imatlopez/EMG-Decoder/Mechanical/Final Mechanical Drawings and Photos/Physical2.JPG

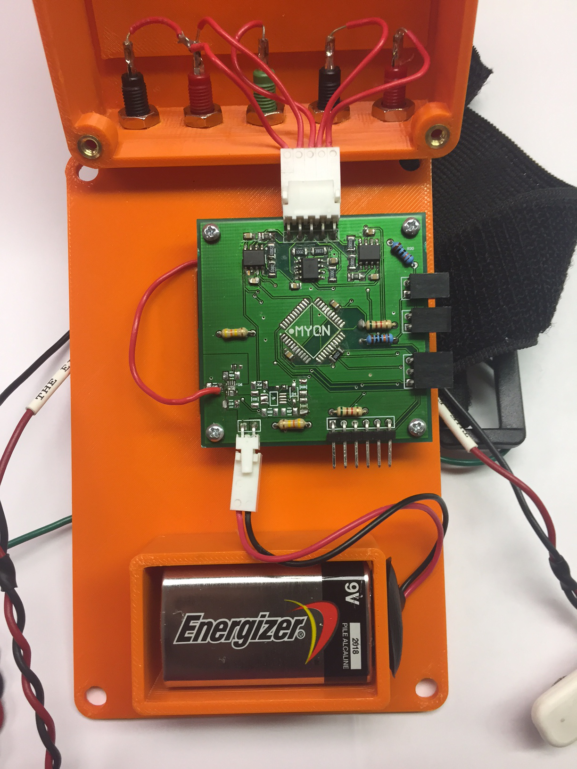
Mechanical/Final Mechanical Drawings and Photos/Physical2.JPG
