imatlopez/EMG-Decoder/Mechanical/Final Mechanical Drawings and Photos/Final Assembly Image.JPG

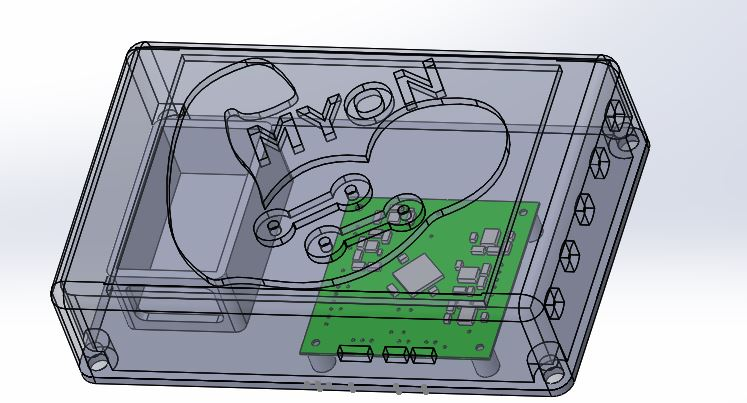
Mechanical/Final Mechanical Drawings and Photos/Final Assembly Image.JPG
