imatlopez/EMG-Decoder/Mechanical/SolidWorks Project/Mechanical Graded Checkpoint.pptx

## Mechanical Graded Checkpoint

## New Bottom Plate Design

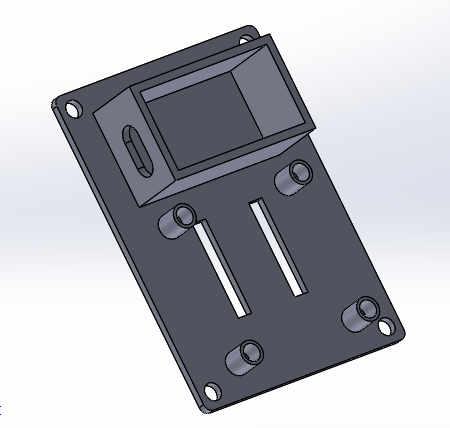
[picture p3: figure]

- 9 V battery holder
- All connections will be made with 6-32 heat inserts (diameter of holes are 0.220 inches and a draft angle of 2 degrees)
- Four elevated spacers 1.74 inches apart from each other.
- Velcro holes in order to attach to arm.

## New Cover Design

- A total of five female 2mm jack pin connectors (ground and leads)
- Two output slots (dimensions aren’t yet set)
- Case with logo on top
- Fillets with a radius of 0.1 inches for sleekness
- 3 by 4 by 1

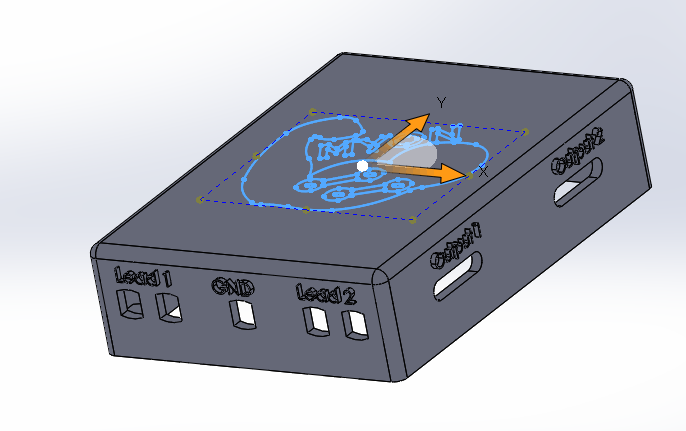
[picture p4: figure]

## Lead Connections

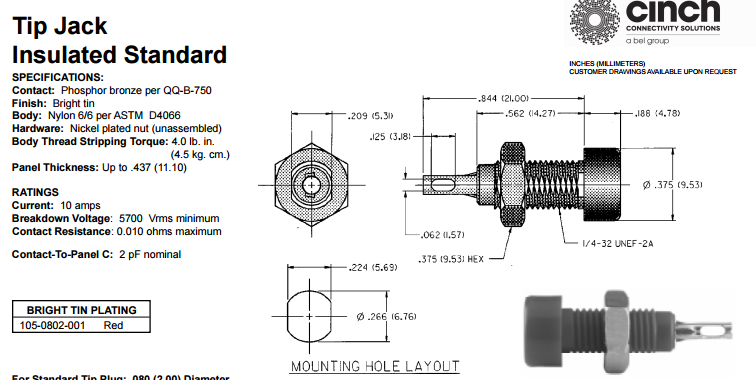
[picture p5: figure]

## Mechanical Drawings

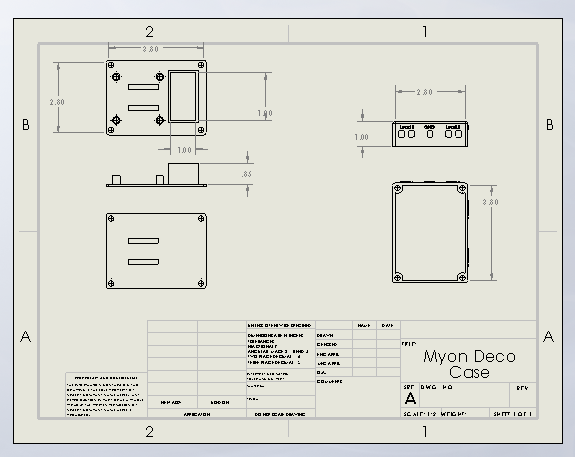
[picture p6: figure]

## Assembly View

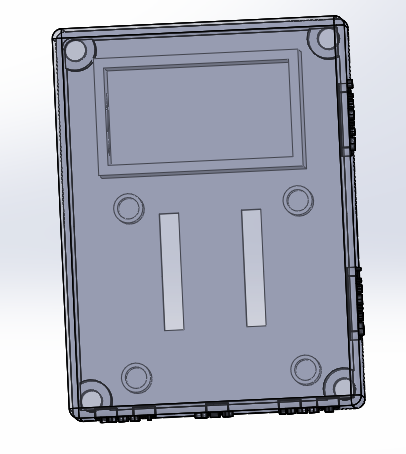
[picture p7: figure]
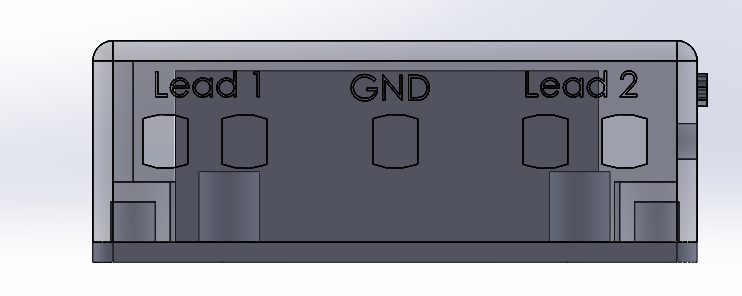
[picture p8: figure]

## Holding the Electrodes

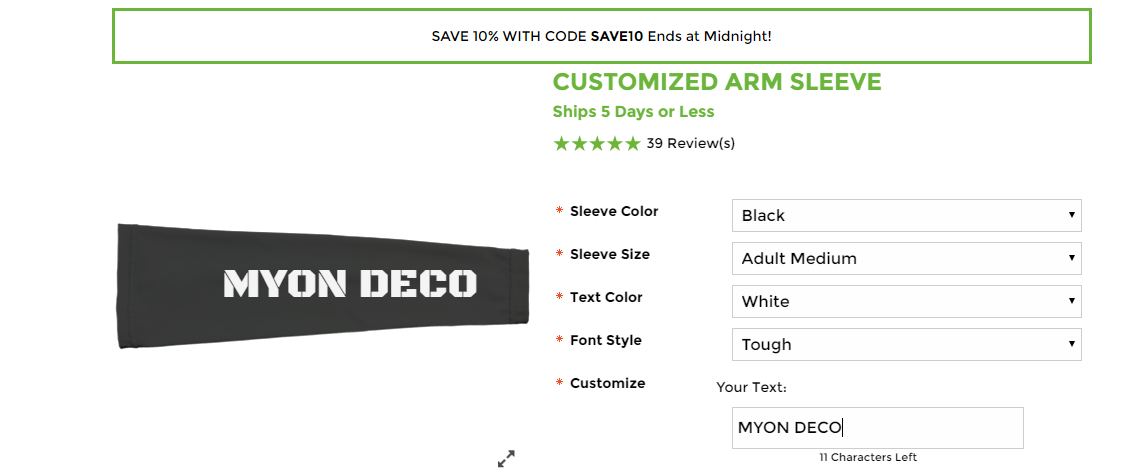
[picture p9: figure]

## Order Form for This Week

## Things still need to be done

- Need to determine output connections
- Test the heat set screws with new case and bottom plate
- Figure out compression sleeve
- Optimize location of input and output ports
