imatlopez/EMG-Decoder/Images/block.pdf

Sallen-Key
Low-Pass
Filter

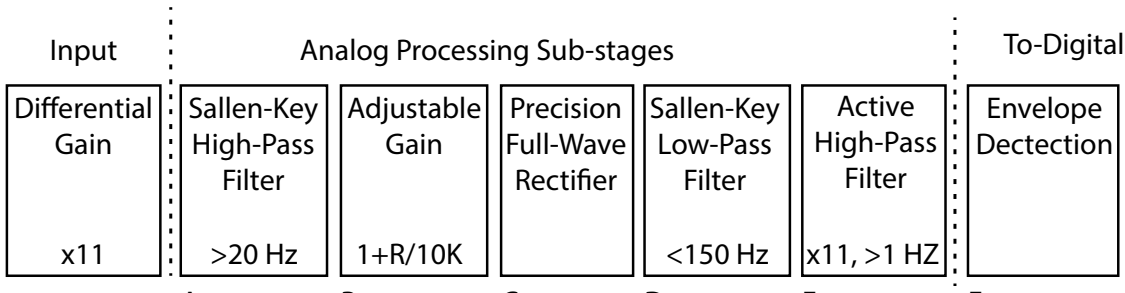
[picture p10: figure]
Dierential Gain; Sallen-Key High-Pass Filter; Adjustable Gain; Precision Full-Wave Rectier; Sallen-Key Low-Pass Filter; Active High-Pass Filter; Envelope Dectection; Input

Analog Processing Sub-stages | To-Digital Processing
x11 | >20 Hz | 1+R/10K | <150 Hz | x11, >1 HZ | x1.51, <5 Hz
A | B | C | D | E | F | G
