imatlopez/EMG-Decoder/Images/logo.pdf

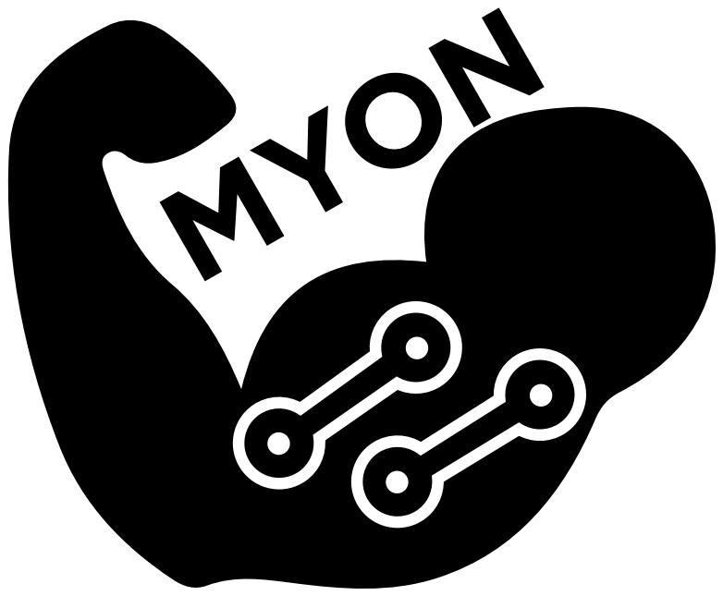
[picture p11: figure]
MYON
