imatlopez/EMG-Decoder/Images/amputee.png

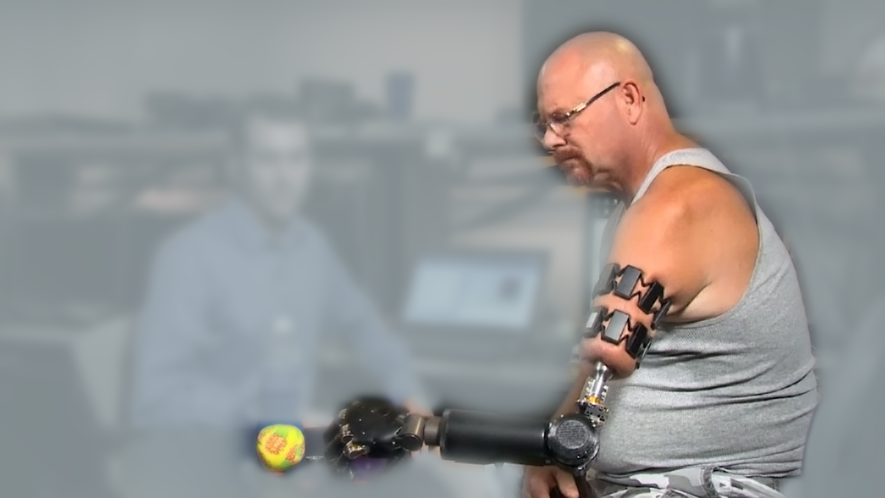
Images/amputee.png
