imatlopez/EMG-Decoder/Images/amputeecoalition.png

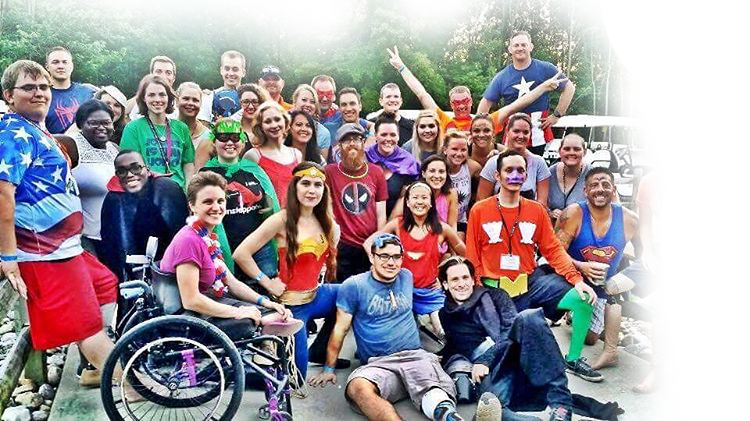
Images/amputeecoalition.png
