imatlopez/EMG-Decoder/Images/armband-proto.png

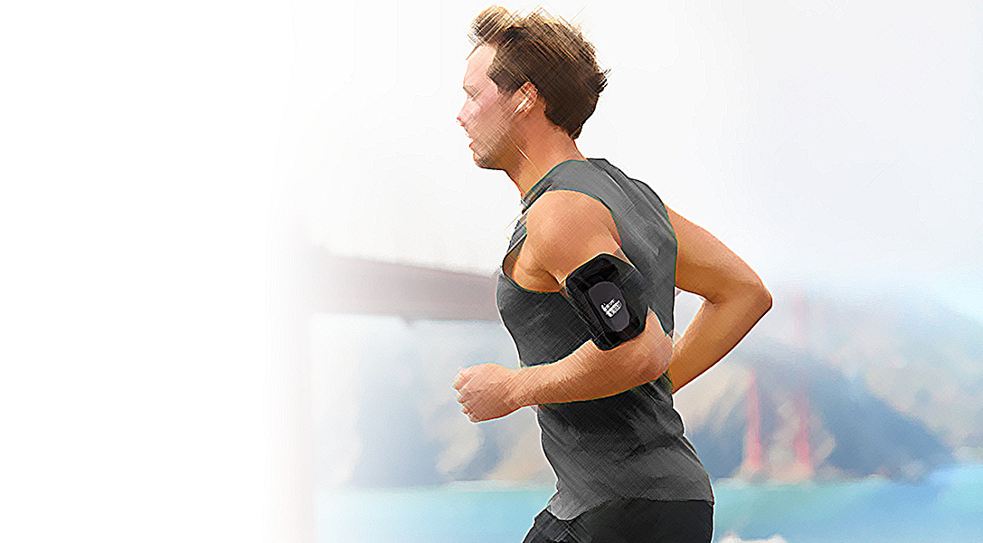
Images/armband-proto.png
