imatlopez/EMG-Decoder/Images/box.png

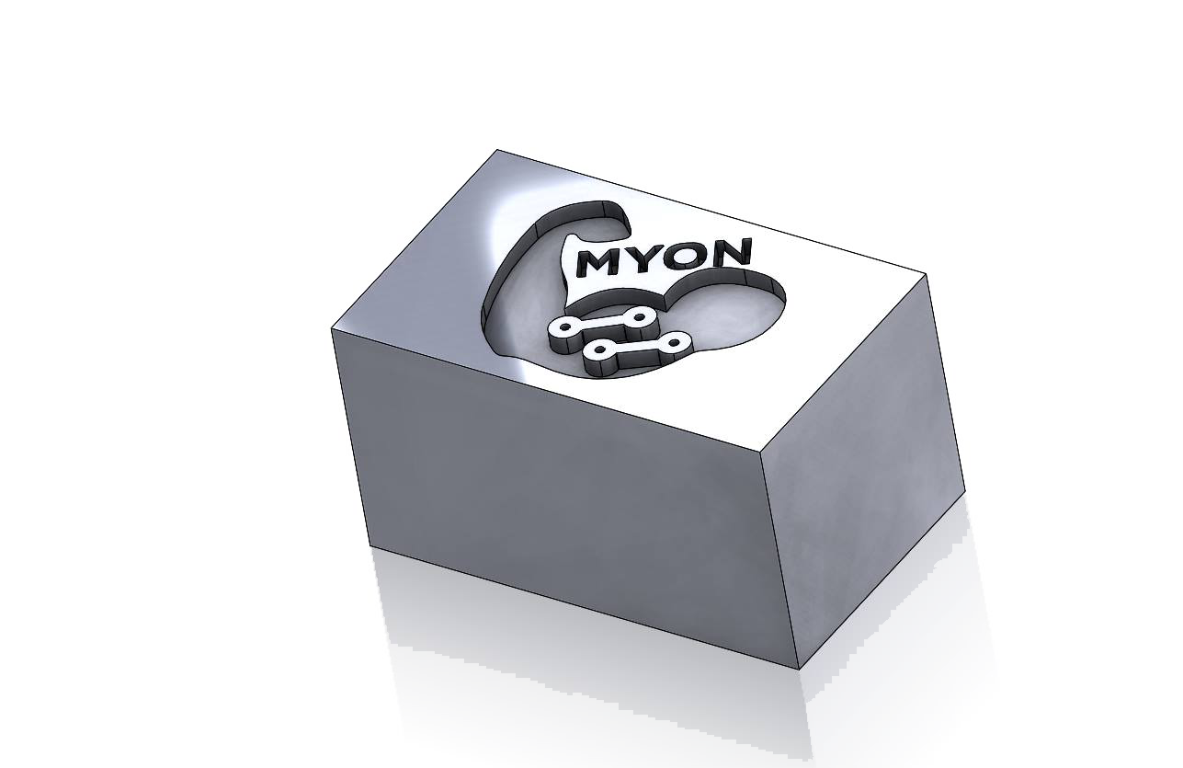
Images/box.png
