imatlopez/EMG-Decoder/Images/drone.png

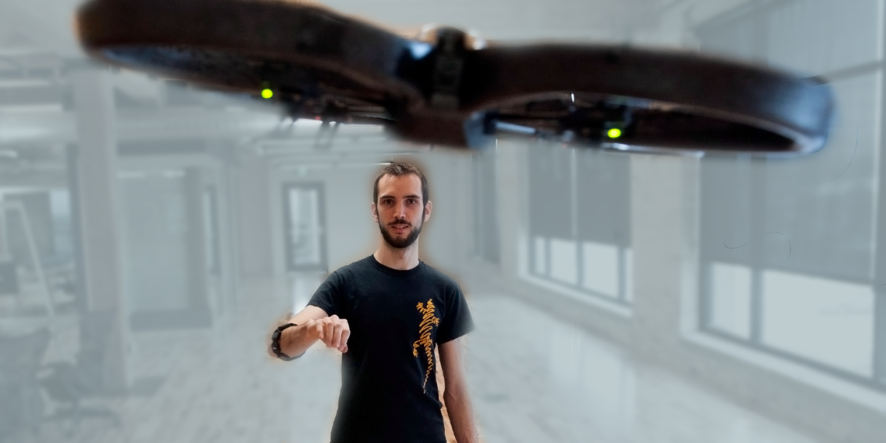
Images/drone.png
