imatlopez/EMG-Decoder/Images/muscle.png

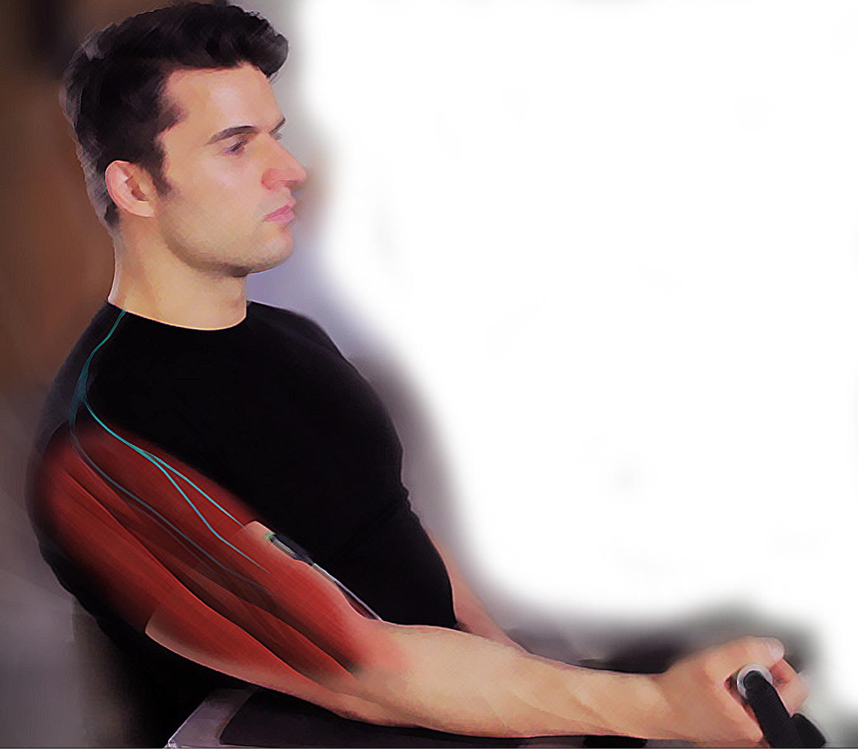
Images/muscle.png
