imatlopez/EMG-Decoder/Images/myovis.png

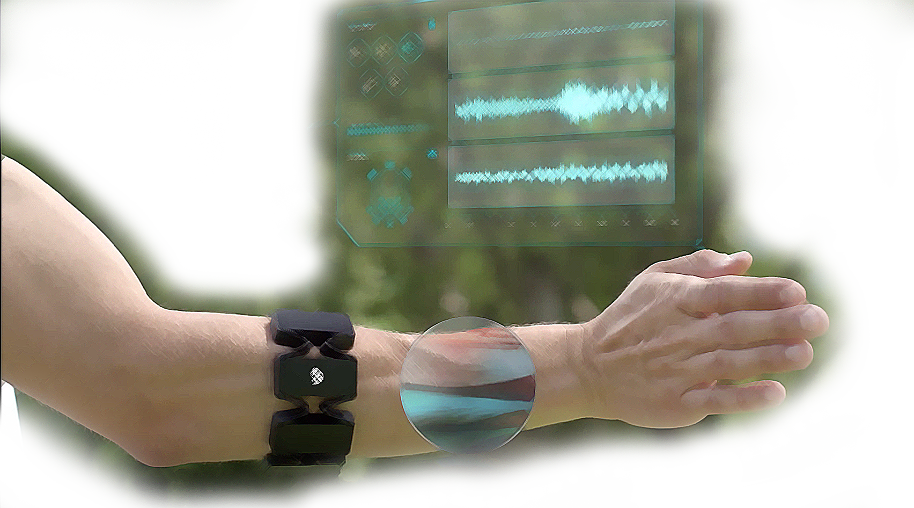
Images/myovis.png
