imatlopez/EMG-Decoder/Images/physther.png

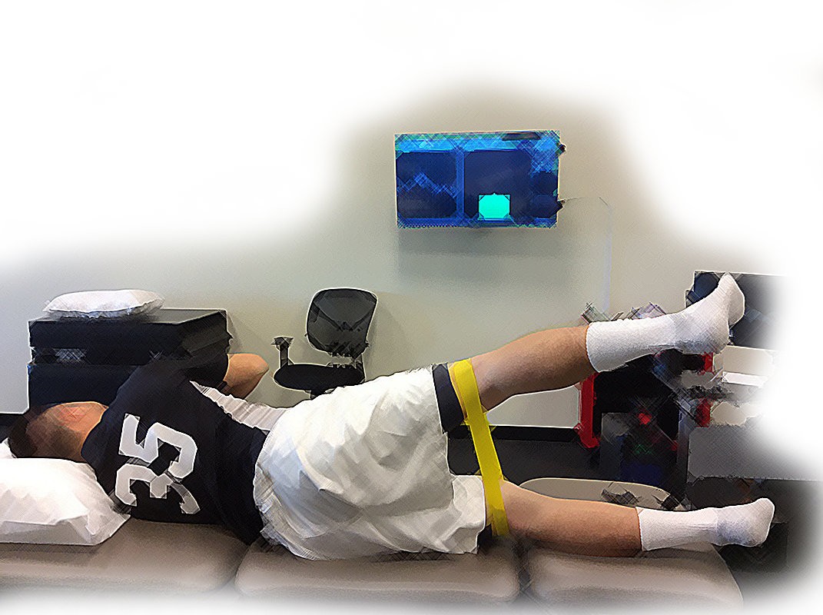
Images/physther.png
