imatlopez/EMG-Decoder/Images/surgery.png

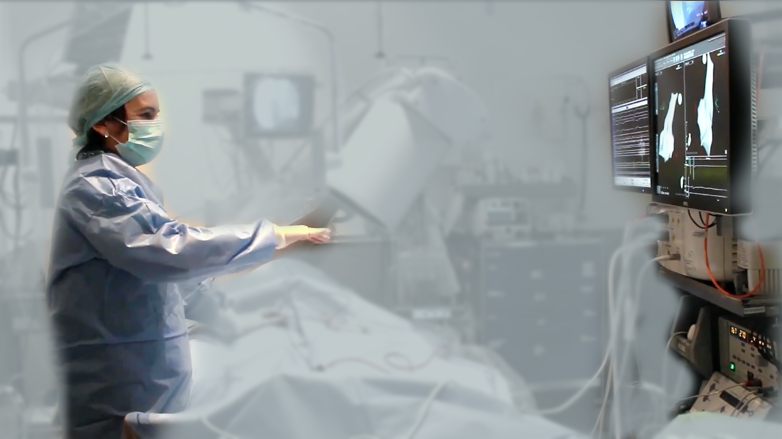
Images/surgery.png
