imatlopez/EMG-Decoder/Mechanical/Final Mechanical Drawings and Photos/FinalBottomplateDrawing.JPG

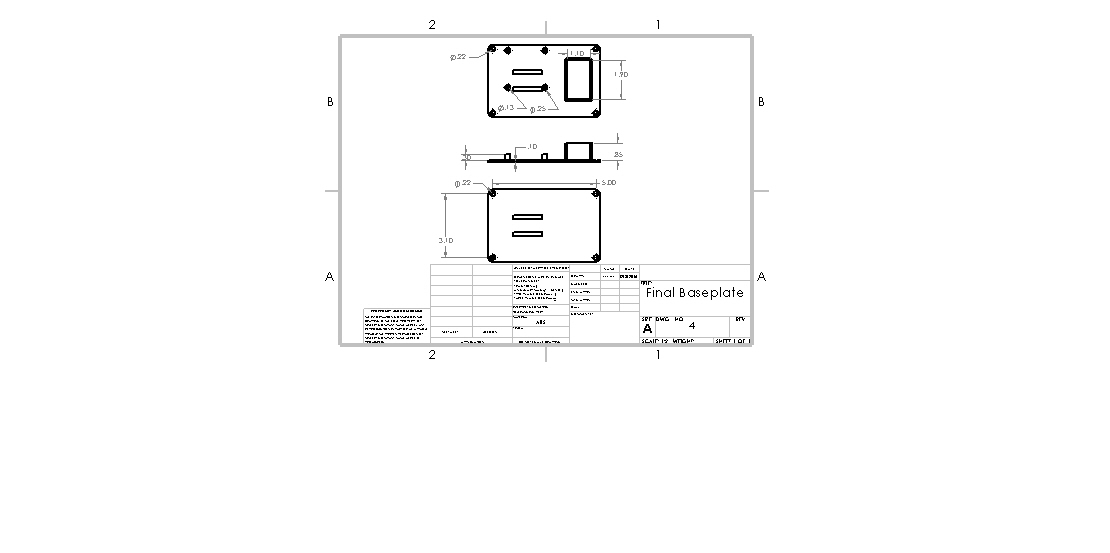
Mechanical/Final Mechanical Drawings and Photos/FinalBottomplateDrawing.JPG
