imatlopez/EMG-Decoder/Mechanical/Final Mechanical Drawings and Photos/FinalCoverDrawing.JPG

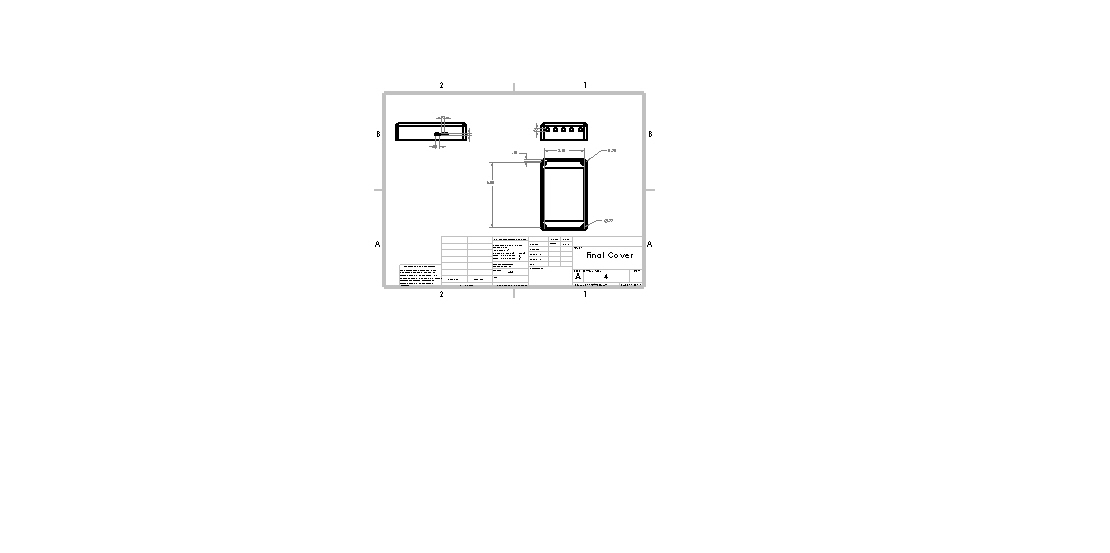
Mechanical/Final Mechanical Drawings and Photos/FinalCoverDrawing.JPG
