imatlopez/EMG-Decoder/Mechanical/Final Mechanical Drawings and Photos/Fullbody.jpg

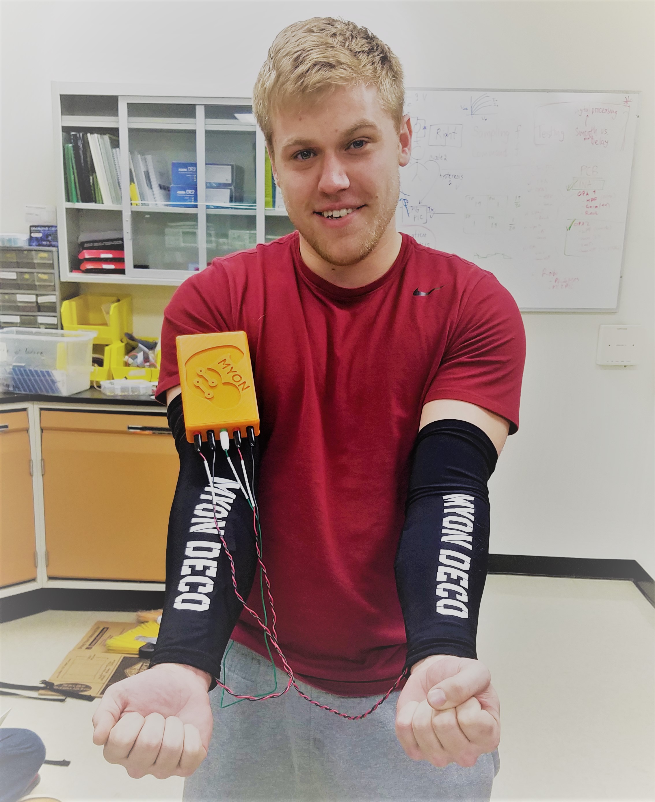
Mechanical/Final Mechanical Drawings and Photos/Fullbody.jpg
