imatlopez/EMG-Decoder/Mechanical/Final Mechanical Drawings and Photos/Physical1.JPG

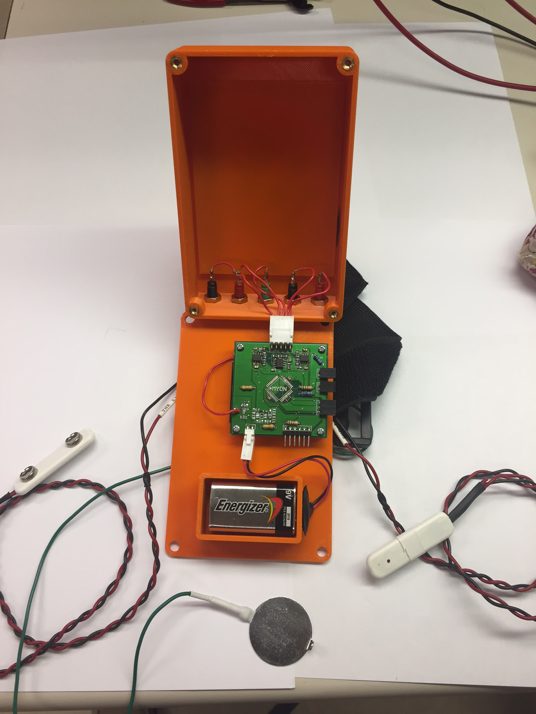
Mechanical/Final Mechanical Drawings and Photos/Physical1.JPG
