imatlopez/EMG-Decoder/Mechanical/Final Mechanical Drawings and Photos/Physical3.JPG

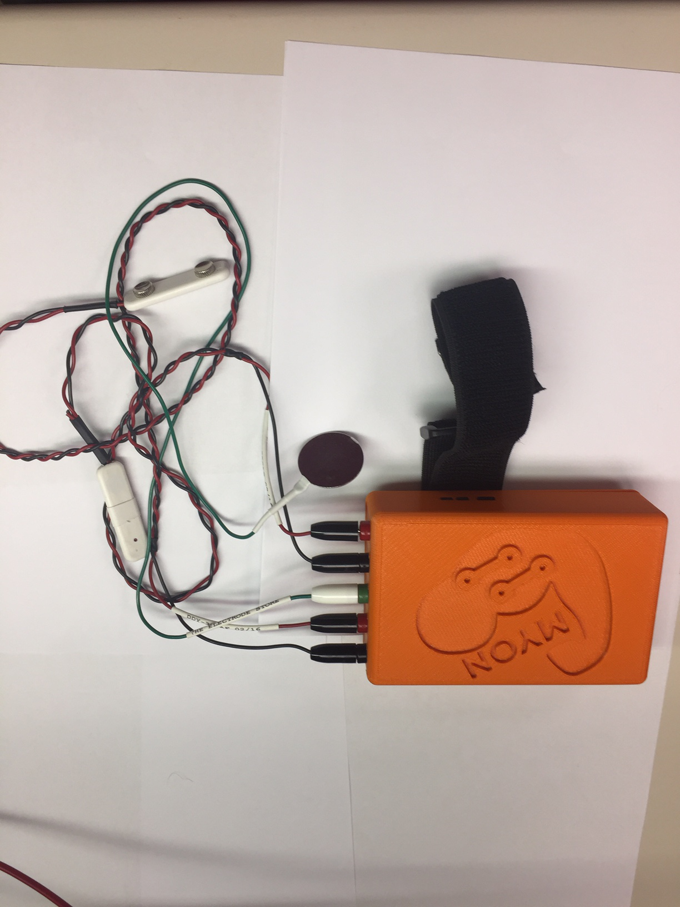
Mechanical/Final Mechanical Drawings and Photos/Physical3.JPG
