imatlopez/EMG-Decoder/Mechanical/Final Mechanical Drawings and Photos/Physical4.JPG

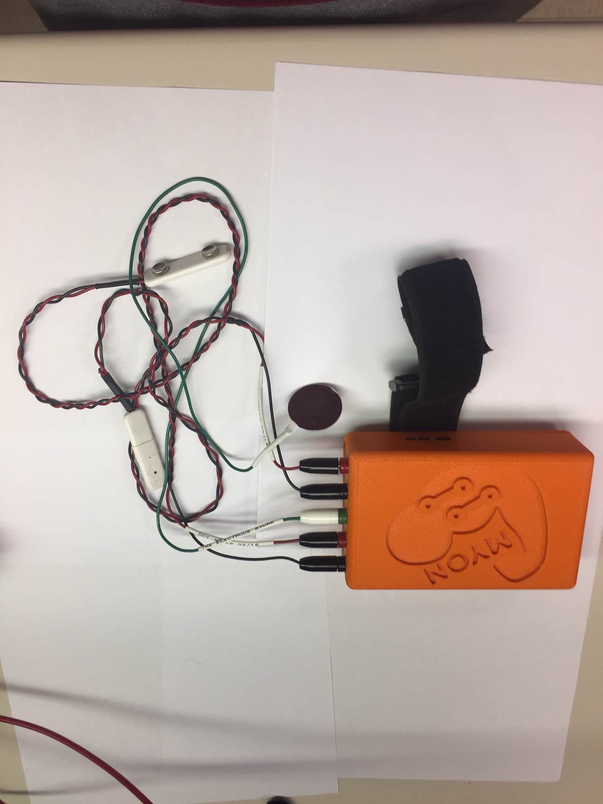
Mechanical/Final Mechanical Drawings and Photos/Physical4.JPG
