imatlopez/EMG-Decoder/Mechanical/SolidWorks Project/Invasive.PNG

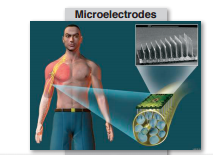
Mechanical/SolidWorks Project/Invasive.PNG
