imatlopez/EMG-Decoder/Software/SpecAutom/Anv1.png

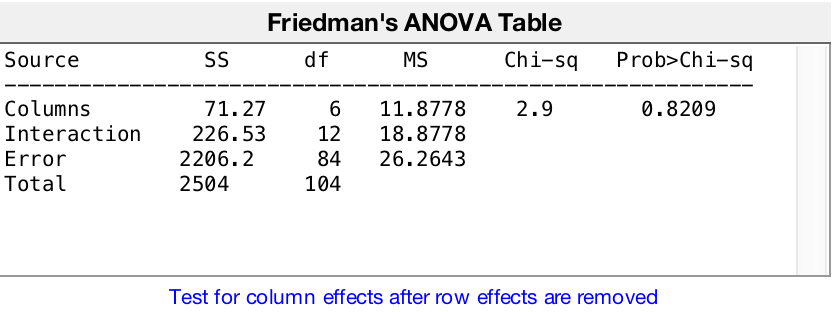
Software/SpecAutom/Anv1.png
