imatlopez/EMG-Decoder/Software/SpecAutom/CmrrAMP.png

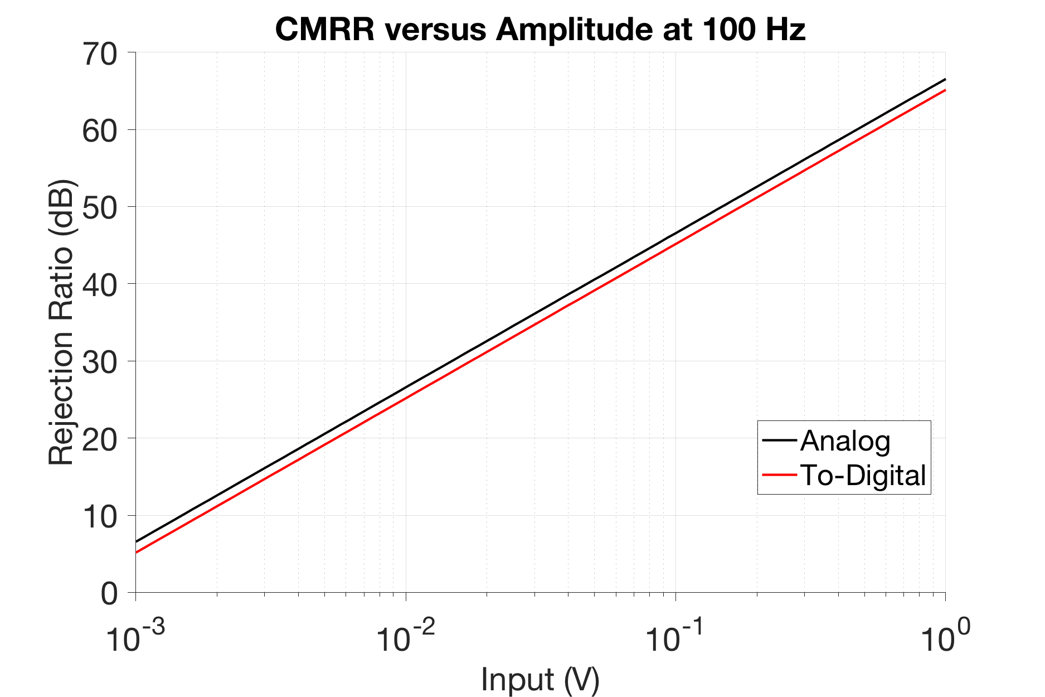
Software/SpecAutom/CmrrAMP.png
