imatlopez/EMG-Decoder/Software/SpecAutom/CmrrFRQ.png

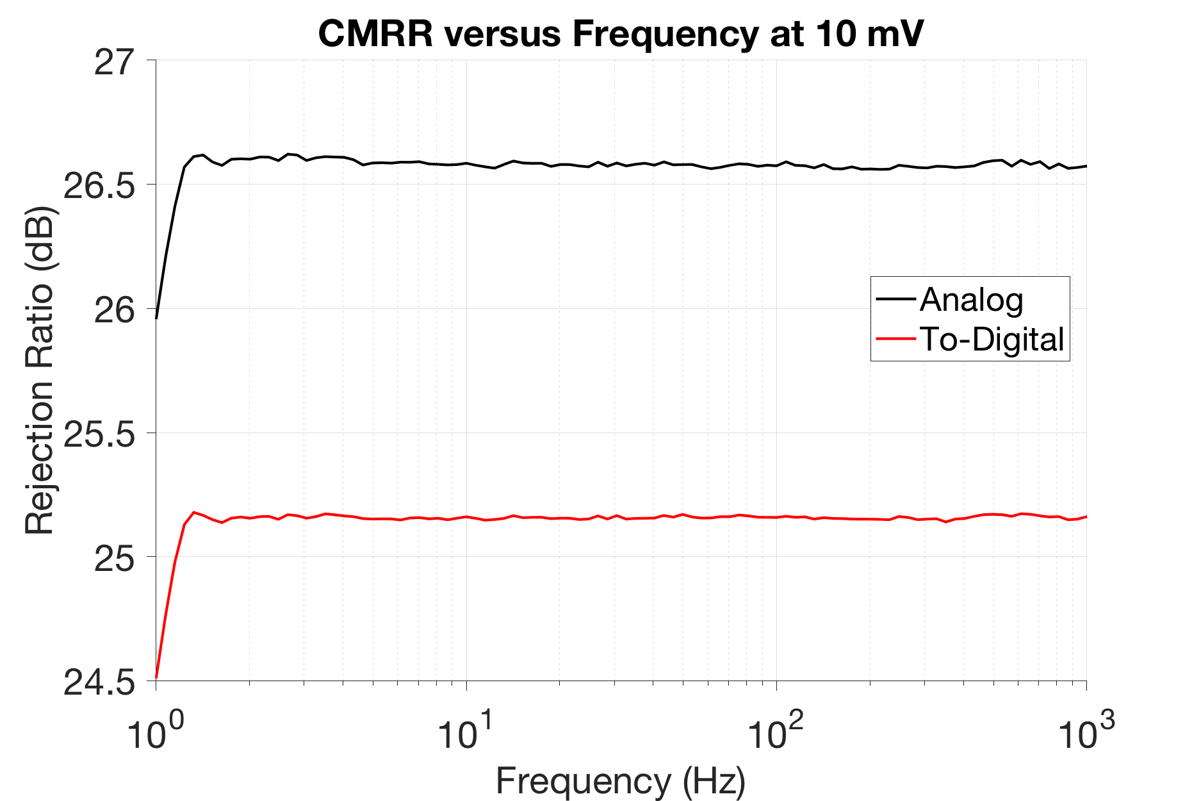
Software/SpecAutom/CmrrFRQ.png
