imatlopez/EMG-Decoder/Software/SpecAutom/FRQResp.png

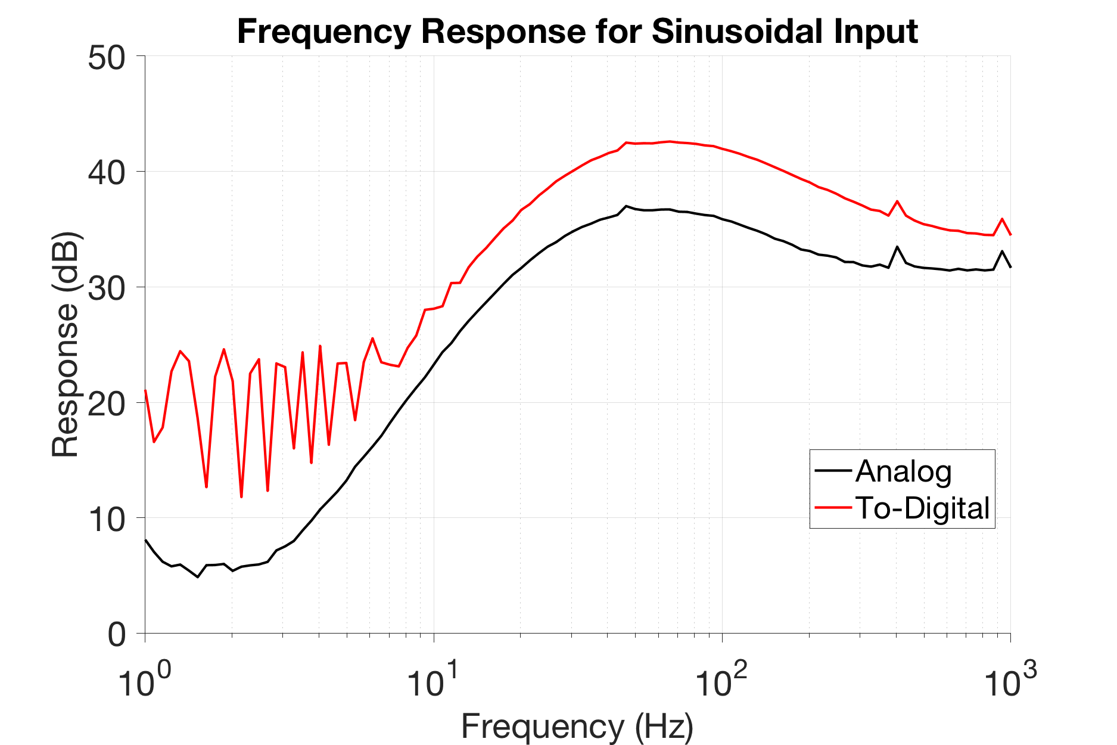
Software/SpecAutom/FRQResp.png
