imatlopez/EMG-Decoder/Software/SpecAutom/Gain.png

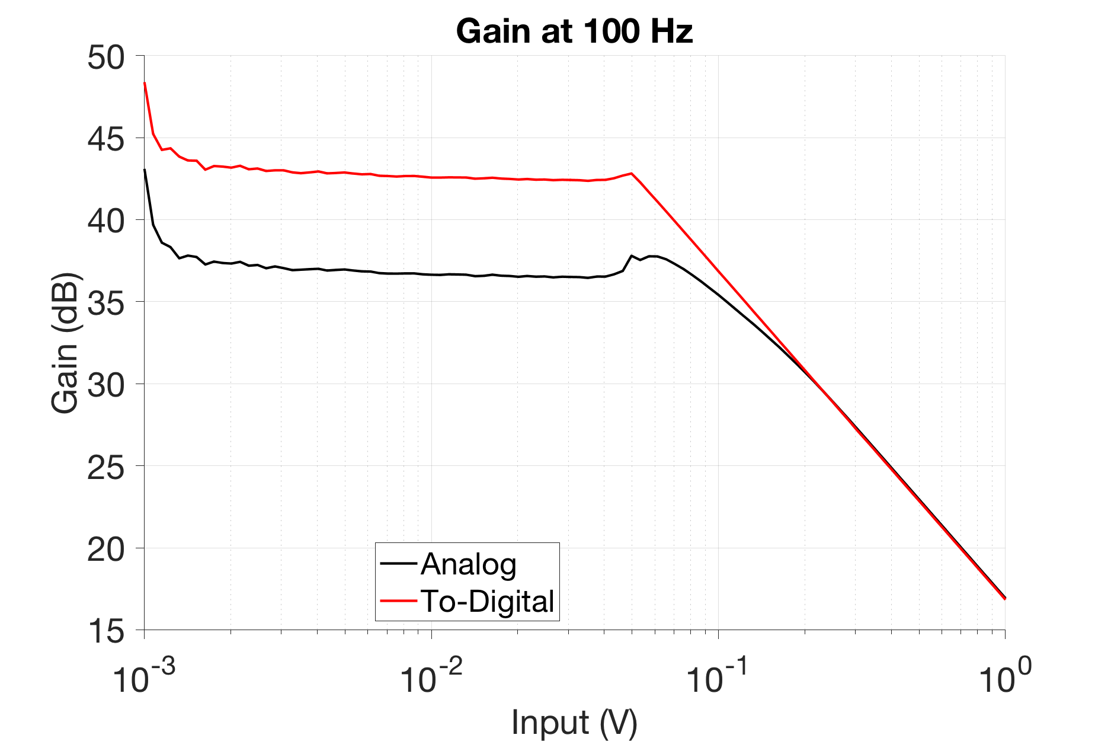
Software/SpecAutom/Gain.png
