imatlopez/EMG-Decoder/Software/SpecAutom/LpecPlot.png

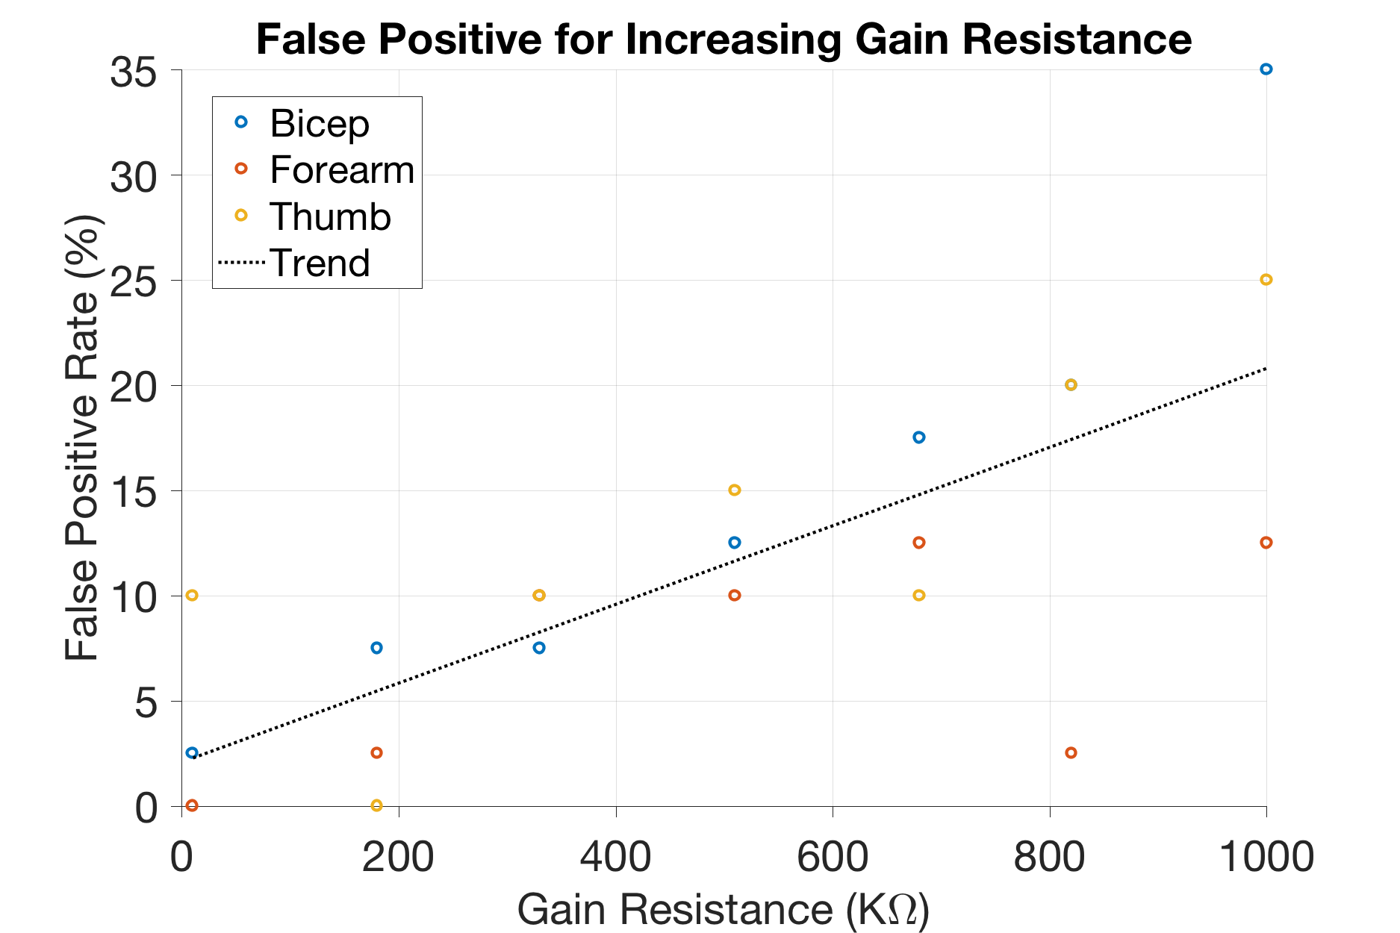
Software/SpecAutom/LpecPlot.png
