imatlopez/EMG-Decoder/Software/SpecAutom/PowerAMP.png

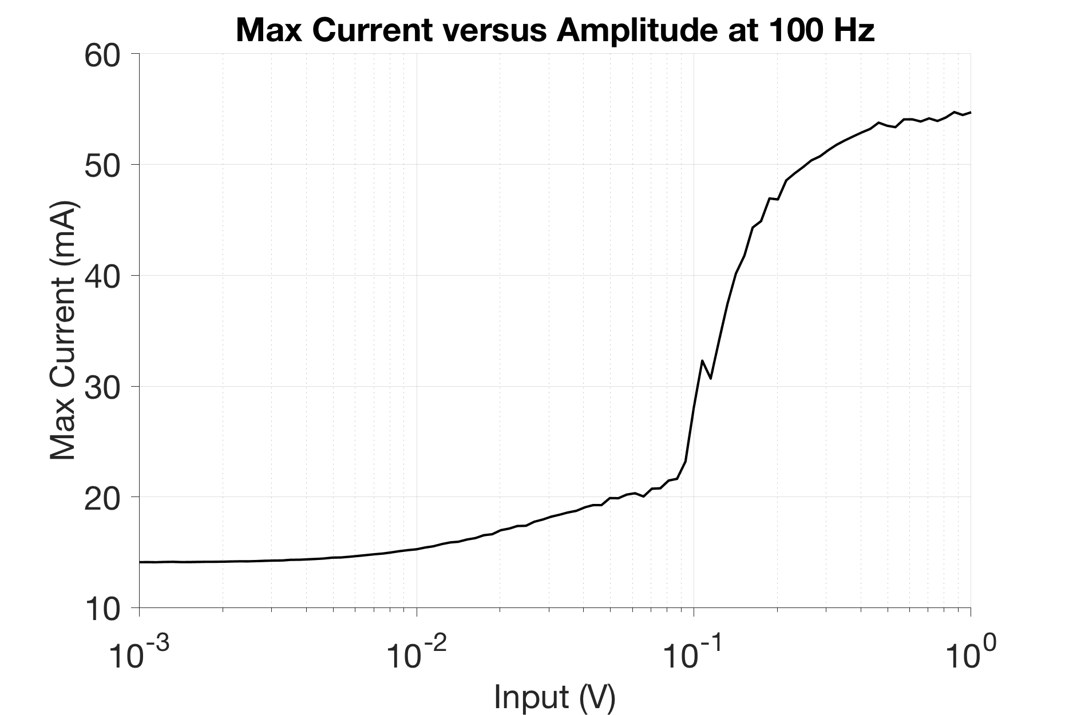
Software/SpecAutom/PowerAMP.png
