imatlopez/EMG-Decoder/Software/SpecAutom/PowerFRQ.png

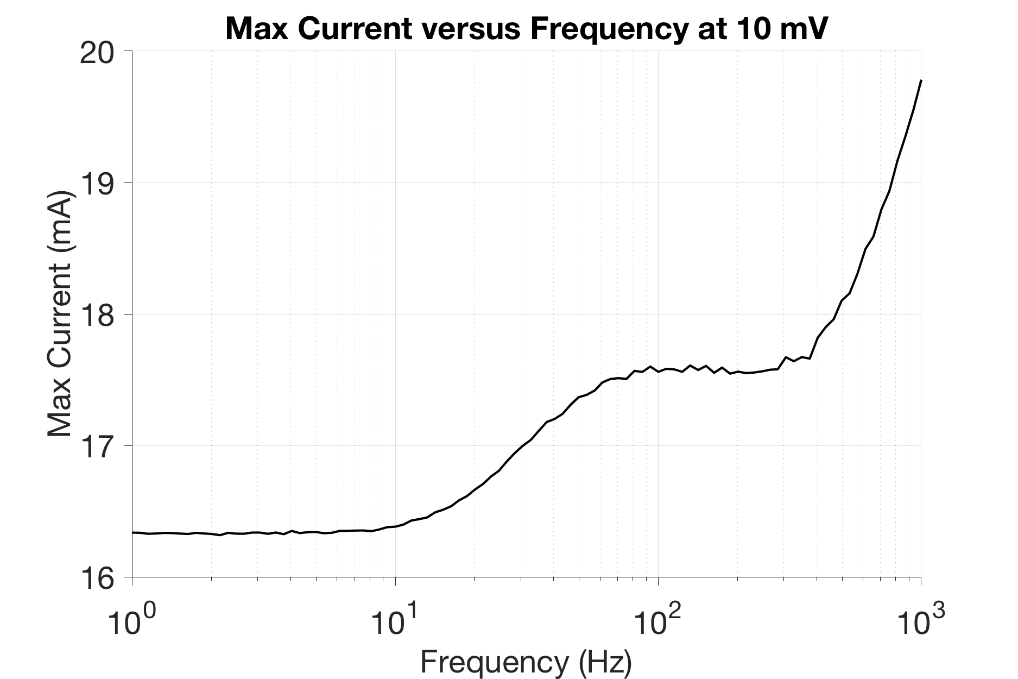
Software/SpecAutom/PowerFRQ.png
