imatlopez/EMG-Decoder/Software/SpecAutom/Proof1.png

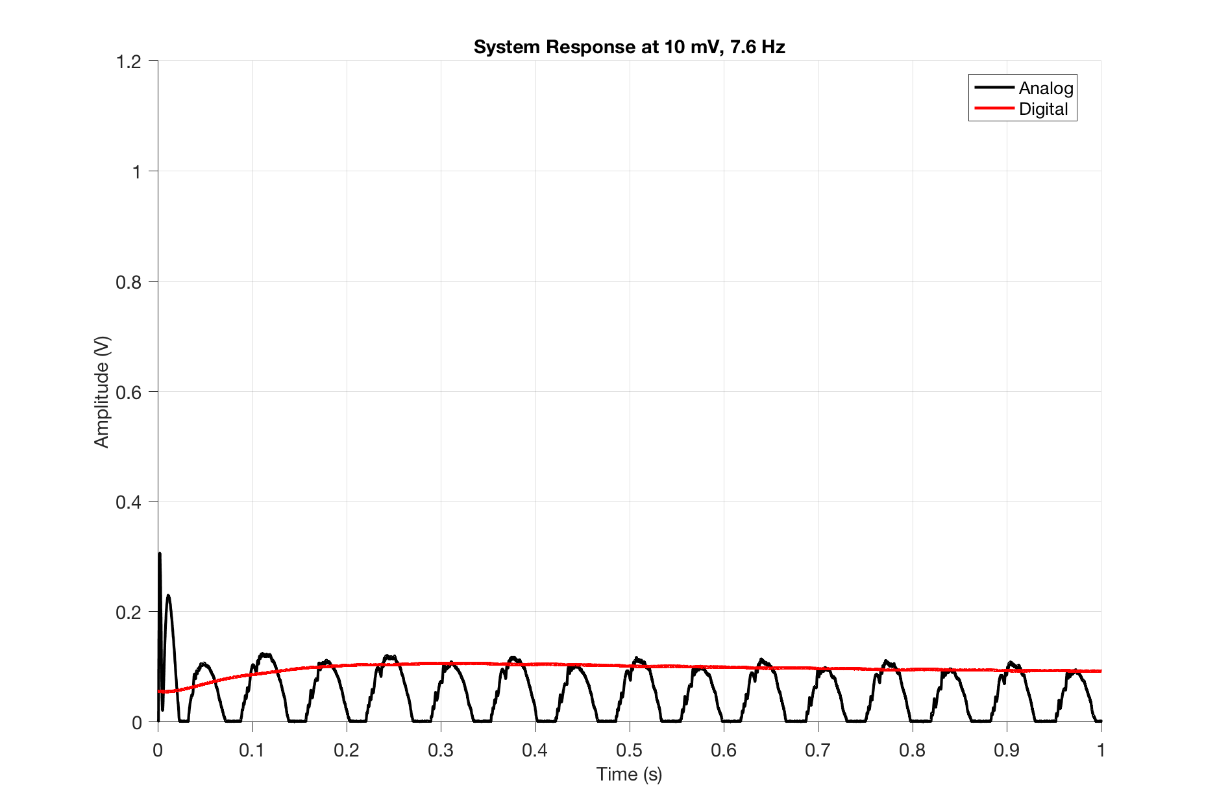
Software/SpecAutom/Proof1.png
