imatlopez/EMG-Decoder/Software/SpecAutom/Proof2.png

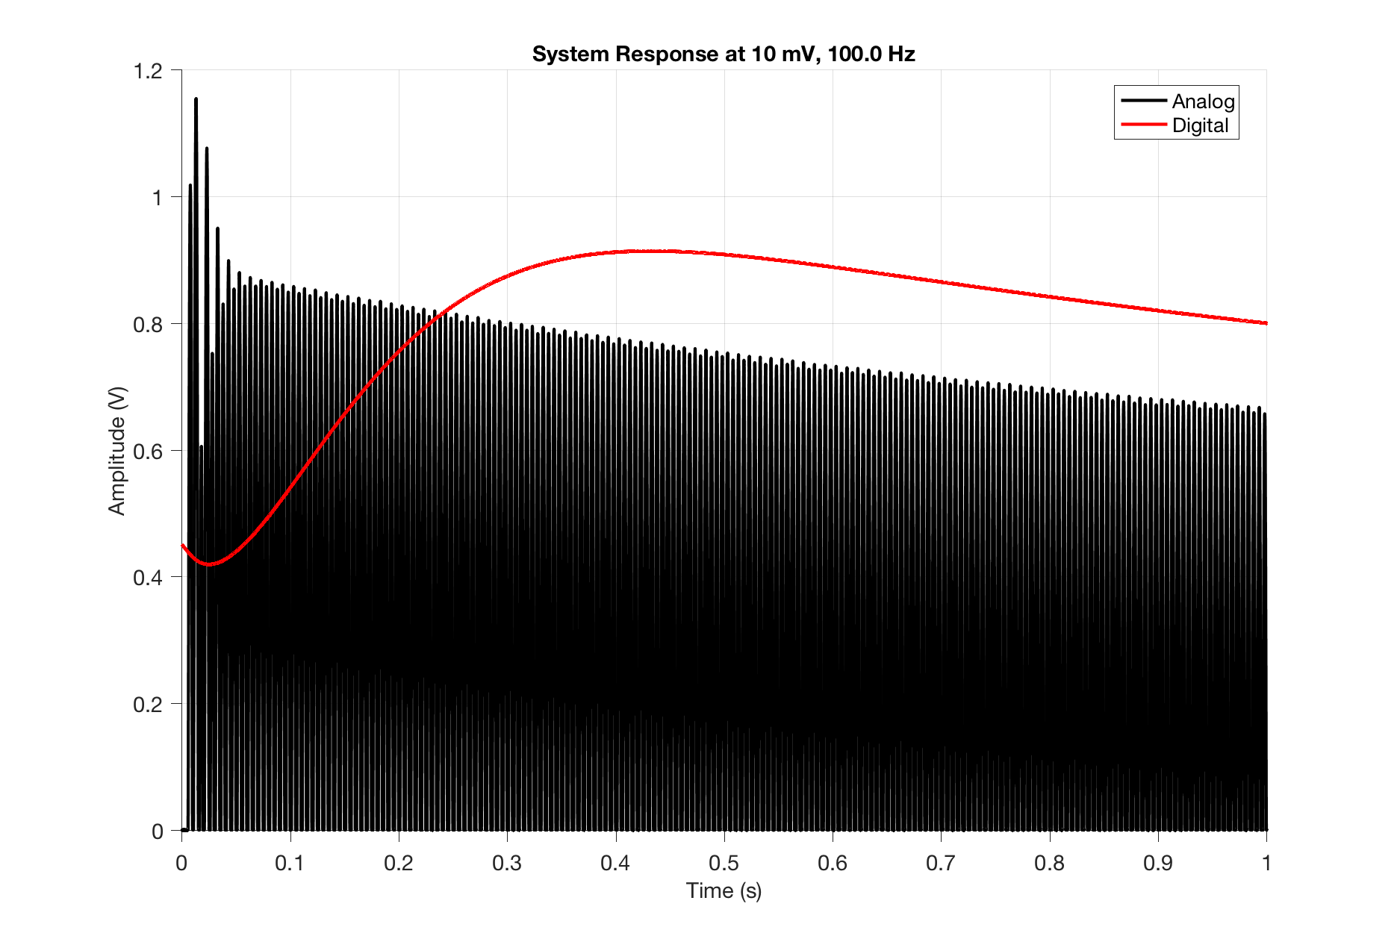
Software/SpecAutom/Proof2.png
