imatlopez/EMG-Decoder/Software/SpecAutom/Proof3.png

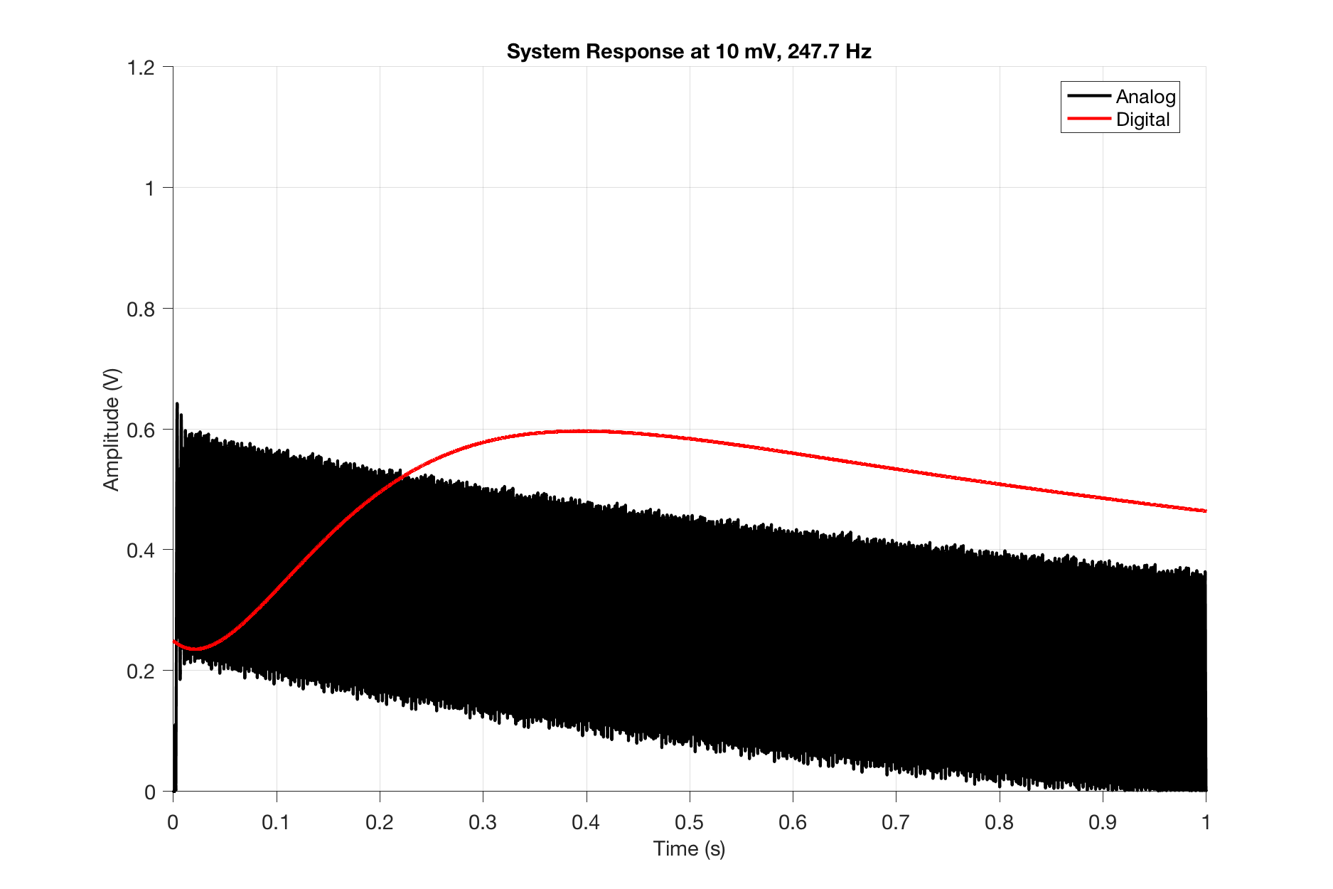
Software/SpecAutom/Proof3.png
