imatlopez/EMG-Decoder/Software/SpecAutom/SnrAMP.png

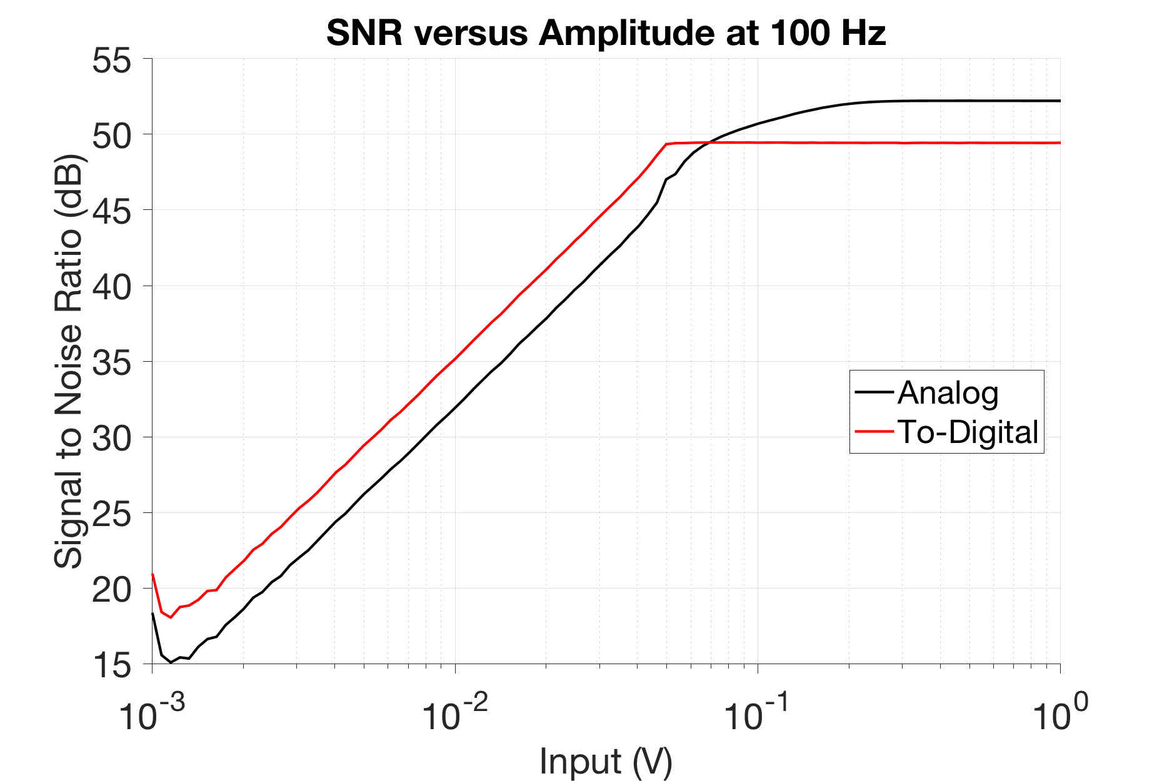
Software/SpecAutom/SnrAMP.png
