imatlopez/EMG-Decoder/Software/SpecAutom/SnrFRQ.png

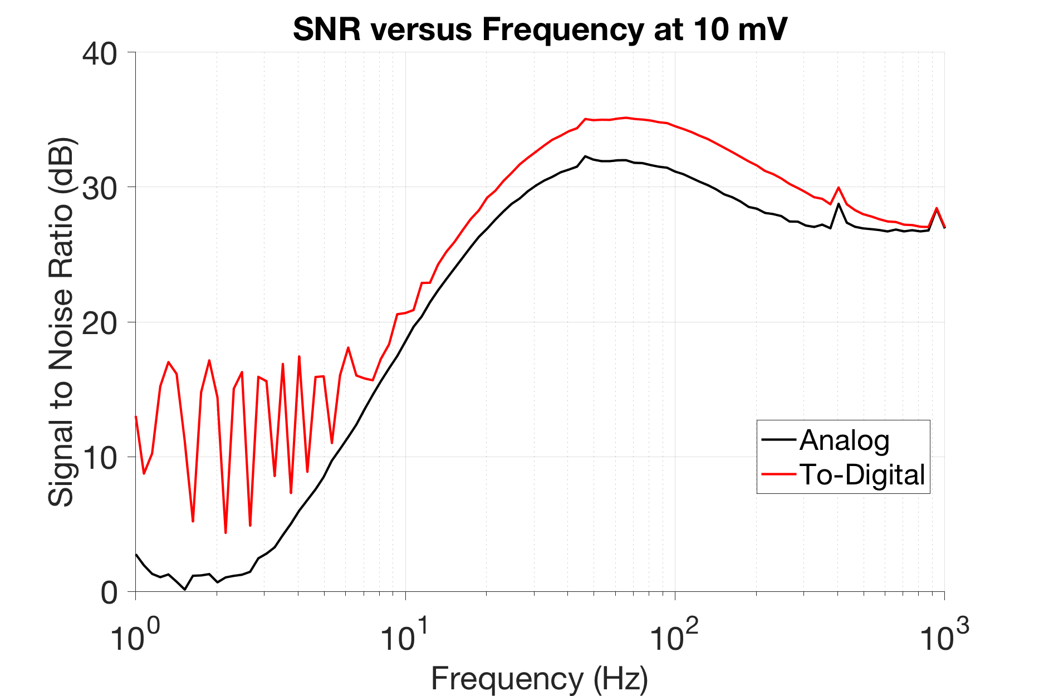
Software/SpecAutom/SnrFRQ.png
