imatlopez/EMG-Decoder/Software/SpecAutom/SpecPlot.png

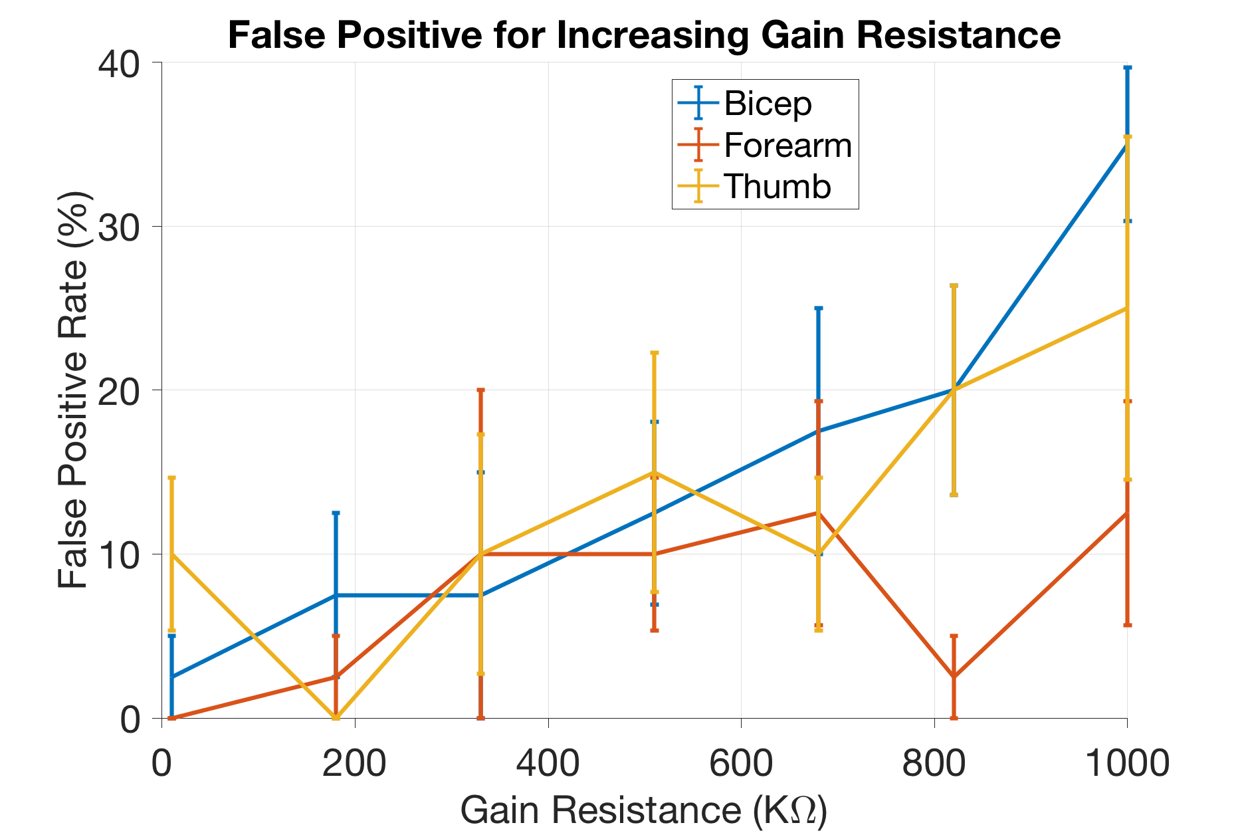
Software/SpecAutom/SpecPlot.png
