imatlopez/EMG-Decoder/Forms/Last_Order.xlsx

Name | C. Zhao | M. Lopez | A. Marellapudi | J. Scott | P. Wiboonsaksakul
Group | EMG Decoder
Date | 2016-11-11 | Orders must be submitted by email by 10 AM on Tuesday to matthewb@duke.edu to be processed on Tuesday
Vendor | Quantity | Part number | Part Description | Package | Price | Extended Price | URL (if not Mouser) | Notes
Preferred vendor is Mouser. Backups are Newark and Digikey. Please check these first for your component - arrangements can be made if your part can only come from another source (e.g. your main sensor) | Include units for quantity where necessary (5 resistors vs 5 packs of 25 resistors) |  |  | When ordering ICs, be particularly careful about package - size of chip and type of pins | Choose the right price for the quantity you are ordering - most companies offer bulk discounts | Extended price is the quantity * price |  | Include any other necessary notes for Matt to process your order
Digikey | 4 | TPS62163DGKR | 5 V Regulator | WSON8 | $2.00 | $8.00 | http://www.digikey.com/product-detail/en/texas-instruments/TPS62163DSGR/296-29898-6-ND/2782666
