imatlopez/EMG-Decoder/Forms/Mech_Order.xlsx

Name | John Scott | Aniruddh Marellapudi | Christine Zhao | Matias Lopez | Pum Wiboonsaksakul
Group | Project Name | Myon Deco
Date | Today's Date | Orders must be submitted by email by 10 AM on Tuesday to matthewb@duke.edu to be processed on Tuesday
 |  | 2016-10-23
Vendor | Quantity | Part number | Part Description | Package | Price | Extended Price | URL (if not Mouser) | Notes
Preferred vendor is Mouser. Backups are Newark and Digikey. Please check these first for your component - arrangements can be made if your part can only come from another source (e.g. your main sensor) | Include units for quantity where necessary (5 resistors vs 5 packs of 25 resistors) |  |  | When ordering ICs, be particularly careful about package - size of chip and type of pins | Choose the right price for the quantity you are ordering - most companies offer bulk discounts | Extended price is the quantity * price |  | Include any other necessary notes for Matt to process your order
Digikey | 2 | J152-ND | 2 mm jack pin connectors (black) |  | $0.65 | $1.30 | http://www.digikey.com/product-detail/en/cinch-connectivity-solutions-johnson/108-0902-001/J151-ND/5929
Digikey | 1 | J153-ND | 2mm jack pin connectors (green) |  | $0.63 | $0.63 | http://www.digikey.com/product-detail/en/cinch-connectivity-solutions-johnson/108-0904-001/J153-ND/5931
Bolt Depot | 4 | 13772 | Metric spacers, Nylon black, 4mm x 5mm (8mm O.D.). Each |  | $0.38 | 6.47 (with shipping) | https://www.boltdepot.com/Product-Details.aspx?product=13772 | 4 mm inside diameter (8 mm OD). Length is 5 mm.
Bolt Depot | 4 | 3830 | Tap stainless steel bolts that have a 5/16" diameter and a length of 1 and a half inches |  | $0.47 | $1.88 | https://www.boltdepot.com/Product-Details.aspx?product=3830 | Length of 1 and a half inches please
Bolt Depot | 4 | 2564 | Hex nuts for 5/16" tap bolt |  | $0.10 | $4.00 | https://www.boltdepot.com/Product-Details.aspx?product=2564
Bolt Depot | 4 | 2948 | Washers for 5/16" tap bolt |  | $0.06 | $0.24 | https://www.boltdepot.com/Product-Details.aspx?product=2948
