imatlopez/EMG-Decoder/Mechanical/PartsOrderForm_BME464L(Oct31).xlsx

Name | John Scott | Aniruddh Marellapudi | Christine Zhao | Matias Lopez | Pum Wiboonsaksakul
Group | Project Name | Myon Deco
Date | Today's Date | Orders must be submitted by email by 10 AM on Tuesday to matthewb@duke.edu to be processed on Tuesday
 |  | 2016-10-31
Vendor | Quantity | Part number | Part Description | Package | Price | Extended Price | URL (if not Mouser) | Notes
Preferred vendor is Mouser. Backups are Newark and Digikey. Please check these first for your component - arrangements can be made if your part can only come from another source (e.g. your main sensor) | Include units for quantity where necessary (5 resistors vs 5 packs of 25 resistors) |  |  | When ordering ICs, be particularly careful about package - size of chip and type of pins | Choose the right price for the quantity you are ordering - most companies offer bulk discounts | Extended price is the quantity * price |  | Include any other necessary notes for Matt to process your order
Digikey | 2 | PPTC031LGBN-RC | 3 position receptacle |  | $0.65 | $1.30 | http://www.digikey.com/product-search/en?keywords=PPTC031LGBN-RC
Digikey | 4 | PPTC021LGBN-RC | 2 position receptacle |  | $0.57 | $2.28 | http://www.digikey.com/product-search/en?keywords=PPTC021LGBN-RC
Custom Sports Sleeves | 1 |  | Compression Sleeve for holding EMG electrodes |  | $18.99 | $18.99 | http://www.customsportssleeves.com/customized-arm-sleeve | Would like text added to this. Font is to be "Tough". The text should read "MYON DECO". The color to be black, and the font color is white. The sleeve should be a size Medium for smaller arms
Digikey | 2 | 235 | 9V snap battery connector |  | $0.65 | $1.30 | http://www.digikey.com/product-detail/en/keystone-electronics/235/36-235-ND/303806
