imatlopez/EMG-Decoder/Forms/Power-Test_Order.xlsx

Name | C. Zhao | M. Lopez | A. Marellapudi | J. Scott | P. Wiboonsaksakul
Group | EMG Decoder
Date | 2016-11-03 | Orders must be submitted by email by 10 AM on Tuesday to matthewb@duke.edu to be processed on Tuesday
Vendor | Quantity | Part number | Part Description | Package | Price | Extended Price | URL (if not Mouser) | Notes
Preferred vendor is Mouser. Backups are Newark and Digikey. Please check these first for your component - arrangements can be made if your part can only come from another source (e.g. your main sensor) | Include units for quantity where necessary (5 resistors vs 5 packs of 25 resistors) |  |  | When ordering ICs, be particularly careful about package - size of chip and type of pins | Choose the right price for the quantity you are ordering - most companies offer bulk discounts | Extended price is the quantity * price |  | Include any other necessary notes for Matt to process your order
Mouser | 2 | TPS62160DGKR | 5 V Regulator | VSSOP8 | $1.93 | $3.86 | http://www.mouser.com/ProductDetail/Texas-Instruments/TPS62160DGKR
Mouser | 2 | C0603X104K5RACTU | 0.1 µF NP Capacitor | C1608 | $0.15 | $0.30 | http://www.mouser.com/ProductDetail/Kemet/C0603X104K5RACTU
Mouser | 3 | C3216X7R1C106M160AE | 10 µF NP Capacitor | C1206 | $0.56 | $1.68 | http://www.mouser.com/ProductDetail/TDK/C3216X7R1C106M160AE
Mouser | 2 | CGA5L1X7R0J226M160AE | 22 µF NP Capacitor | C1206 | $1.11 | $2.22 | http://www.mouser.com/ProductDetail/TDK/CGA5L1X7R0J226M160AE
Mouser | 1 | BAT46W-E3-08 | Schottsky Diode | SOD123 | $0.39 | $0.39 | http://www.mouser.com/ProductDetail/Vishay-Semiconductors/BAT46W-E3-08
Mouser | 8 | CRCW120610K0FKEA | 10 kΩ Resistor | R1206 | $0.10 | $0.80 | http://www.mouser.com/ProductDetail/Vishay-Dale/CRCW120610K0FKEA
Mouser | 2 | CRCW1206100KFKEA | 100 kΩ Resistor | R1206 | $0.10 | $0.20 | http://www.mouser.com/ProductDetail/Vishay-Dale/CRCW1206100KFKEA
Mouser | 1 | CRCW1206130KFKEA | 130 kΩ Resistor | R1206 | $0.10 | $0.10 | http://www.mouser.com/ProductDetail/Vishay-Dale/CRCW1206130KFKEA
Mouser | 1 | CRCW1206680KFKEA | 680 kΩ Resistor | R1206 | $0.10 | $0.10 | http://www.mouser.com/ProductDetail/Vishay-Dale/CRCW1206680KFKEA
Mouser | 2 | MLF1608A2R2J | 2.2 µH Inductor | L1608 | $0.24 | $0.48 | http://www.mouser.com/ProductDetail/TDK/MLF1608A2R2J
Mouser | 1 | PIC18F46K22-I/PT | Microcontroller | TQFP44 | $3.59 | $3.59 | http://www.mouser.com/ProductDetail/Microchip/PIC18F46K22-I-PT
 |  |  |  |  |  | $13.72
