imatlopez/EMG-Decoder/Forms/Transducer-Test_Order.xlsx

Name | C. Zhao | M. Lopez | A. Marellapudi | J. Scott | P. Wiboonsaksakul
Group | EMG Decoder
Date | 2016-09-18 | Orders must be submitted by email by 10 AM on Tuesday to matthewb@duke.edu to be processed on Tuesday
Vendor | Quantity | Part number | Part Description | Package | Price | Extended Price | URL (if not Mouser) | Notes
Preferred vendor is Mouser. Backups are Newark and Digikey. Please check these first for your component - arrangements can be made if your part can only come from another source (e.g. your main sensor) | Include units for quantity where necessary (5 resistors vs 5 packs of 25 resistors) |  |  | When ordering ICs, be particularly careful about package - size of chip and type of pins | Choose the right price for the quantity you are ordering - most companies offer bulk discounts | Extended price is the quantity * price |  | Include any other necessary notes for Matt to process your order
Mouser | 1 | ICL7660SIPAZ | Voltage Pump | DIP8 | $1.73 | $1.73 | http://www.mouser.com/ProductDetail/Intersil/ICL7660SIPAZ
Mouser | 1 | L7805CV | 5V Regulator | TO222 | $0.43 | $0.43 | http://www.mouser.com/ProductDetail/STMicroelectronics/L7805CV
Mouser | 1 | INA128PA | Instrumentation Amp | DIP8 | $7.92 | $7.92 | http://www.mouser.com/ProductDetail/Texas-Instruments/INA128PA
Mouser | 4 | OPA2228 | Operational Amp | DIP8 | $9.72 | $38.88 | http://www.mouser.com/ProductDetail/Texas-Instruments/OPA2228P
Mouser | 1 | ISO124P | Isolation Amplifier | DIP8 | $18.94 | $18.94 | http://www.mouser.com/ProductDetail/Texas-Instruments/ISO124P
Electrode Store | 2 | DDY-30SAF | Reusable Bar Electrode | N/A | $25.00 | $50.00 | http://electrodestore.com/collections/emg-surface-electrodes/products/ddy-30saf-reusable-bar-electrode
Electrode Store | 1 | EVR-541(24)S | Grounding Electrode | N/A | $15.50 | $15.50 | http://electrodestore.com/collections/emg-surface-electrodes/products/evr-541-24-s-reusable-ground-electrodes
Mouser | 1 | FG18X7R1H334KRT06 | 0.33 µF NP Capacitor | N/A | $0.38 | $0.38 | http://www.mouser.com/ProductDetail/TDK/FG18X7R1H334KRT06
Mouser | 12 | FG18X7R1H104KNT06 | 0.1 µF NP Capacitor | N/A | $0.25 | $3.00 | http://www.mouser.com/ProductDetail/TDK/FG18X7R1H104KNT06
Mouser | 2 | B43851A4106M | 10 µF P Capacitor | N/A | $0.96 | $1.92 | http://www.mouser.com/ProductDetail/Intersil/B43851A4106M
 |  |  |  |  |  | $361.30
