imatlopez/EMG-Decoder/Forms/Build_Order.xlsx

Name | C. Zhao | M. Lopez | A. Marellapudi | J. Scott | P. Wiboonsaksakul
Group | EMG Decoder
Date | 2016-11-16 | Orders must be submitted by email by 10 AM on Tuesday to matthewb@duke.edu to be processed on Tuesday
Vendor | Quantity | Part number | Part Description | Package | Price | Extended Price | URL (if not Mouser) | Notes
Preferred vendor is Mouser. Backups are Newark and Digikey. Please check these first for your component - arrangements can be made if your part can only come from another source (e.g. your main sensor) | Include units for quantity where necessary (5 resistors vs 5 packs of 25 resistors) |  |  | When ordering ICs, be particularly careful about package - size of chip and type of pins | Choose the right price for the quantity you are ordering - most companies offer bulk discounts | Extended price is the quantity * price |  | Include any other necessary notes for Matt to process your order
Mouser | 4 | TPS62160DGKR | 5 V Regulator | VSSOP8 | $1.93 | $7.72 | http://www.mouser.com/ProductDetail/Texas-Instruments/TPS62160DGKR
Mouser | 4 | INA128UA | Instrumentation Amp | SOIC8 | $8.37 | $33.48 | http://www.mouser.com/ProductDetail/Texas-Instruments/INA128UA
Mouser | 4 | OPA2188AIDR | Operational Amp | SOIC8 | $3.33 | $13.32 | http://www.mouser.com/ProductDetail/Texas-Instruments/OPA2188AIDR
Mouser | 8 | OPA4188AIDR | Operational Amp | SOIC14 | $5.00 | $40.00 | http://www.mouser.com/ProductDetail/Texas-Instruments/OPA4188AIDR
Mouser | 4 | 08051A470JAT2A | 47 pF NP Capacitor | C0805 | $0.10 | $0.40 | http://www.mouser.com/ProductDetail/AVX/08051A470JAT2A
Mouser | 48 | 08055C104JAT2A | 0.1 µF NP Capacitor | C0805 | $0.10 | $4.80 | http://www.mouser.com/ProductDetail/AVX/08055C104JAT2A
Mouser | 4 | VJ0805Y105JXQTW1BC | 1 µF NP Capacitor | C0805 | $0.10 | $0.40 | http://www.mouser.com/ProductDetail/Vishay-Vitramon/VJ0805Y105JXQTW1BC/
Mouser | 6 | 12063D106KAT2A | 10 µF NP Capacitor | C1206 | $0.13 | $0.78 | http://www.mouser.com/ProductDetail/AVX/12063D106KAT2A
Mouser | 4 | GRM31CR61A226KE19L | 22 µF NP Capacitor | C1206 | $0.32 | $1.28 | http://www.mouser.com/ProductDetail/Murata-Electronics/GRM31CR61A226KE19L
Mouser | 2 | BAT46W-E3-08 | Schottsky Diode | SOD123 | $0.39 | $0.78 | http://www.mouser.com/ProductDetail/Vishay-Semiconductors/BAT46W-E3-08
Mouser | 12 | 1N4148W-E3-08 | 1N4148 Diode | SOD123 | $0.23 | $2.76 | http://www.mouser.com/ProductDetail/Vishay-Semiconductors/1N4148W-E3-08
Mouser | 8 | CRCW120651R0FKEA | 51 Ω Resistor | R1206 | $0.10 | $0.80 | http://www.mouser.com/ProductDetail/Vishay-Dale/CRCW120651R0FKEA
Mouser | 12 | CRCW12061K00FKEA | 1 kΩ Resistor | R1206 | $0.10 | $1.20 | http://www.mouser.com/ProductDetail/Vishay-Dale/CRCW12061K00FKEA
Mouser | 8 | CRCW12062K80FKEA | 2.8 kΩ Resistor | R1206 | $0.10 | $0.80 | http://www.mouser.com/ProductDetail/Vishay-Dale/CRCW12062K80FKEA
Mouser | 8 | CRCW12067K50FKEA | 7.5 kΩ Resistor | R1206 | $0.10 | $0.80 | http://www.mouser.com/ProductDetail/Vishay-Dale/CRCW12067K50FKEA
Mouser | 18 | CRCW120610K0FKEA | 10 kΩ Resistor | R1206 | $0.10 | $1.80 | http://www.mouser.com/ProductDetail/Vishay-Dale/CRCW120610K0FKEA
Mouser | 8 | CRCW120675K0FKEA | 75 kΩ Resistor | R1206 | $0.10 | $0.80 | http://www.mouser.com/ProductDetail/Vishay-Dale/CRCW120675K0FKEA
Mouser | 4 | CRCW1206100KFKEA | 100 kΩ Resistor | R1206 | $0.10 | $0.40 | http://www.mouser.com/ProductDetail/Vishay-Dale/CRCW1206100KFKEA
Mouser | 2 | CRCW1206130KFKEA | 130 kΩ Resistor | R1206 | $0.10 | $0.20 | http://www.mouser.com/ProductDetail/Vishay-Dale/CRCW1206130KFKEA
Mouser | 8 | CRCW1206390KFKEA | 390 kΩ Resistor | R1206 | $0.11 | $0.88 | http://www.mouser.com/ProductDetail/Vishay-Dale/CRCW1206390KFKEA
Mouser | 6 | CRCW1206680KFKEA | 680 kΩ Resistor | R1206 | $0.10 | $0.60 | http://www.mouser.com/ProductDetail/Vishay-Dale/CRCW1206680KFKEA
Mouser | 16 | CRCW12061M00FKEA | 1 MΩ Resistor | R1206 | $0.10 | $1.60 | http://www.mouser.com/ProductDetail/Vishay-Dale/CRCW12061M00FKEA
Mouser | 4 | MLF1608A2R2J | 2.2 µH Inductor | L0603 | $0.24 | $0.96 | http://www.mouser.com/ProductDetail/TDK/MLF1608A2R2J
Mouser | 2 | PIC18F46K22-I/PT | Microcontroller | TQFP44 | $3.59 | $7.18 | http://www.mouser.com/ProductDetail/Microchip/PIC18F46K22-I-PT
Mouser | 2 | 22-05-3021 | 2pos WTB | Header | $0.30 | $0.60 | http://www.mouser.com/ProductDetail/Molex/22-05-3021
Mouser | 2 | 22-05-3051 | 5pos WTB | Header | $0.54 | $1.08 | http://www.mouser.com/ProductDetail/Molex/22-05-3051
Mouser | 2 | 22-01-2025 | 2pos WTB | Connector | $0.25 | $0.50 | http://www.mouser.com/ProductDetail/Molex/22-01-2025
Mouser | 2 | 22-01-2055 | 5pos WTB | Connector | $0.39 | $0.78 | http://www.mouser.com/ProductDetail/Molex/22-01-2055
Mouser | 14 | 50212-8100 | Wire Crimp | N/A | $0.25 | $3.50 | http://www.mouser.com/ProductDetail/Molex/50212-8100
Mouser | 2 | 22-28-8060 | 6pos Breakaway | Header | $0.46 | $0.92 | http://www.mouser.com/ProductDetail/Molex/22-28-8060
Digikey | 2 | PPTC031LGBN-RC | 3 position receptacle |  | $0.65 | $1.30 | http://www.digikey.com/product-search/en?keywords=PPTC031LGBN-RC
Digikey | 4 | PPTC021LGBN-RC | 2 position receptacle |  | $0.57 | $2.28 | http://www.digikey.com/product-search/en?keywords=PPTC021LGBN-RC
Custom Sports Sleeves | 1 |  | Compression Sleeve for holding EMG electrodes |  | $18.99 | $18.99 | http://www.customsportssleeves.com/customized-arm-sleeve | Would like text added to this. Font is to be "Tough". The text should read "MYON DECO". The color to be black, and the font color is white. The sleeve should be a size Medium for smaller arms
Digikey | 2 | 235 | 9V snap battery connector |  | $0.65 | $1.30 | http://www.digikey.com/product-detail/en/keystone-electronics/235/36-235-ND/303806
Digikey | 2 | J152-ND | 2 mm jack pin connectors (black) |  | $0.65 | $1.30 | http://www.digikey.com/product-detail/en/cinch-connectivity-solutions-johnson/108-0902-001/J151-ND/5929
Digikey | 1 | J153-ND | 2mm jack pin connectors (green) |  | $0.63 | $0.63 | http://www.digikey.com/product-detail/en/cinch-connectivity-solutions-johnson/108-0904-001/J153-ND/5931
 |  |  |  |  |  | $131.12
