imatlopez/EMG-Decoder/Forms/Final_List.xlsx

Name | C. Zhao | M. Lopez | A. Marellapudi | J. Scott | P. Wiboonsaksakul
Group | EMG Decoder
Date | 2016-12-08 | Orders must be submitted by email by 10 AM on Tuesday to matthewb@duke.edu to be processed on Tuesday
Vendor | Quantity | Part number | Part Description | Package | Price | Extended Price | URL (if not Mouser) | Notes
Preferred vendor is Mouser. Backups are Newark and Digikey. Please check these first for your component - arrangements can be made if your part can only come from another source (e.g. your main sensor) | Include units for quantity where necessary (5 resistors vs 5 packs of 25 resistors) |  |  | When ordering ICs, be particularly careful about package - size of chip and type of pins | Choose the right price for the quantity you are ordering - most companies offer bulk discounts | Extended price is the quantity * price |  | Include any other necessary notes for Matt to process your order
Electrode Store | 2 | DDY-30SAF | Reusable Bar Electrode | N/A | $25.00 | $50.00 | http://electrodestore.com/collections/emg-surface-electrodes/products/ddy-30saf-reusable-bar-electrode
Electrode Store | 1 | EVR-541(24)S | Grounding Electrode | N/A | $15.50 | $15.50 | http://electrodestore.com/collections/emg-surface-electrodes/products/evr-541-24-s-reusable-ground-electrodes
Mouser | 1 | TPS62160DGKR | 5V Regulator | WSON8 | $1.93 | $1.93 | http://www.mouser.com/ProductDetail/Texas-Instruments/TPS62163DGKR
Mouser | 1 | TPS62160DGKR | 5 V Regulator | VSSOP8 | $1.93 | $1.93 | http://www.mouser.com/ProductDetail/Texas-Instruments/TPS62160DGKR
Mouser | 2 | INA128UA | Instrumentation Amp | SOIC8 | $8.37 | $16.74 | http://www.mouser.com/ProductDetail/Texas-Instruments/INA128UA
Mouser | 2 | OPA2188AIDR | Operational Amp | SOIC8 | $3.33 | $6.66 | http://www.mouser.com/ProductDetail/Texas-Instruments/OPA2188AIDR
Mouser | 4 | OPA4188AIDR | Operational Amp | SOIC14 | $5.00 | $20.00 | http://www.mouser.com/ProductDetail/Texas-Instruments/OPA4188AIDR
Mouser | 2 | 08051A470JAT2A | 47 pF NP Capacitor | C0805 | $0.10 | $0.20 | http://www.mouser.com/ProductDetail/AVX/08051A470JAT2A
Mouser | 24 | 08055C104JAT2A | 0.1 µF NP Capacitor | C0805 | $0.10 | $2.40 | http://www.mouser.com/ProductDetail/AVX/08055C104JAT2A
Mouser | 2 | VJ0805Y105JXQTW1BC | 1 µF NP Capacitor | C0805 | $0.10 | $0.20 | http://www.mouser.com/ProductDetail/Vishay-Vitramon/VJ0805Y105JXQTW1BC/
Mouser | 3 | 12063D106KAT2A | 10 µF NP Capacitor | C1206 | $0.13 | $0.39 | http://www.mouser.com/ProductDetail/AVX/12063D106KAT2A
Mouser | 2 | GRM31CR61A226KE19L | 22 µF NP Capacitor | C1206 | $0.32 | $0.64 | http://www.mouser.com/ProductDetail/Murata-Electronics/GRM31CR61A226KE19L
Mouser | 1 | BAT46W-E3-08 | Schottsky Diode | SOD123 | $0.39 | $0.39 | http://www.mouser.com/ProductDetail/Vishay-Semiconductors/BAT46W-E3-08
Mouser | 6 | 1N4148W-E3-08 | 1N4148 Diode | SOD123 | $0.23 | $1.38 | http://www.mouser.com/ProductDetail/Vishay-Semiconductors/1N4148W-E3-08
Mouser | 4 | CRCW120651R0FKEA | 51 Ω Resistor | R1206 | $0.10 | $0.40 | http://www.mouser.com/ProductDetail/Vishay-Dale/CRCW120651R0FKEA
Mouser | 6 | CRCW12061K00FKEA | 1 kΩ Resistor | R1206 | $0.10 | $0.60 | http://www.mouser.com/ProductDetail/Vishay-Dale/CRCW12061K00FKEA
Mouser | 4 | CRCW12062K80FKEA | 2.8 kΩ Resistor | R1206 | $0.10 | $0.40 | http://www.mouser.com/ProductDetail/Vishay-Dale/CRCW12062K80FKEA
Mouser | 4 | CRCW12067K50FKEA | 7.5 kΩ Resistor | R1206 | $0.10 | $0.40 | http://www.mouser.com/ProductDetail/Vishay-Dale/CRCW12067K50FKEA
Mouser | 9 | CRCW120610K0FKEA | 10 kΩ Resistor | R1206 | $0.10 | $0.90 | http://www.mouser.com/ProductDetail/Vishay-Dale/CRCW120610K0FKEA
Mouser | 4 | CRCW120675K0FKEA | 75 kΩ Resistor | R1206 | $0.10 | $0.40 | http://www.mouser.com/ProductDetail/Vishay-Dale/CRCW120675K0FKEA
Mouser | 2 | CRCW1206100KFKEA | 100 kΩ Resistor | R1206 | $0.10 | $0.20 | http://www.mouser.com/ProductDetail/Vishay-Dale/CRCW1206100KFKEA
Mouser | 1 | CRCW1206130KFKEA | 130 kΩ Resistor | R1206 | $0.10 | $0.10 | http://www.mouser.com/ProductDetail/Vishay-Dale/CRCW1206130KFKEA
Mouser | 4 | CRCW1206390KFKEA | 390 kΩ Resistor | R1206 | $0.11 | $0.44 | http://www.mouser.com/ProductDetail/Vishay-Dale/CRCW1206390KFKEA
Mouser | 3 | CRCW1206680KFKEA | 680 kΩ Resistor | R1206 | $0.10 | $0.30 | http://www.mouser.com/ProductDetail/Vishay-Dale/CRCW1206680KFKEA
Mouser | 8 | CRCW12061M00FKEA | 1 MΩ Resistor | R1206 | $0.10 | $0.80 | http://www.mouser.com/ProductDetail/Vishay-Dale/CRCW12061M00FKEA
Mouser | 2 | MLF1608A2R2J | 2.2 µH Inductor | L0603 | $0.24 | $0.48 | http://www.mouser.com/ProductDetail/TDK/MLF1608A2R2J
Mouser | 1 | PIC18F46K22-I/PT | Microcontroller | TQFP44 | $3.59 | $3.59 | http://www.mouser.com/ProductDetail/Microchip/PIC18F46K22-I-PT
Mouser | 1 | 22-05-3021 | 2pos WTB | Header | $0.30 | $0.30 | http://www.mouser.com/ProductDetail/Molex/22-05-3021
Mouser | 1 | 22-05-3051 | 5pos WTB | Header | $0.54 | $0.54 | http://www.mouser.com/ProductDetail/Molex/22-05-3051
Mouser | 1 | 22-01-2025 | 2pos WTB | Connector | $0.25 | $0.25 | http://www.mouser.com/ProductDetail/Molex/22-01-2025
Mouser | 1 | 22-01-2055 | 5pos WTB | Connector | $0.39 | $0.39 | http://www.mouser.com/ProductDetail/Molex/22-01-2055
Mouser | 7 | 50212-8100 | Wire Crimp | N/A | $0.25 | $1.75 | http://www.mouser.com/ProductDetail/Molex/50212-8100
Mouser | 1 | 22-28-8060 | 6pos Breakaway | Header | $0.46 | $0.46 | http://www.mouser.com/ProductDetail/Molex/22-28-8060
Digikey | 1 | PPTC031LGBN-RC | 3 position receptacle |  | $0.65 | $0.65 | http://www.digikey.com/product-search/en?keywords=PPTC031LGBN-RC
Digikey | 2 | PPTC021LGBN-RC | 2 position receptacle |  | $0.57 | $1.14 | http://www.digikey.com/product-search/en?keywords=PPTC021LGBN-RC
Digikey | 1 | 235 | 9V snap battery connector |  | $0.65 | $0.65 | http://www.digikey.com/product-detail/en/keystone-electronics/235/36-235-ND/303806
Digikey | 2 | J152-ND | 2mm jack pin connectors (Bl) |  | $0.65 | $1.30 | http://www.digikey.com/product-detail/en/cinch-connectivity-solutions-johnson/108-0903-001/J152-ND/5930
Digikey | 2 | J151-ND | 2mm jack pin connectors ( R) |  | $0.65 | $1.30 | http://www.digikey.com/product-detail/en/cinch-connectivity-solutions-johnson/108-0902-001/J151-ND/5929
Digikey | 1 | J153-ND | 2mm jack pin connectors (G) |  | $0.63 | $0.63 | http://www.digikey.com/product-detail/en/cinch-connectivity-solutions-johnson/108-0904-001/J153-ND/5931
 |  |  |  |  |  | $136.73
