imatlopez/EMG-Decoder/Electronics/Project Outputs for Electronics/ExportSTEP/Main.step

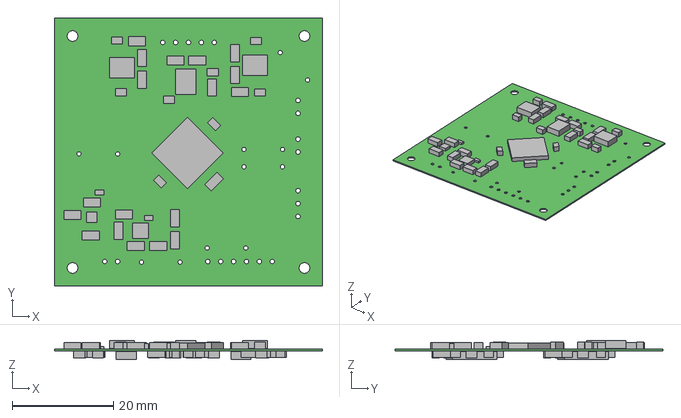
[picture p42: CAD file, 2016-11-14]
Electronics/Project Outputs for Electronics/ExportSTEP/Main.step
52.8 x 52.8 x 3.84 mm
Board
Extruded x 95
