imatlopez/EMG-Decoder/Mechanical/Solidworks Practice/Centrifuge Parts/Assem1.SLDASM

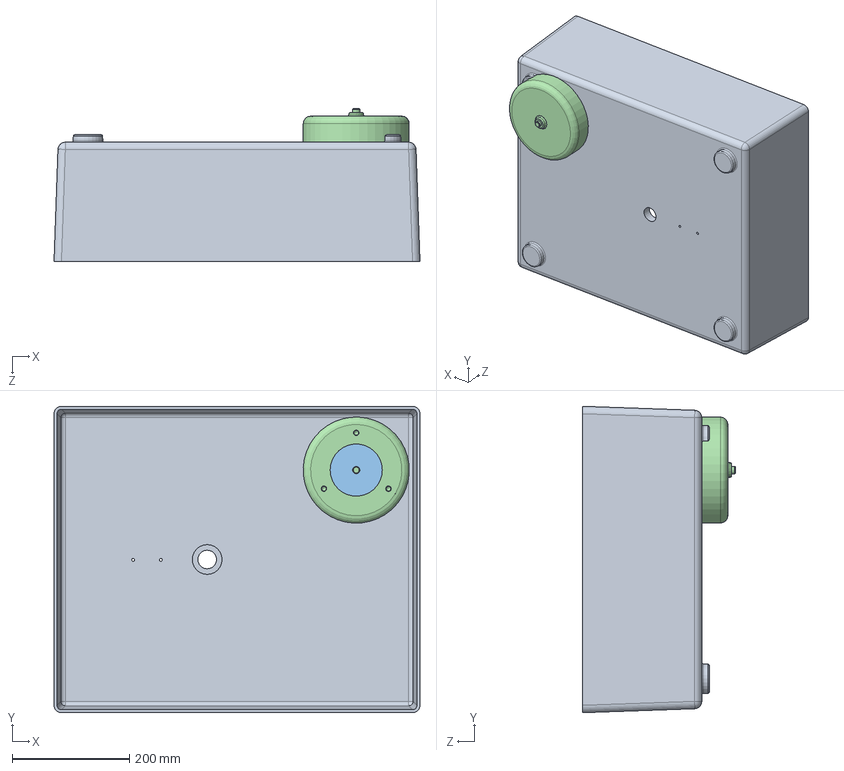
[picture p43: CAD file, 2016-11-07]
Mechanical/Solidworks Practice/Centrifuge Parts/Assem1.SLDASM
623.8 x 522.2 x 260.4 mm
Housing
StandOff x 3
Pulley
Motor
