imatlopez/EMG-Decoder/Mechanical/SolidWorks Project/PCB/Main.step

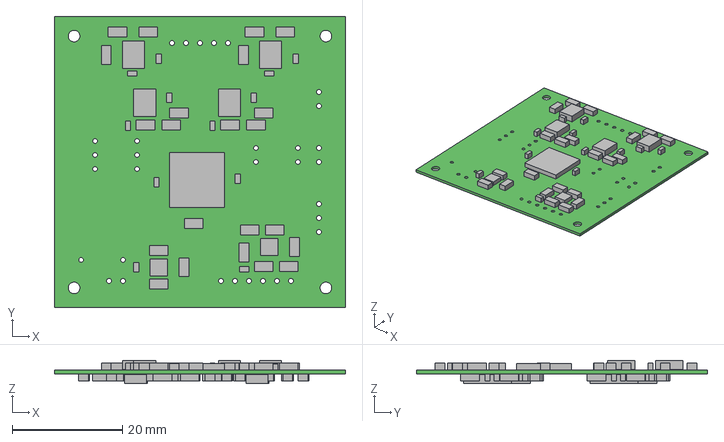
[picture p44: CAD file, 2016-11-09]
Mechanical/SolidWorks Project/PCB/Main.step
52.8 x 52.8 x 4.18 mm
Board
Extruded x 101
