imatlopez/EMG-Decoder/Mechanical/SolidWorks Project/NOV28ASSEM.SLDASM

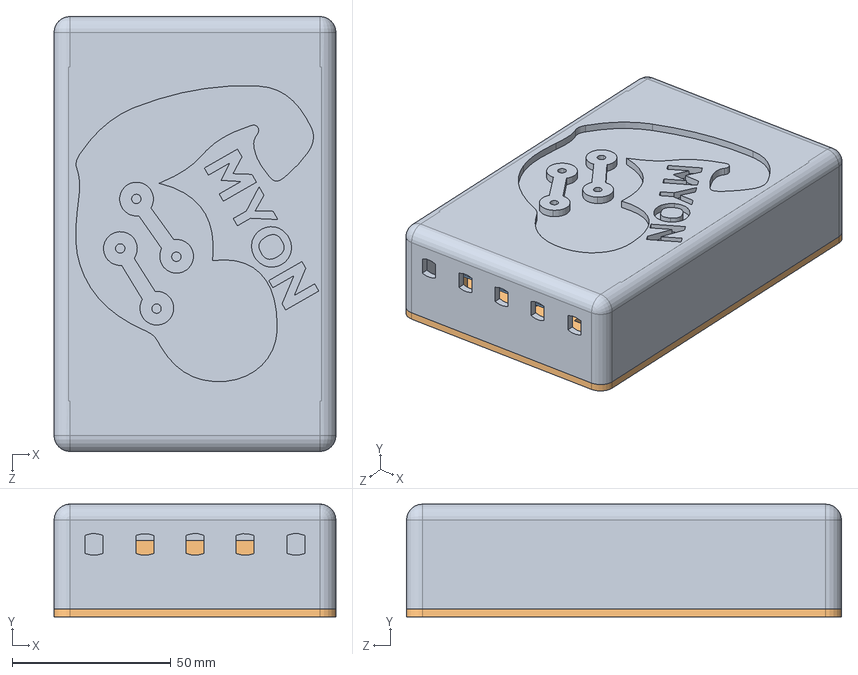
[picture p45: CAD file, 2016-12-09]
Mechanical/SolidWorks Project/NOV28ASSEM.SLDASM
88.9 x 35.6 x 137.2 mm
Draft5Cover
Draft5BottomPlate
PCB2
