imatlopez/EMG-Decoder/Mechanical/SolidWorks Project/NOV7ASSEMB.SLDASM

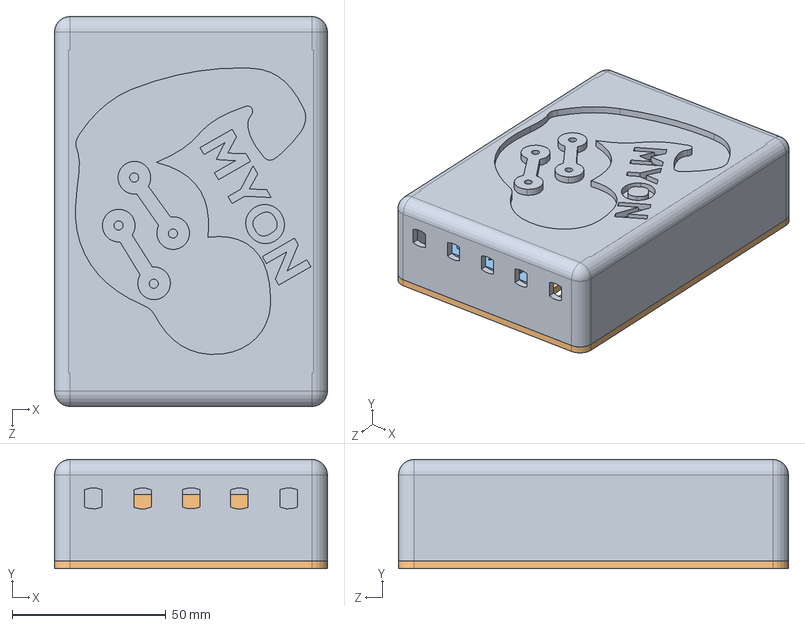
[picture p46: CAD file, 2016-12-09]
Mechanical/SolidWorks Project/NOV7ASSEMB.SLDASM
88.9 x 35.6 x 127.0 mm
Draft5Cover
Draft5BottomPlate
PCB2
