imatlopez/EMG-Decoder/Mechanical/SolidWorks Project/OCT31ASSEMB.SLDASM

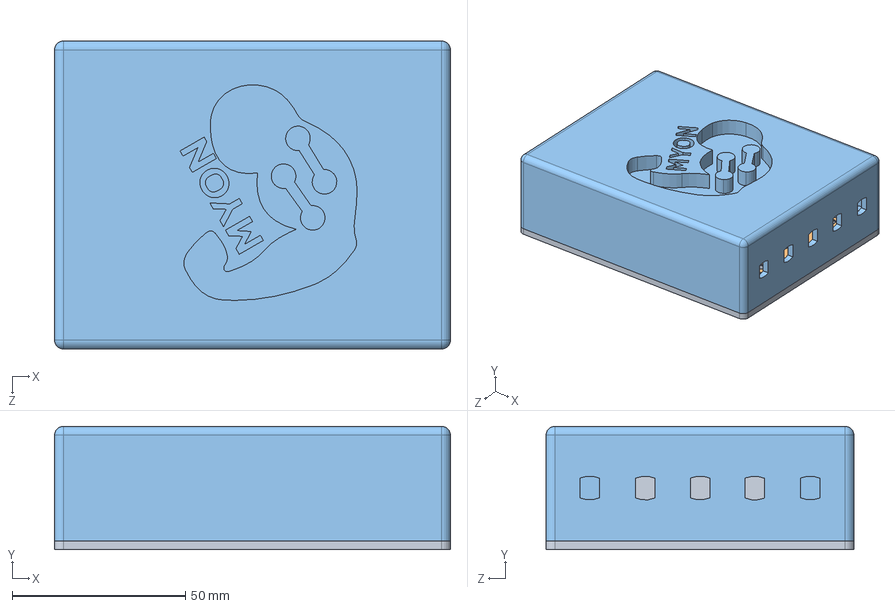
[picture p47: CAD file, 2016-11-07]
Mechanical/SolidWorks Project/OCT31ASSEMB.SLDASM
114.3 x 35.6 x 88.9 mm
Draft4bottomplate
PCB
Draft5Cover
