imatlopez/EMG-Decoder/Mechanical/SolidWorks Project/Main.step

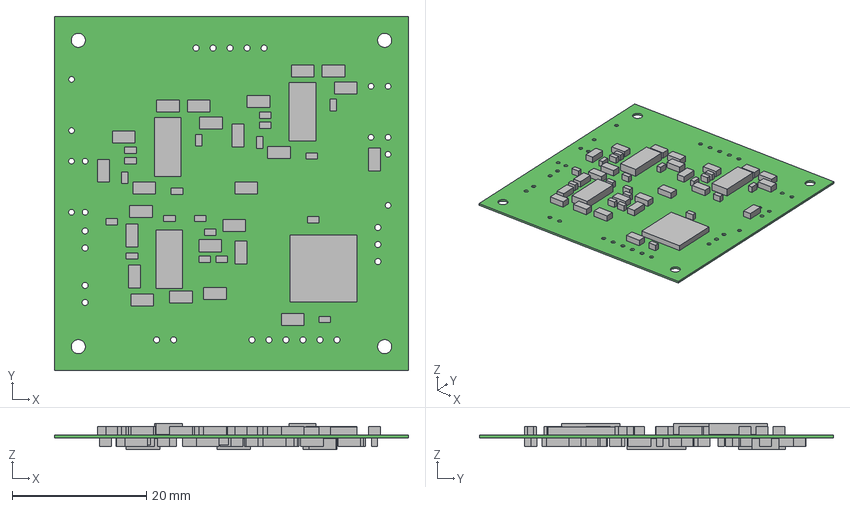
[picture p48: CAD file, 2016-11-07]
Mechanical/SolidWorks Project/Main.step
52.8 x 52.8 x 3.90 mm
Board
Extruded x 96
