imatlopez/EMG-Decoder/Mechanical/SolidWorks Project/Myon Box.SLDASM

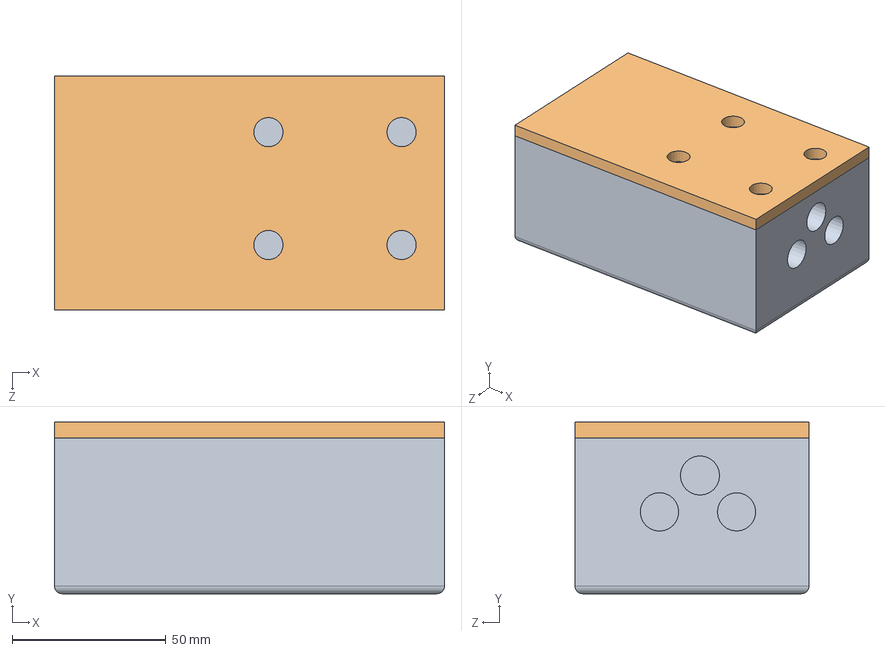
[picture p49: CAD file, 2016-11-07]
Mechanical/SolidWorks Project/Myon Box.SLDASM
127.0 x 55.9 x 76.2 mm
RoughtDraftMyonBox
Cover for Myonbox
