imatlopez/EMG-Decoder/Mechanical/SolidWorks Project/Oct26Assemb.SLDASM

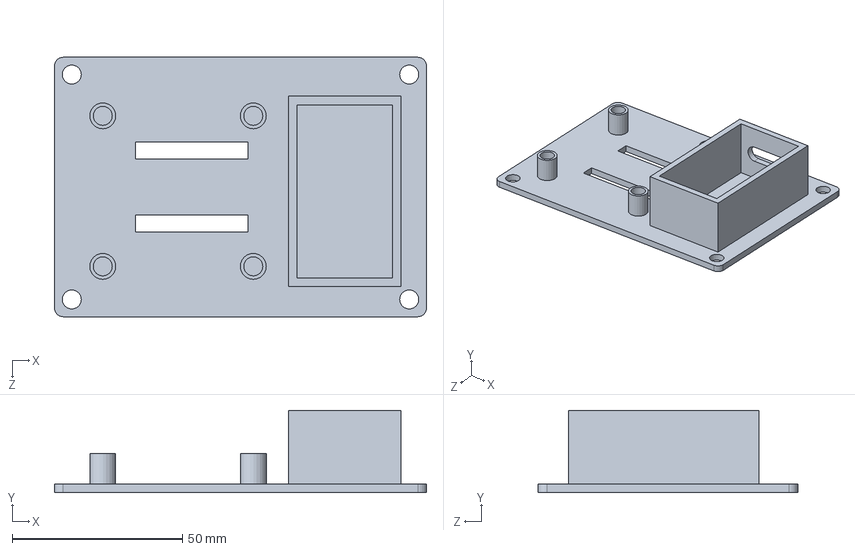
[picture p50: CAD file, 2016-11-07]
Mechanical/SolidWorks Project/Oct26Assemb.SLDASM
109.2 x 24.1 x 76.2 mm
