imatlopez/EMG-Decoder/Mechanical/SolidWorks Project/Oct24Assemb.SLDASM

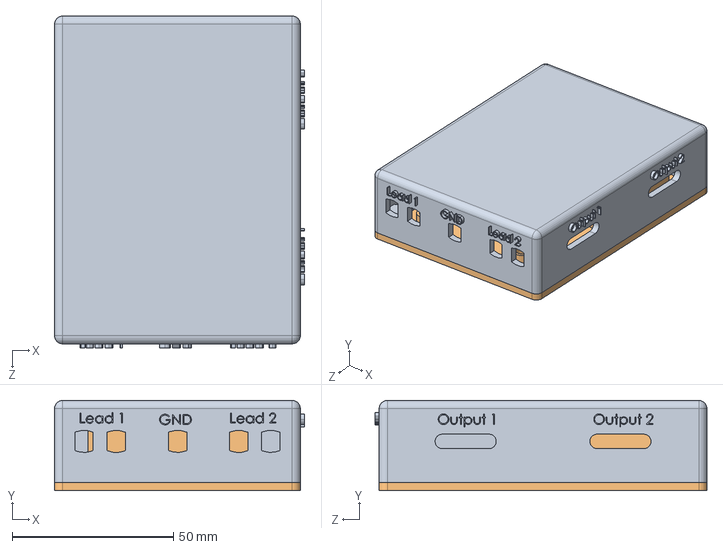
[picture p51: CAD file, 2016-11-07]
Mechanical/SolidWorks Project/Oct24Assemb.SLDASM
77.5 x 27.9 x 102.9 mm
Draft3Cover
Draft4bottomplate
