imatlopez/EMG-Decoder/Mechanical/Solidworks Practice/PracticeStandOff.SLDPRT

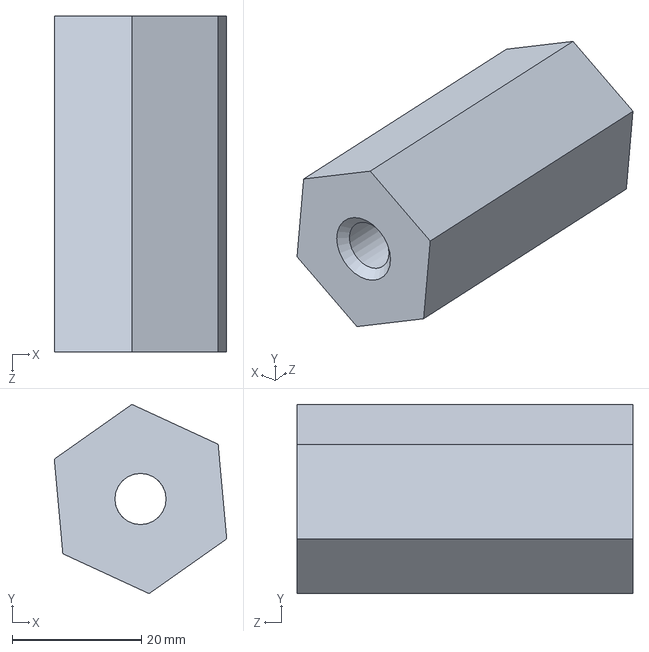
[picture p52: CAD file, 2016-11-07]
Mechanical/Solidworks Practice/PracticeStandOff.SLDPRT
26.7 x 29.3 x 52.1 mm
