imatlopez/EMG-Decoder/Mechanical/SolidWorks Project/Draft6BottomPlate.SLDPRT

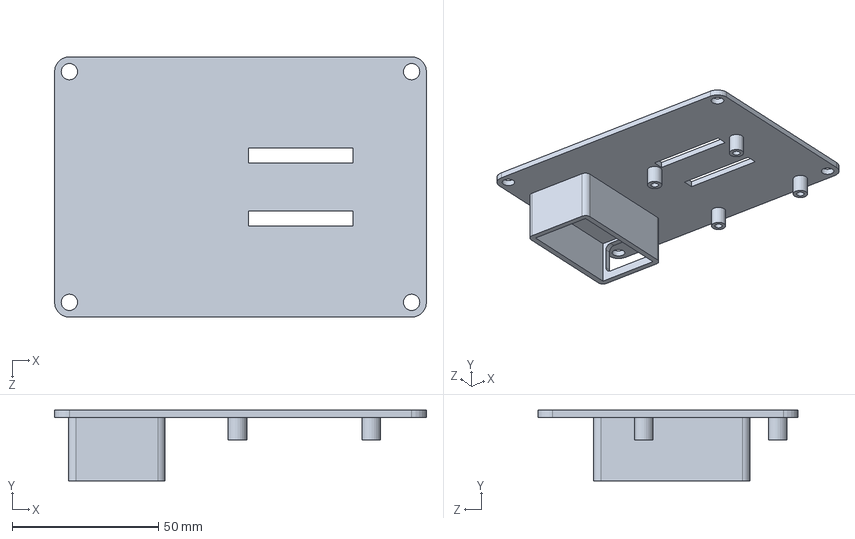
[picture p53: CAD file, 2016-12-09]
Mechanical/SolidWorks Project/Draft6BottomPlate.SLDPRT
127.0 x 24.1 x 88.9 mm
