imatlopez/EMG-Decoder/3D/SolidWorks/Myon Deco.SLDPRT

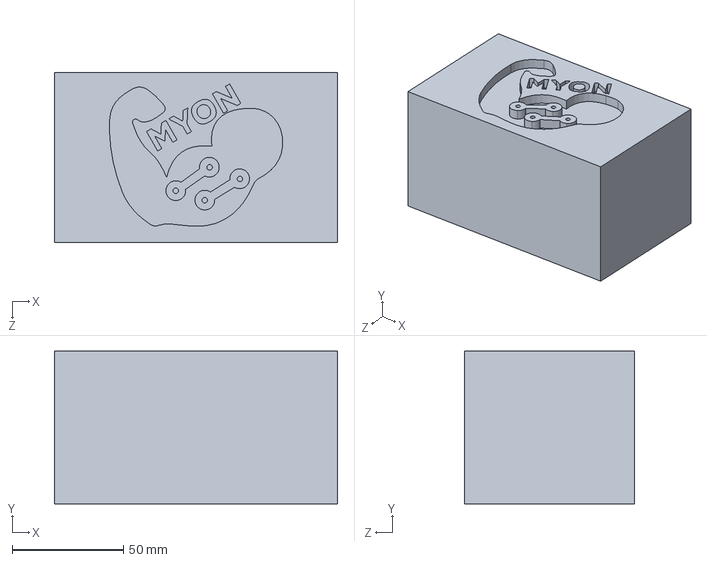
[picture p54: CAD file, 2016-09-20]
3D/SolidWorks/Myon Deco.SLDPRT
127.0 x 68.6 x 76.2 mm
