imatlopez/EMG-Decoder/Electronics/Project Outputs for Electronics/ExportSTEP/PCB2.SLDPRT

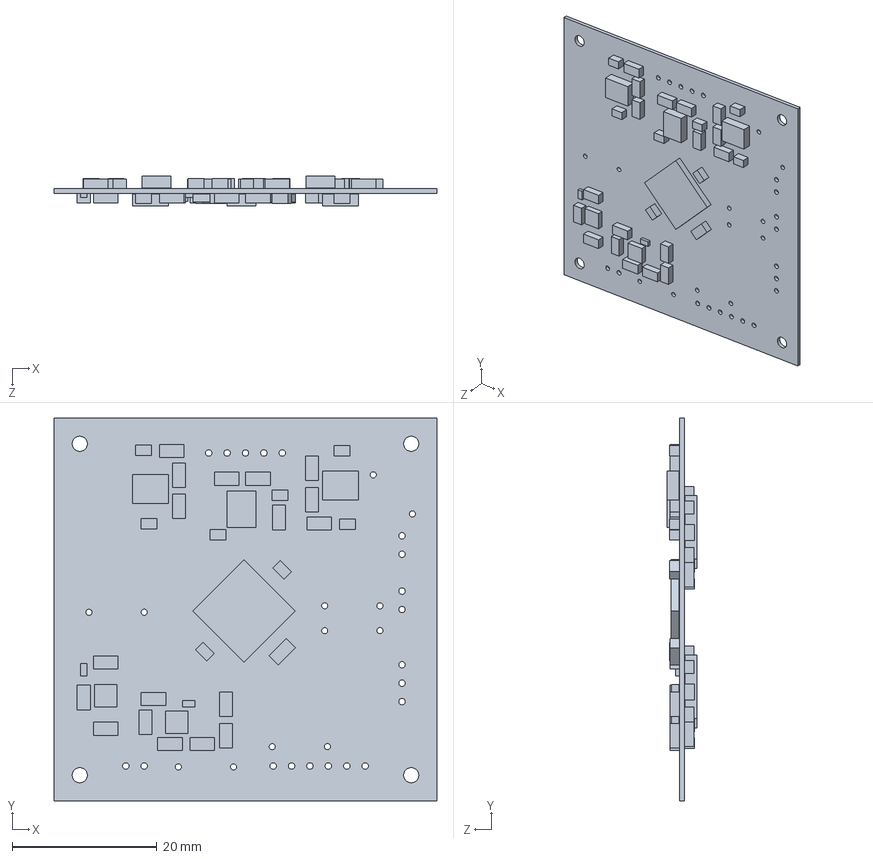
[picture p55: CAD file, 2016-11-09]
Electronics/Project Outputs for Electronics/ExportSTEP/PCB2.SLDPRT
52.8 x 52.8 x 4.18 mm
