imatlopez/EMG-Decoder/Mechanical/Solidworks Practice/Centrifuge Parts/Sensor.SLDPRT

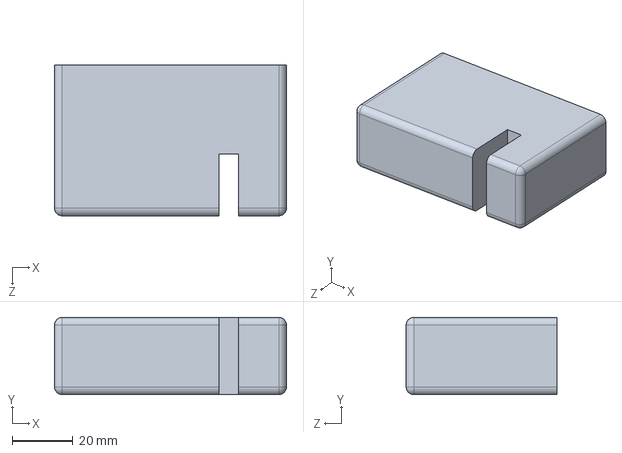
[picture p56: CAD file, 2016-11-07]
Mechanical/Solidworks Practice/Centrifuge Parts/Sensor.SLDPRT
76.2 x 25.4 x 49.5 mm
