imatlopez/EMG-Decoder/Mechanical/Solidworks Practice/PracticeShaft.SLDPRT

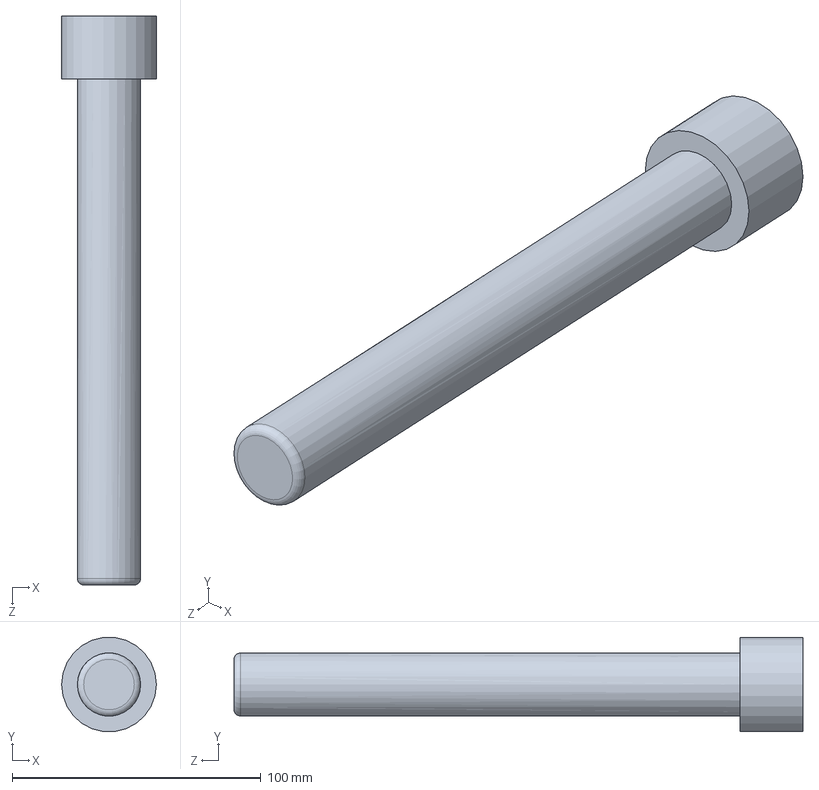
[picture p57: CAD file, 2016-11-07]
Mechanical/Solidworks Practice/PracticeShaft.SLDPRT
38.1 x 37.8 x 228.6 mm
