imatlopez/EMG-Decoder/Mechanical/SolidWorks Project/Draft5Cover.SLDPRT

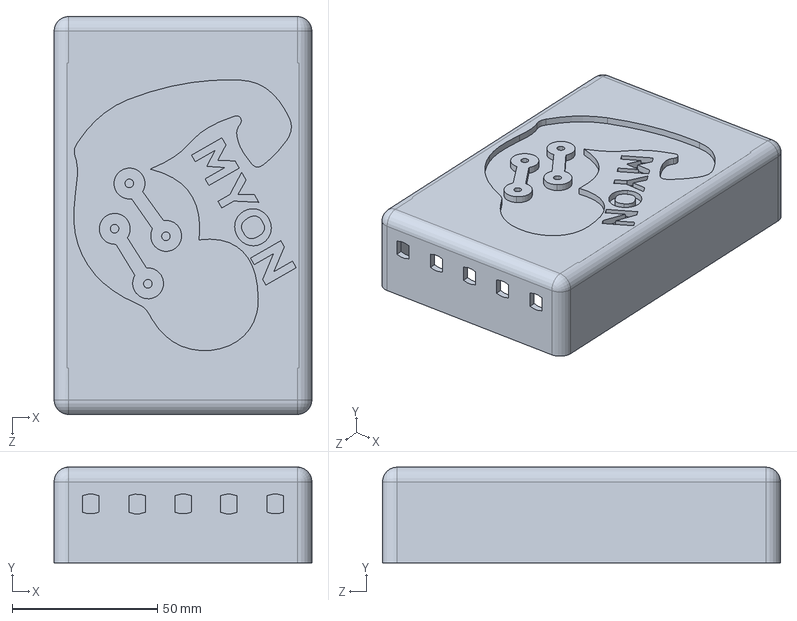
[picture p58: CAD file, 2016-12-09]
Mechanical/SolidWorks Project/Draft5Cover.SLDPRT
88.9 x 33.0 x 137.2 mm
