imatlopez/EMG-Decoder/Mechanical/SolidWorks Project/PCB/PCB.SLDPRT

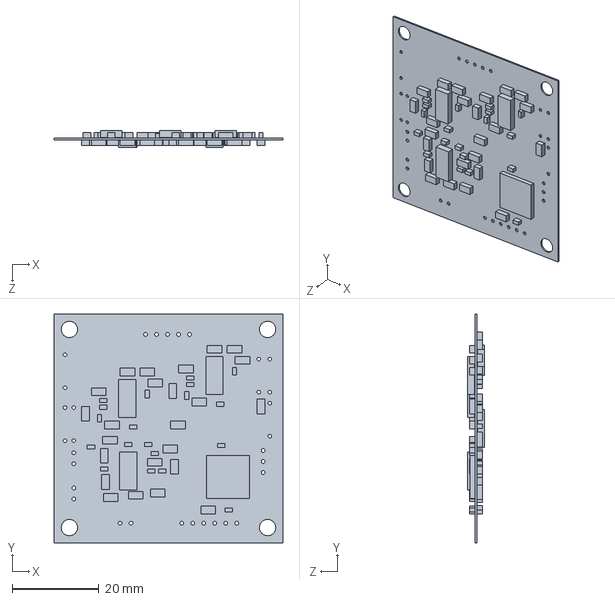
[picture p59: CAD file, 2016-11-07]
Mechanical/SolidWorks Project/PCB/PCB.SLDPRT
52.8 x 52.8 x 3.90 mm
