imatlopez/EMG-Decoder/Mechanical/Solidworks Practice/Centrifuge Parts/StandOff.SLDPRT

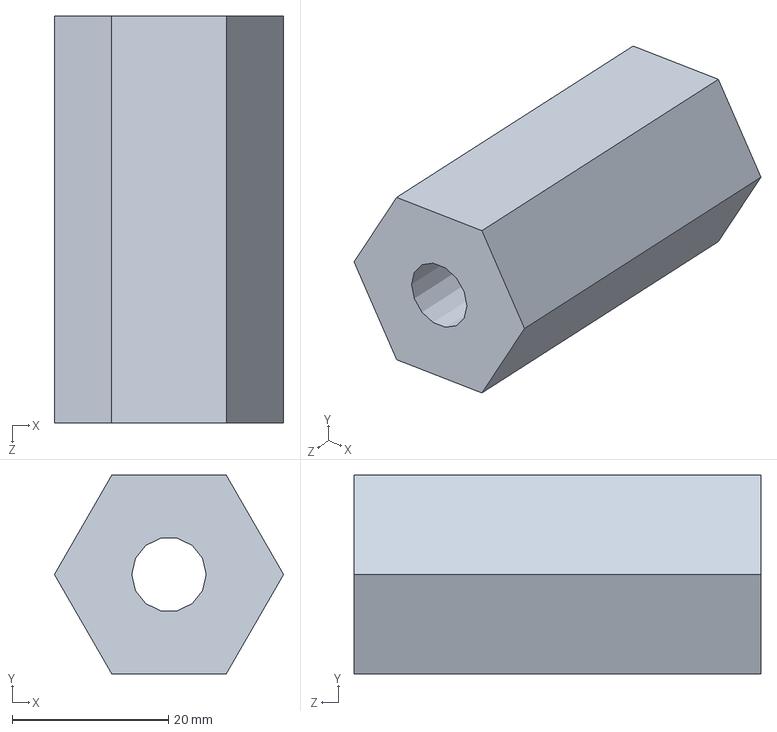
[picture p60: CAD file, 2016-11-07]
Mechanical/Solidworks Practice/Centrifuge Parts/StandOff.SLDPRT
29.3 x 25.4 x 52.1 mm
