imatlopez/EMG-Decoder/Mechanical/Solidworks Practice/PracticePully.SLDPRT

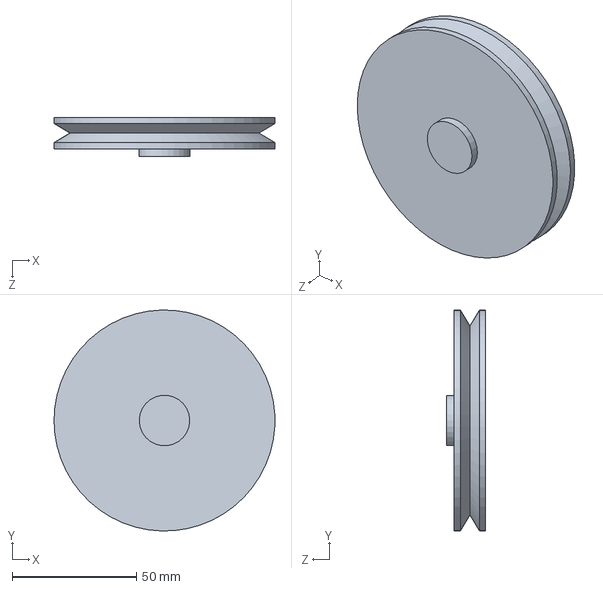
[picture p61: CAD file, 2016-11-07]
Mechanical/Solidworks Practice/PracticePully.SLDPRT
88.9 x 88.9 x 15.9 mm
