imatlopez/EMG-Decoder/Mechanical/Solidworks Practice/Centrifuge Parts/Rotor.SLDPRT

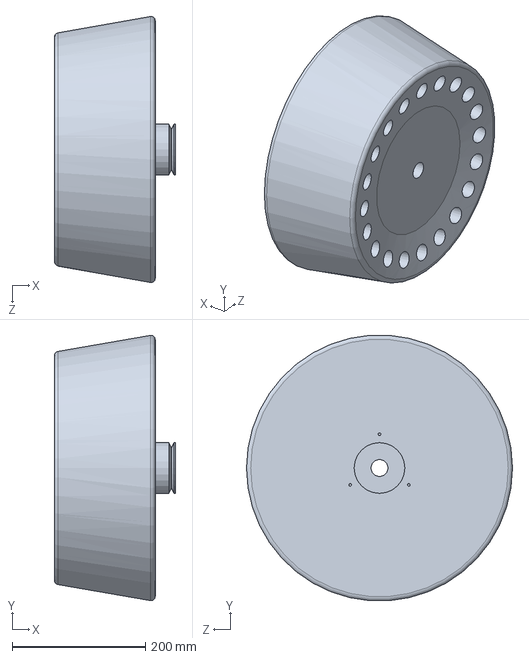
[picture p62: CAD file, 2016-11-07]
Mechanical/Solidworks Practice/Centrifuge Parts/Rotor.SLDPRT
181.9 x 398.3 x 399.5 mm
