imatlopez/EMG-Decoder/Mechanical/SolidWorks Project/Draft5BottomPlate.SLDPRT

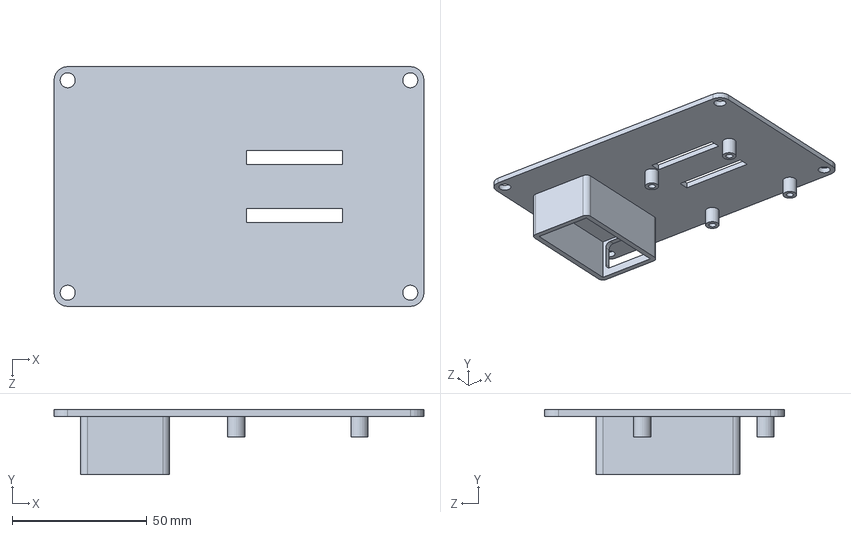
[picture p63: CAD file, 2016-12-09]
Mechanical/SolidWorks Project/Draft5BottomPlate.SLDPRT
137.2 x 24.1 x 88.9 mm
