imatlopez/EMG-Decoder/Mechanical/Solidworks Practice/Centrifuge Parts/Motor.sldprt

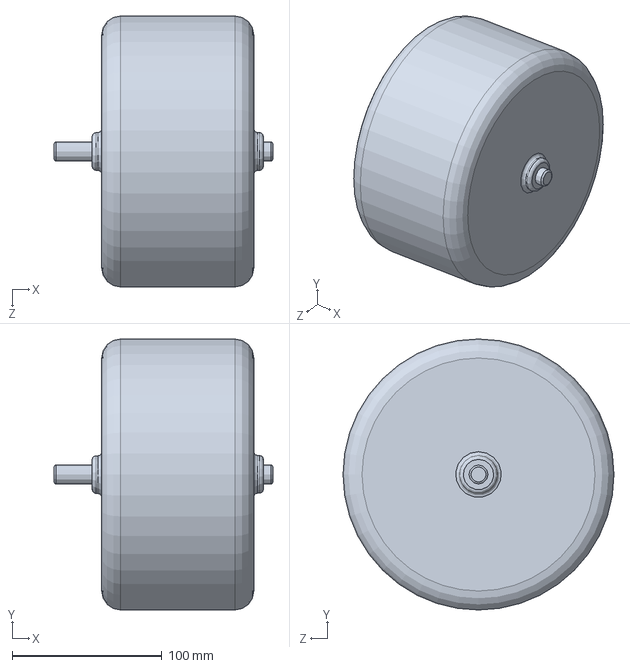
[picture p64: CAD file, 2016-11-07]
Mechanical/Solidworks Practice/Centrifuge Parts/Motor.sldprt
146.1 x 180.9 x 180.9 mm
