imatlopez/EMG-Decoder/Mechanical/Solidworks Practice/Centrifuge Parts/Tonewheel.SLDPRT

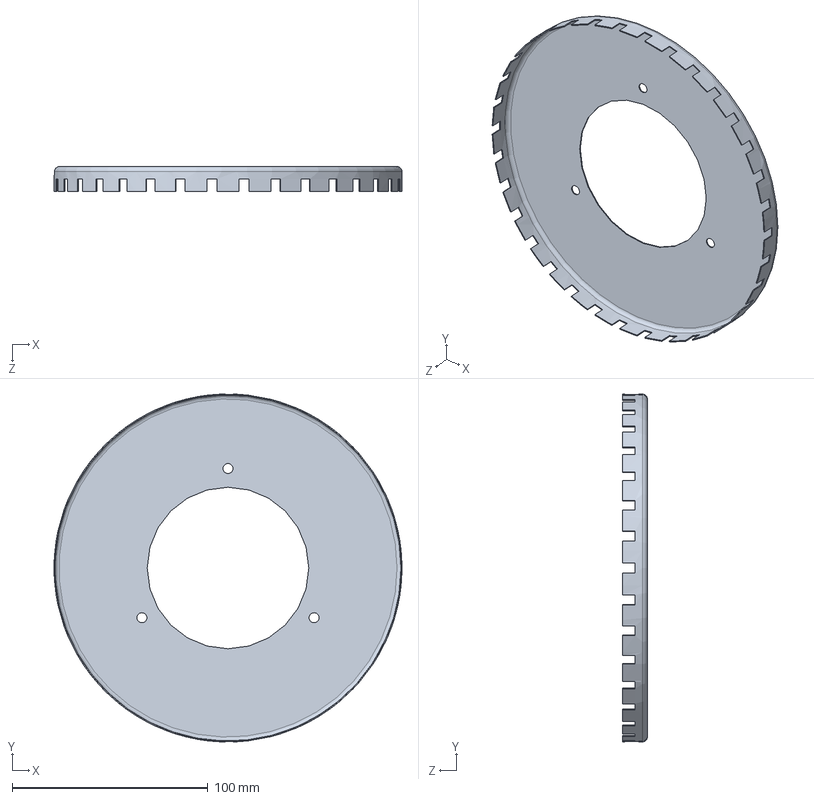
[picture p65: CAD file, 2016-11-07]
Mechanical/Solidworks Practice/Centrifuge Parts/Tonewheel.SLDPRT
177.8 x 177.7 x 12.7 mm
