imatlopez/EMG-Decoder/Mechanical/SolidWorks Project/Draft6Cover.SLDPRT

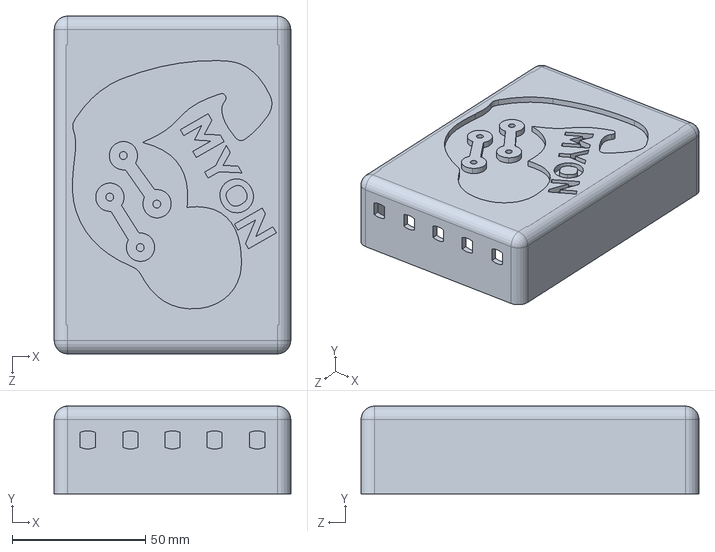
[picture p66: CAD file, 2016-12-09]
Mechanical/SolidWorks Project/Draft6Cover.SLDPRT
88.9 x 33.0 x 127.0 mm
