imatlopez/EMG-Decoder/Mechanical/Solidworks Practice/Centrifuge Parts/Pulley.sldprt

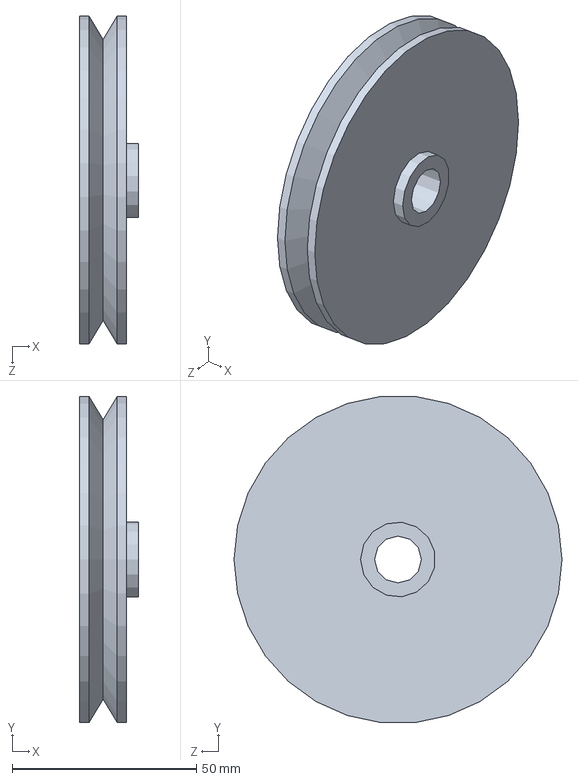
[picture p67: CAD file, 2016-11-07]
Mechanical/Solidworks Practice/Centrifuge Parts/Pulley.sldprt
15.9 x 88.4 x 88.9 mm
