imatlopez/EMG-Decoder/Mechanical/Solidworks Practice/Centrifuge Parts/Housing.SLDPRT

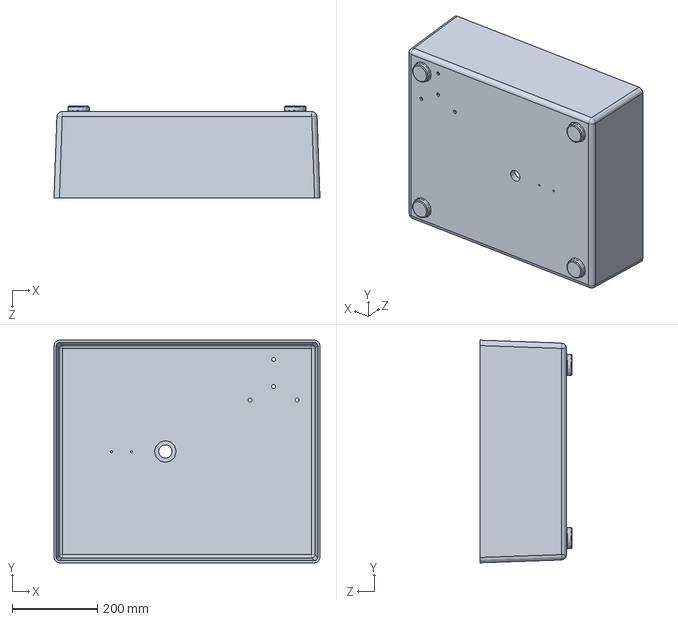
[picture p68: CAD file, 2016-11-07]
Mechanical/Solidworks Practice/Centrifuge Parts/Housing.SLDPRT
623.8 x 522.2 x 215.9 mm
