imatlopez/EMG-Decoder/Mechanical/SolidWorks Project/drat4cover.SLDPRT

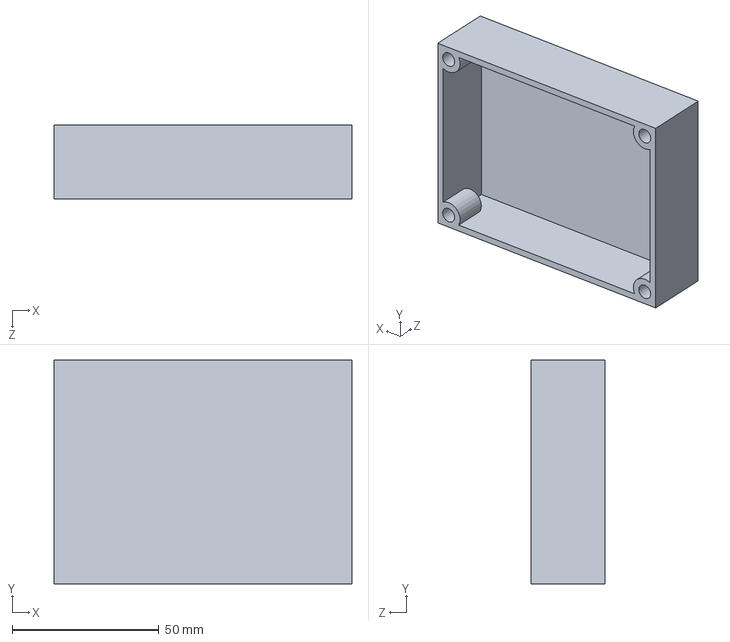
[picture p69: CAD file, 2016-11-07]
Mechanical/SolidWorks Project/drat4cover.SLDPRT
101.6 x 76.2 x 25.4 mm
