imatlopez/EMG-Decoder/Mechanical/Solidworks Practice/Centrifuge Parts/Shaft.SLDPRT

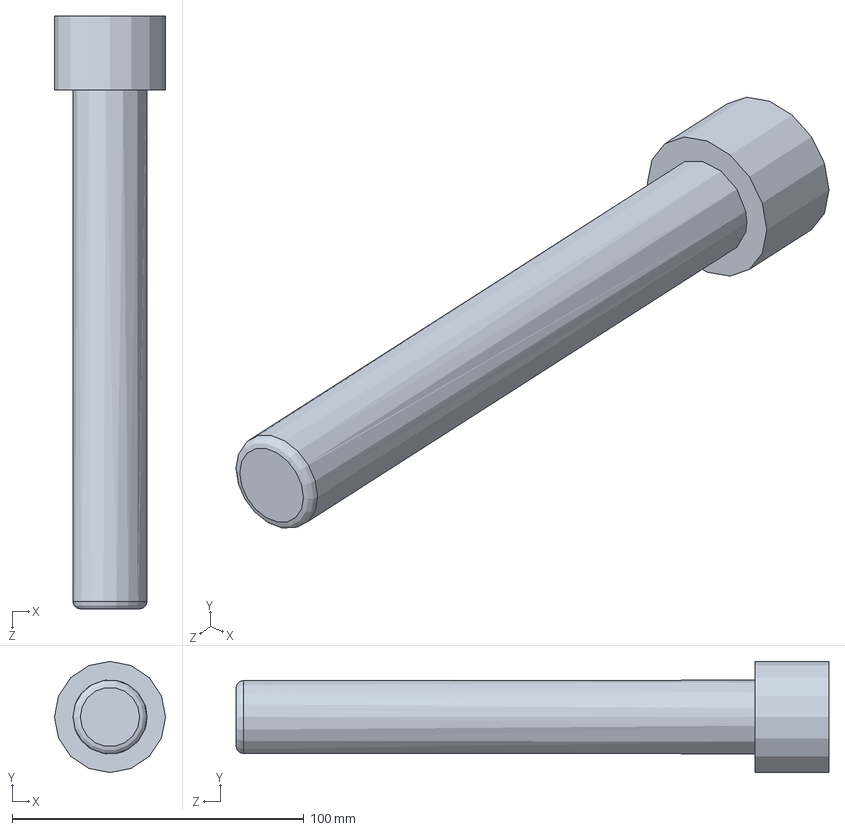
[picture p70: CAD file, 2016-11-07]
Mechanical/Solidworks Practice/Centrifuge Parts/Shaft.SLDPRT
38.1 x 38.1 x 203.2 mm
