imatlopez/EMG-Decoder/Mechanical/SolidWorks Project/New bottomplate.SLDPRT

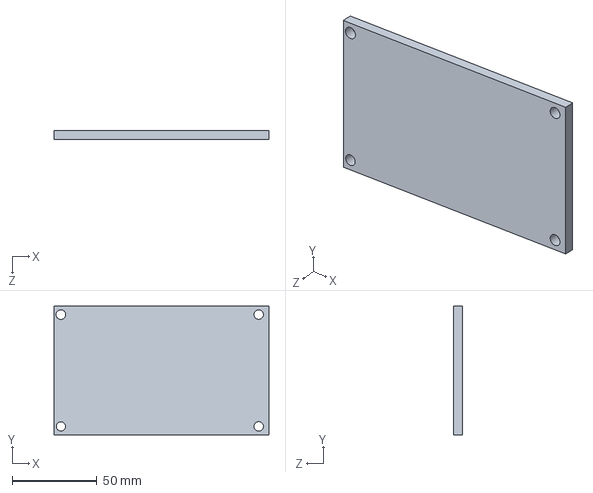
[picture p71: CAD file, 2016-11-07]
Mechanical/SolidWorks Project/New bottomplate.SLDPRT
127.0 x 76.2 x 5.08 mm
