imatlopez/EMG-Decoder/Mechanical/SolidWorks Project/PCB.SLDPRT

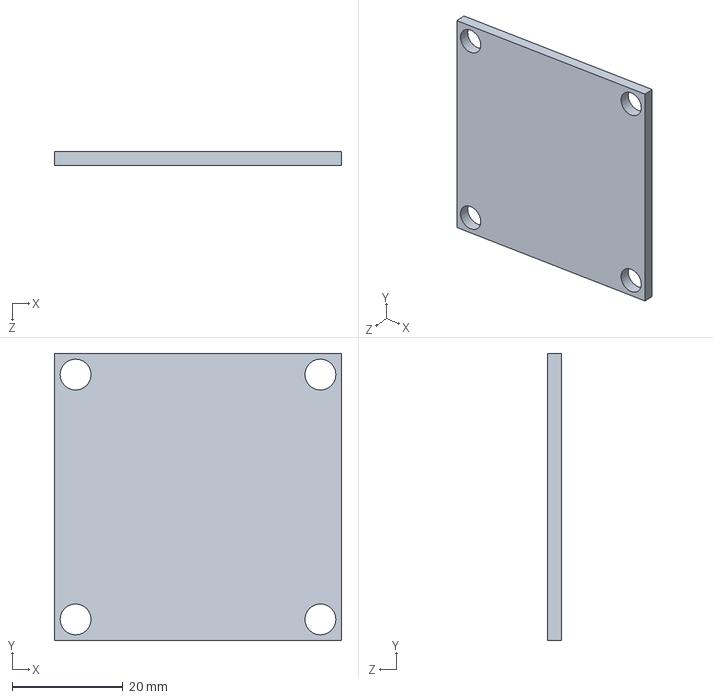
[picture p72: CAD file, 2016-11-07]
Mechanical/SolidWorks Project/PCB.SLDPRT
51.8 x 51.8 x 2.54 mm
