imatlopez/EMG-Decoder/Mechanical/SolidWorks Project/RoughtDraftMyonBox.SLDPRT

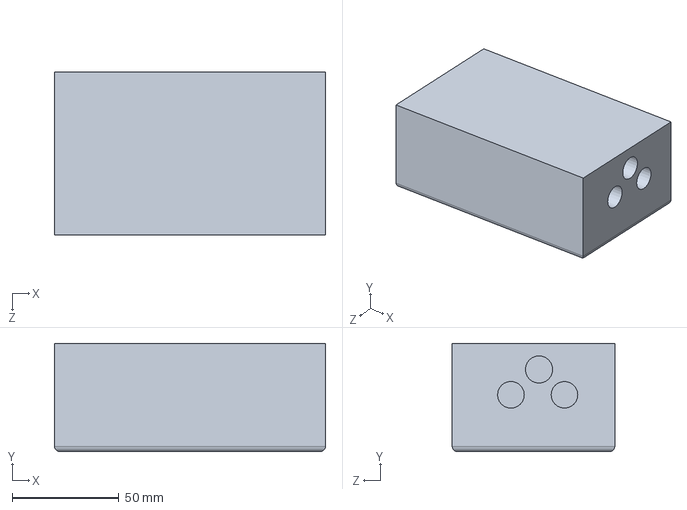
[picture p73: CAD file, 2016-11-07]
Mechanical/SolidWorks Project/RoughtDraftMyonBox.SLDPRT
127.0 x 50.8 x 76.2 mm
