imatlopez/EMG-Decoder/Mechanical/SolidWorks Project/Draft3Cover.SLDPRT

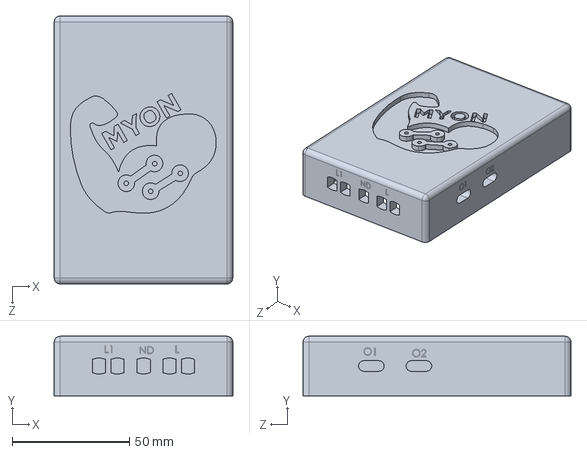
[picture p74: CAD file, 2016-11-07]
Mechanical/SolidWorks Project/Draft3Cover.SLDPRT
76.2 x 25.4 x 114.3 mm
