imatlopez/EMG-Decoder/Mechanical/SolidWorks Project/Draft2Bottomplate.SLDPRT

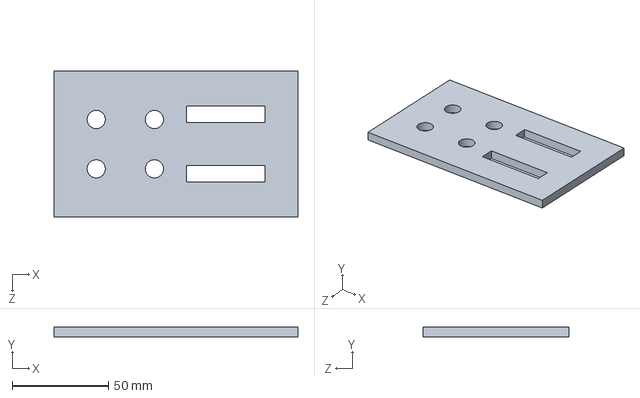
[picture p75: CAD file, 2016-11-07]
Mechanical/SolidWorks Project/Draft2Bottomplate.SLDPRT
127.0 x 5.08 x 76.2 mm
