imatlopez/EMG-Decoder/Mechanical/SolidWorks Project/Draft4bottomplate.SLDPRT

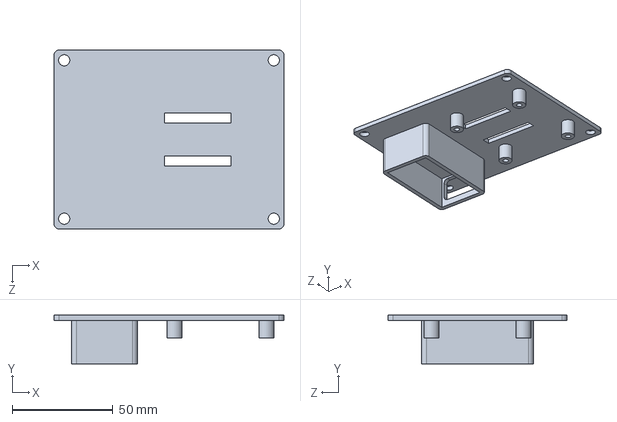
[picture p76: CAD file, 2016-11-07]
Mechanical/SolidWorks Project/Draft4bottomplate.SLDPRT
114.3 x 24.1 x 88.9 mm
