imatlopez/EMG-Decoder/Mechanical/SolidWorks Project/Draft2Cover.SLDPRT

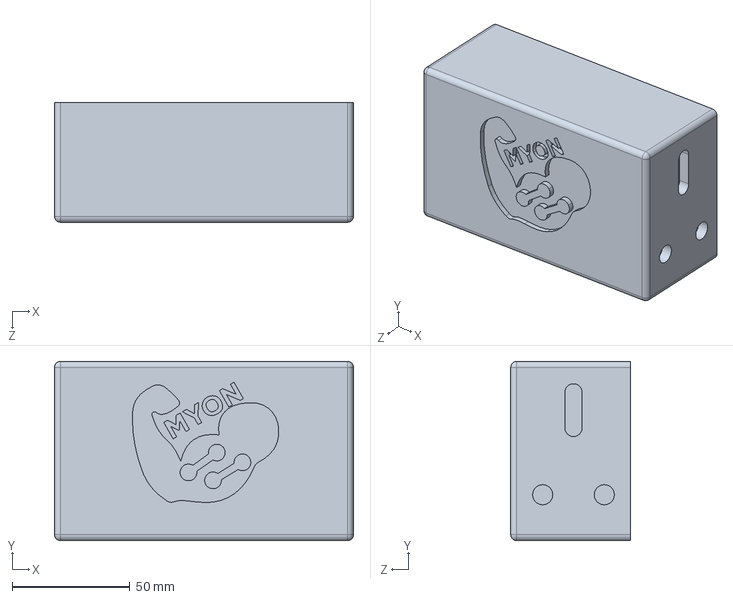
[picture p77: CAD file, 2016-11-07]
Mechanical/SolidWorks Project/Draft2Cover.SLDPRT
127.0 x 76.2 x 50.8 mm
