imatlopez/EMG-Decoder/Mechanical/SolidWorks Project/Draft3bottomplate.SLDPRT

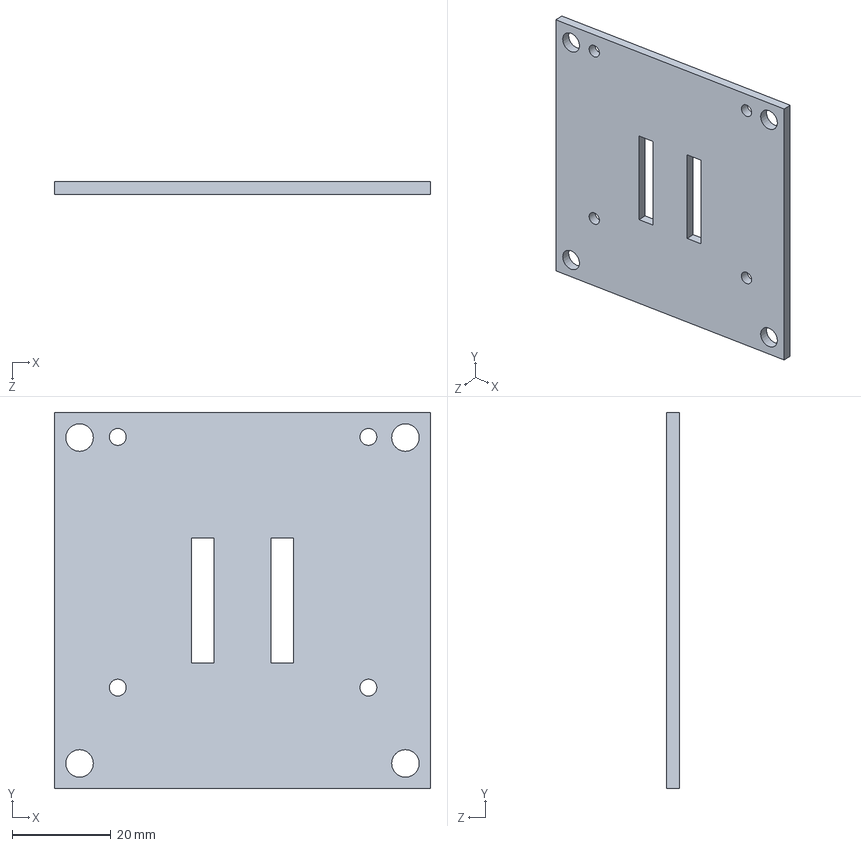
[picture p78: CAD file, 2016-11-07]
Mechanical/SolidWorks Project/Draft3bottomplate.SLDPRT
76.2 x 76.2 x 2.54 mm
