imatlopez/EMG-Decoder/(list of files, cad)

Other CAD files:
Electronics/Project Outputs for Electronics/AutoCAD PCB/Main.sldasm
3D/SolidWorks/Logo.dwg
Electronics/Project Outputs for Electronics/AutoCAD PCB/AXIAL_0_3_6.sldprt
Electronics/Project Outputs for Electronics/AutoCAD PCB/1608_0603__13.sldprt
Electronics/Project Outputs for Electronics/AutoCAD PCB/AXIAL_0_3_4.sldprt
Electronics/Project Outputs for Electronics/AutoCAD PCB/1608_0603__8.sldprt
Electronics/Project Outputs for Electronics/AutoCAD PCB/1608_0603__11.sldprt
Electronics/Project Outputs for Electronics/AutoCAD PCB/AXIAL_0_3_5.sldprt
Electronics/Project Outputs for Electronics/AutoCAD PCB/AXIAL_0_3_3.sldprt
Electronics/Project Outputs for Electronics/AutoCAD PCB/1608_0603__10.sldprt
Electronics/Project Outputs for Electronics/AutoCAD PCB/1608_0603__12.sldprt
Electronics/Project Outputs for Electronics/AutoCAD PCB/AXIAL_0_3_2.sldprt
Electronics/Project Outputs for Electronics/AutoCAD PCB/AXIAL_0_3_1.sldprt
Mechanical/SolidWorks Project/Part1.sldprt
Electronics/Project Outputs for Electronics/AutoCAD PCB/1608_0603__7.sldprt
Electronics/Project Outputs for Electronics/AutoCAD PCB/1608_0603__9.sldprt
Mechanical/SolidWorks Project/Cover for Myonbox.SLDPRT
3D/Cap18.ipt
3D/DIP8.ipt
Electronics/Project Outputs for Electronics/AutoCAD PCB/Main.DWG
Electronics/Project Outputs for Electronics/AutoCAD PCB/Main.sldprt
Mechanical/Final Mechanical Drawings and Photos/FinalBottomplateDrawing.SLDDRW
Mechanical/Final Mechanical Drawings and Photos/FinalCoverDrawing.SLDDRW
Mechanical/SolidWorks Project/Draft2Bottomplate.STL
Mechanical/SolidWorks Project/Draft2Cover.STL
Mechanical/SolidWorks Project/Draft3Cover.STL
Mechanical/SolidWorks Project/Draft3bottomplate.STL
Mechanical/SolidWorks Project/Draft4bottomplate.STL
Mechanical/SolidWorks Project/Draft5BottomPlate.SLDDRW
Mechanical/SolidWorks Project/Draft5BottomPlate.STL
Mechanical/SolidWorks Project/Draft5Cover.SLDDRW
Mechanical/SolidWorks Project/Draft5Cover.STL
Mechanical/SolidWorks Project/Draft6BottomPlate.STL
Mechanical/SolidWorks Project/MechanicalDrawOct24.SLDDRW
Mechanical/SolidWorks Project/Myon Box.SLDDRW
