imatlopez/EMG-Decoder/Forms/Testing.xlsx

Sheet: Reliability
 |  | Bicep |  |  |  |  |  |  |  | Forearm |  |  |  |  |  |  |  | Thumb
 |  | 10 | 180 | 330 | 510 | 680 | 820 | 1000 |  | 10 | 180 | 330 | 510 | 680 | 820 | 1000 |  | 10 | 180 | 330 | 510 | 680 | 820 | 1000
Matias | C | 1 | 1 | 1 | 1 | 1 | 1 | 1 | C | 1 | 1 | 1 | 1 | 1 | 1 | 1 | C | 1 | 1 | 1 | 1 | 1 | 1 | 1
 | W | 0 | 0 | 0 | 0 | 0 | 0 | 1 | W | 0 | 1 | 0 | 0 | 0 | 0 | 0 | W | 0 | 0 | 0 | 0 | 0 | 0 | 1
 | 0 | 0 | 0 | 0 | 0 | 0 | 0 | 0 | 0 | 0 | 0 | 0 | 0 | 0 | 0 | 0 | 0 | 0 | 0 | 0 | 0 | 0 | 0 | 0
 | C | 1 | 1 | 1 | 1 | 1 | 1 | 1 | C | 1 | 1 | 1 | 1 | 1 | 1 | 1 | C | 1 | 1 | 1 | 1 | 1 | 1 | 1
 | W | 0 | 0 | 0 | 0 | 0 | 1 | 0 | W | 0 | 0 | 0 | 0 | 0 | 0 | 0 | W | 0 | 0 | 1 | 0 | 0 | 1 | 1
 | 0 | 0 | 0 | 0 | 0 | 0 | 0 | 0 | 0 | 0 | 0 | 0 | 0 | 0 | 0 | 0 | 0 | 0 | 0 | 0 | 0 | 0 | 0 | 0
 | C | 1 | 1 | 1 | 1 | 1 | 1 | 1 | C | 1 | 1 | 0 | 1 | 1 | 1 | 1 | C | 1 | 1 | 1 | 1 | 1 | 0 | 1
 | W | 0 | 0 | 0 | 0 | 0 | 0 | 0 | W | 0 | 0 | 0 | 1 | 0 | 0 | 0 | W | 0 | 0 | 0 | 0 | 0 | 1 | 0
 | 0 | 0 | 0 | 0 | 0 | 0 | 0 | 0 | 0 | 0 | 0 | 0 | 0 | 0 | 0 | 0 | 0 | 0 | 0 | 0 | 0 | 0 | 0 | 0
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
