imatlopez/EMG-Decoder/Electronics/Project Outputs for Electronics/Electronics.PDF

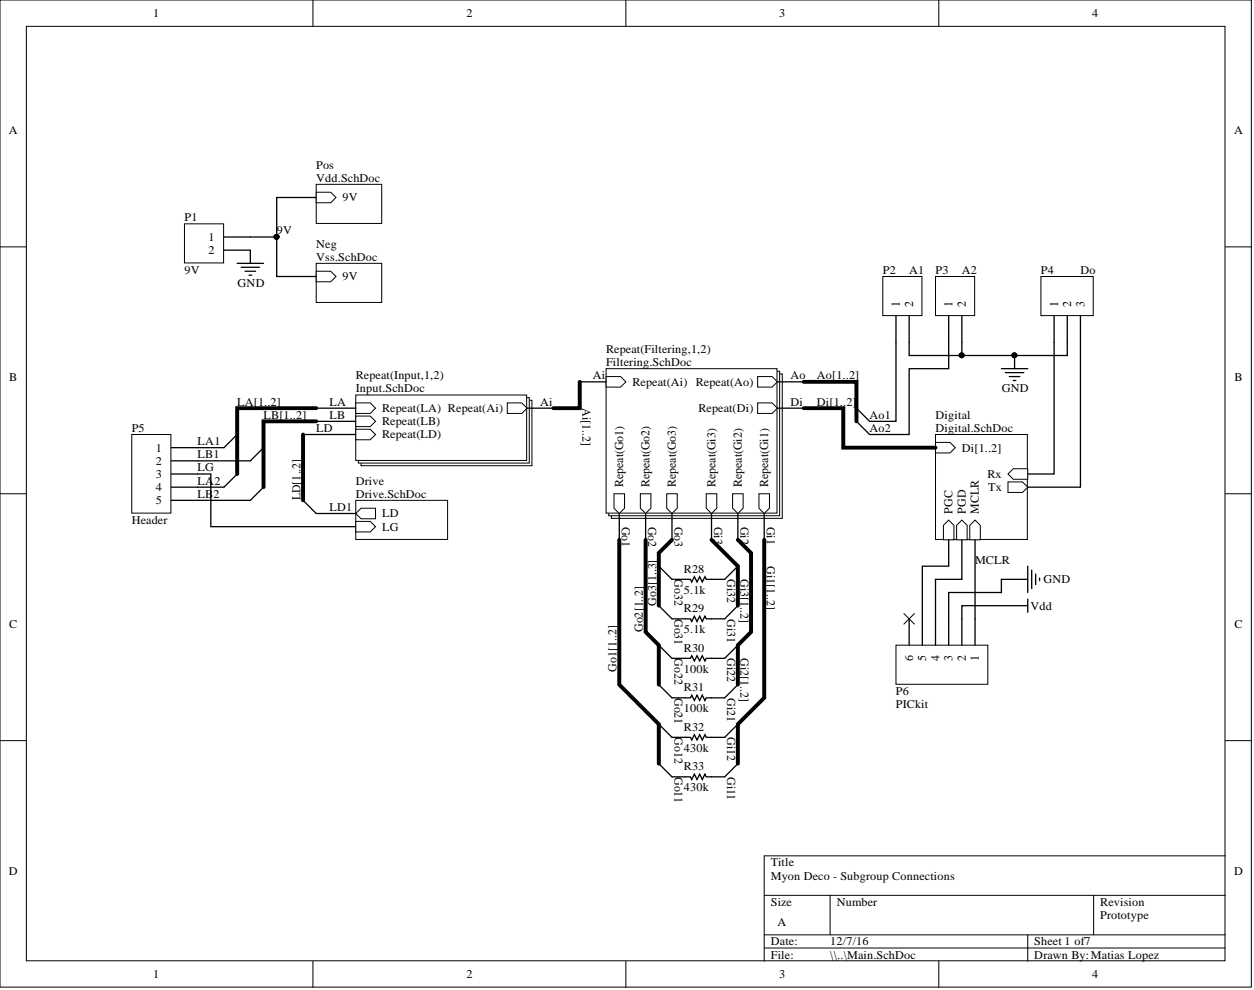
[picture p79: page 1]

Repeat(In
i Repeat(LA) Repeat(Ai)

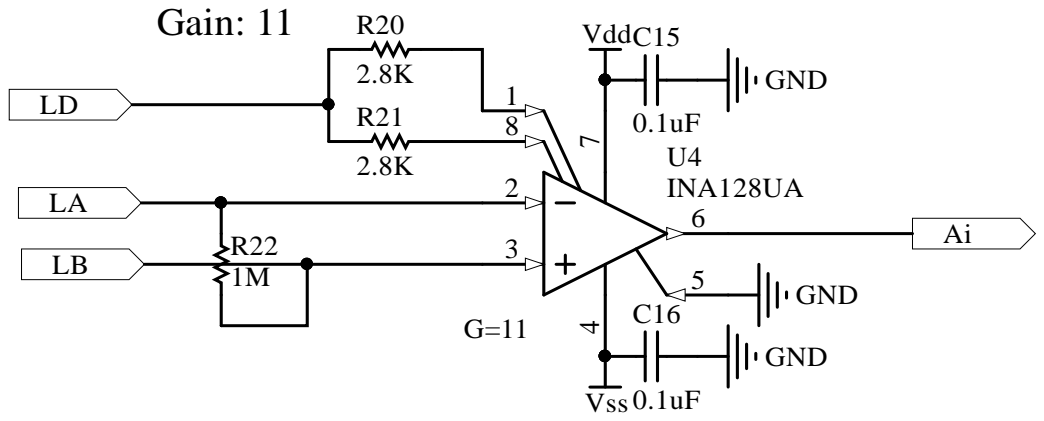
[picture p80: page 2]

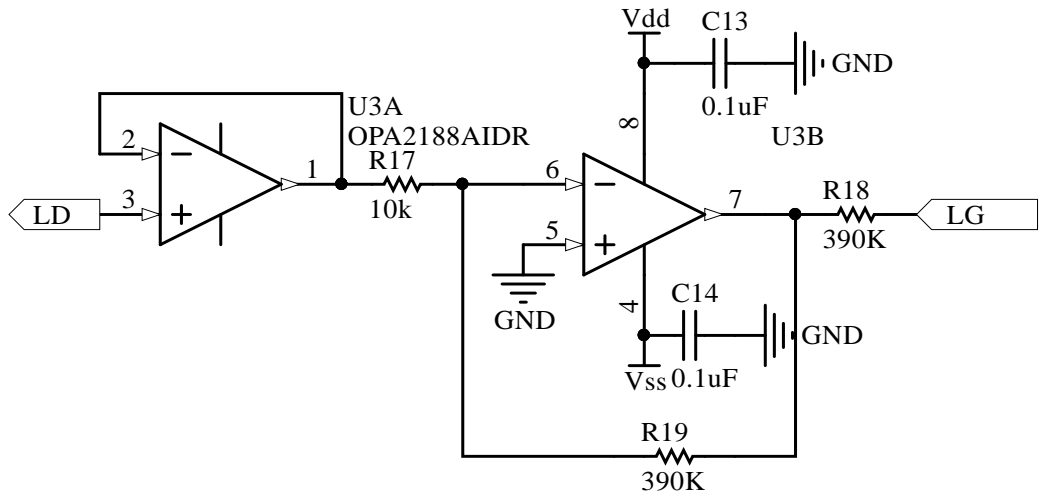
[picture p81: page 3]

Title
Myon Deco - Leg Drive

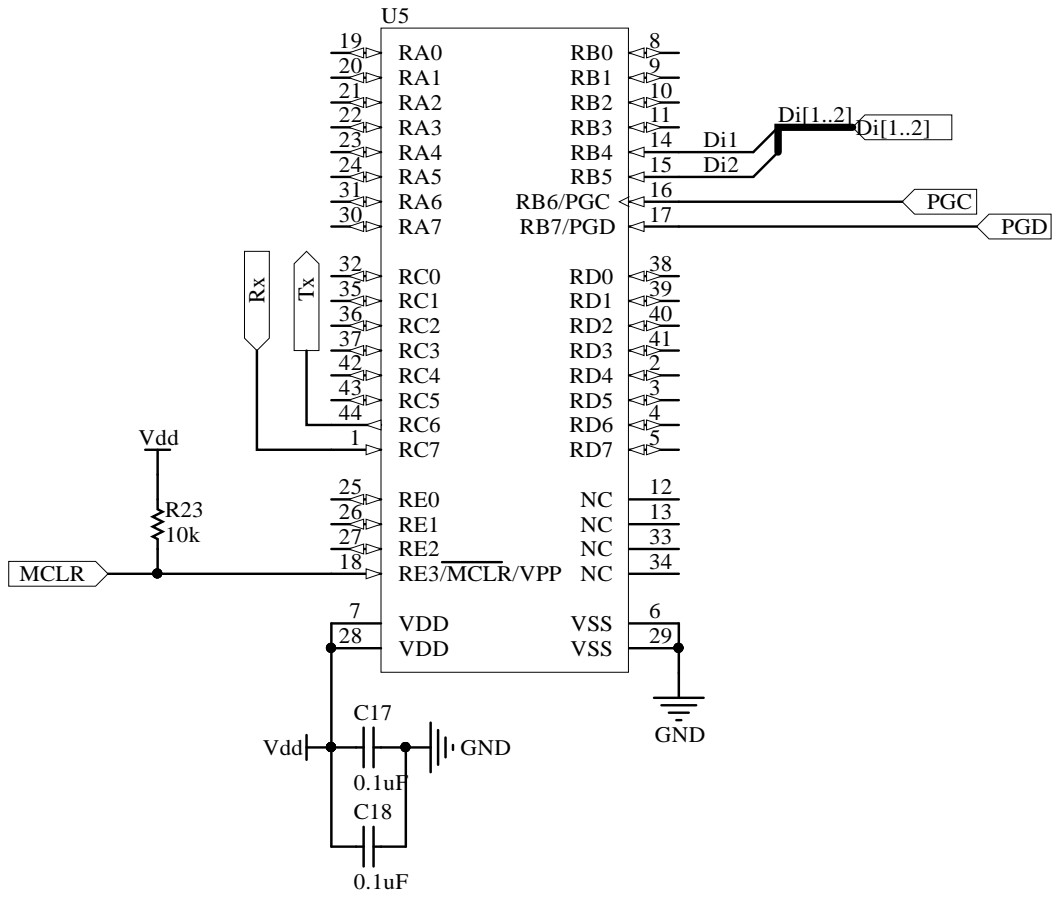
[picture p82: page 4]

Title
Myon Deco - Digital Stage

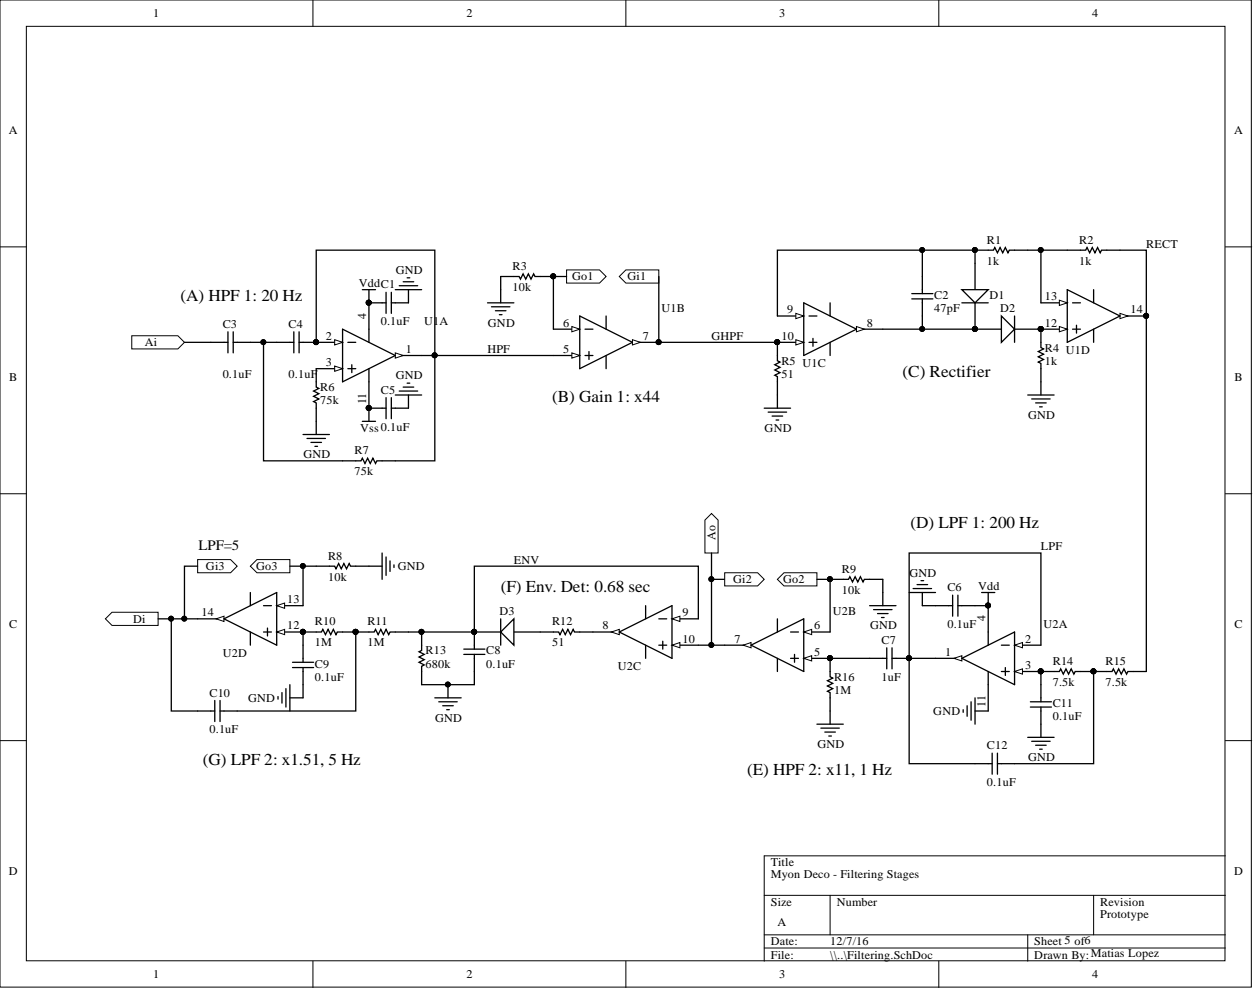
[picture p83: page 5]

(E) HPF 2: x11, 1 Hz (G) LPF 2: x1.51, 5 Hz

Title
Myon Deco - Filtering Stages

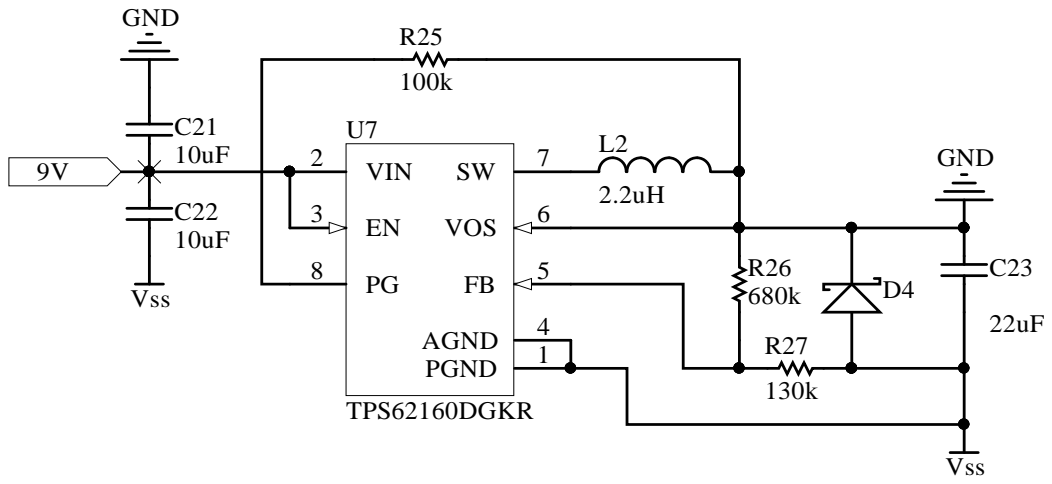
[picture p84: page 6]

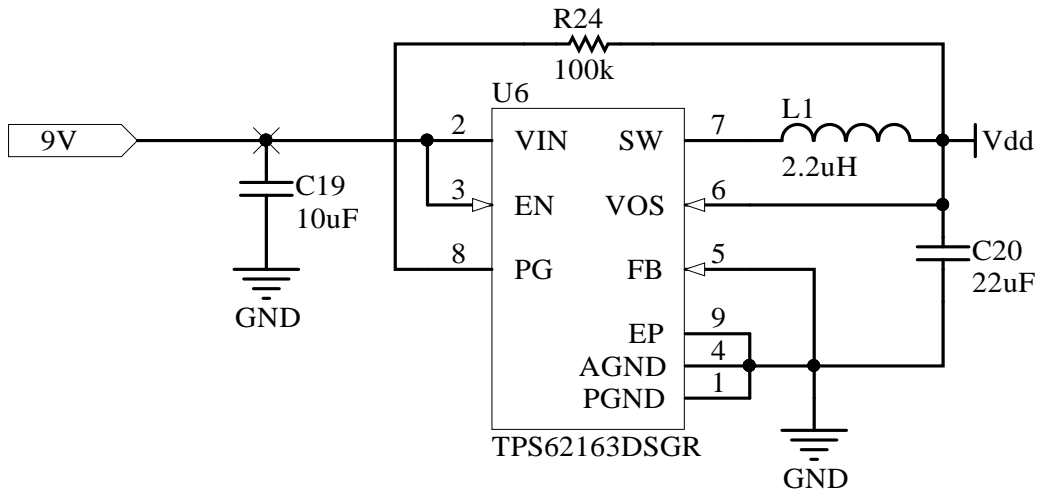
[picture p85: page 7]

Title
Myon Deco - Positive Supply
