imatlopez/EMG-Decoder/Electronics/Electronics.pdf

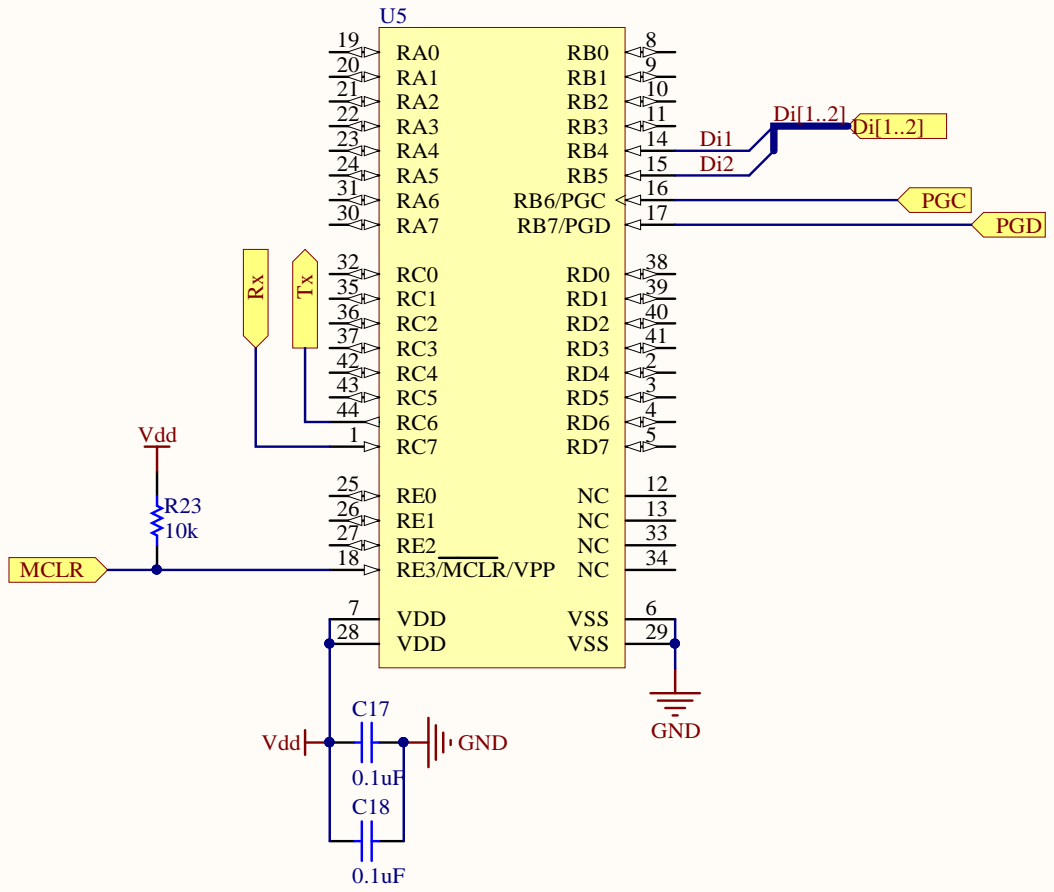
[picture p86: page 1]

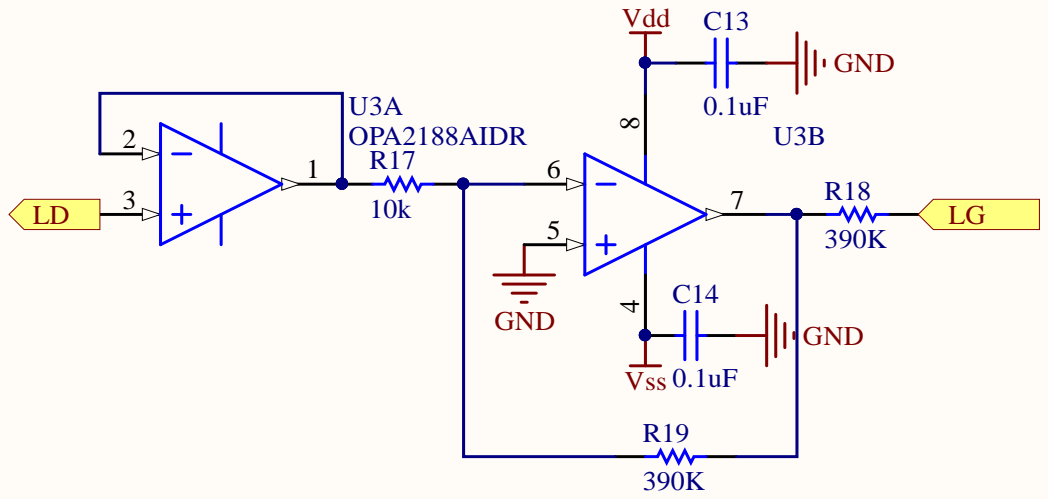
[picture p87: page 2]

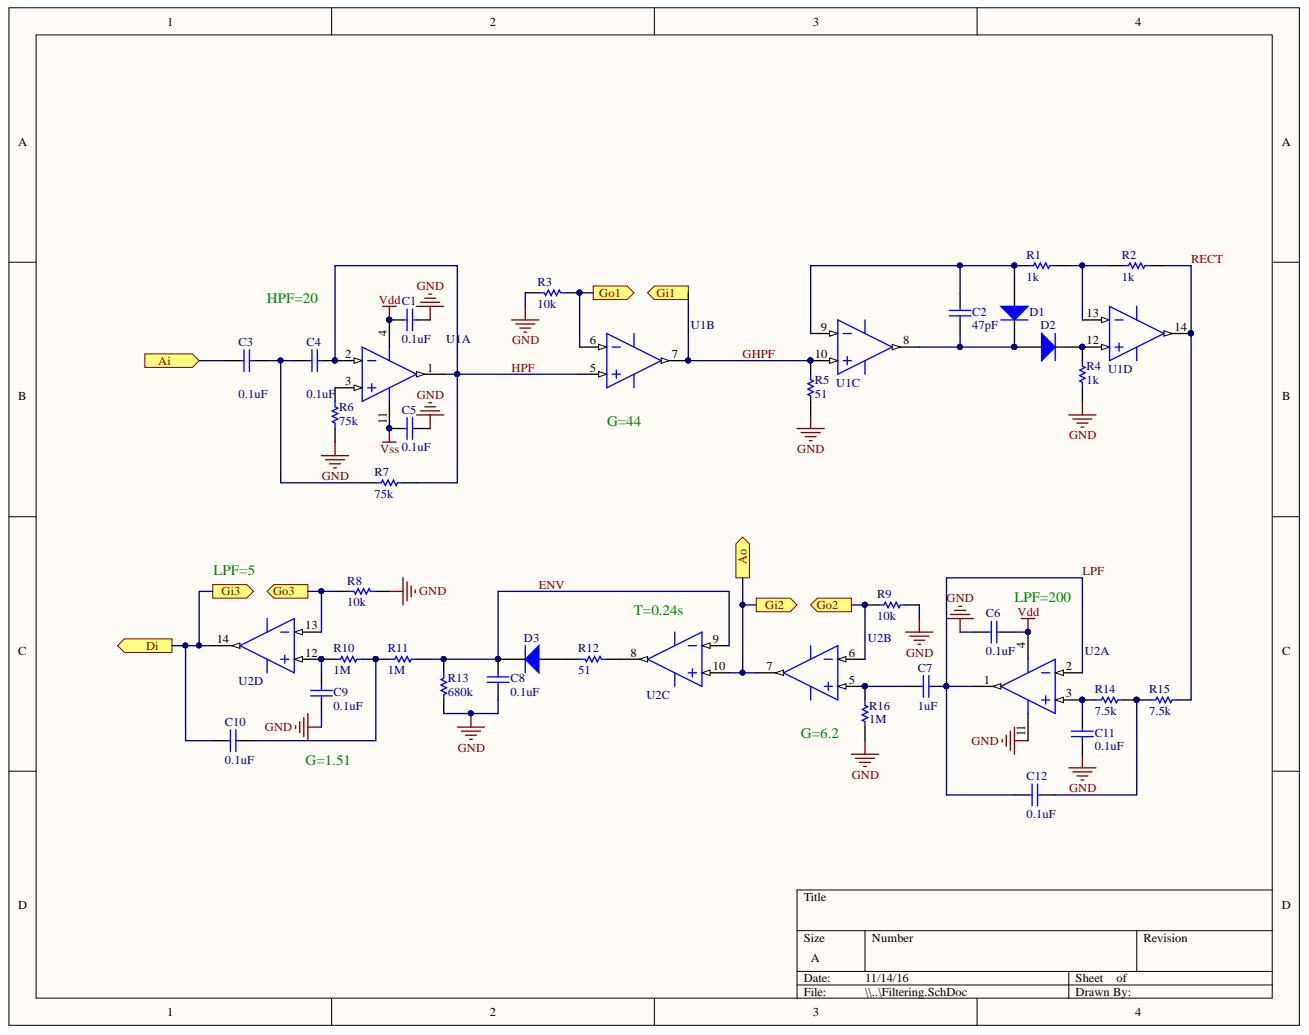
[picture p88: page 3]

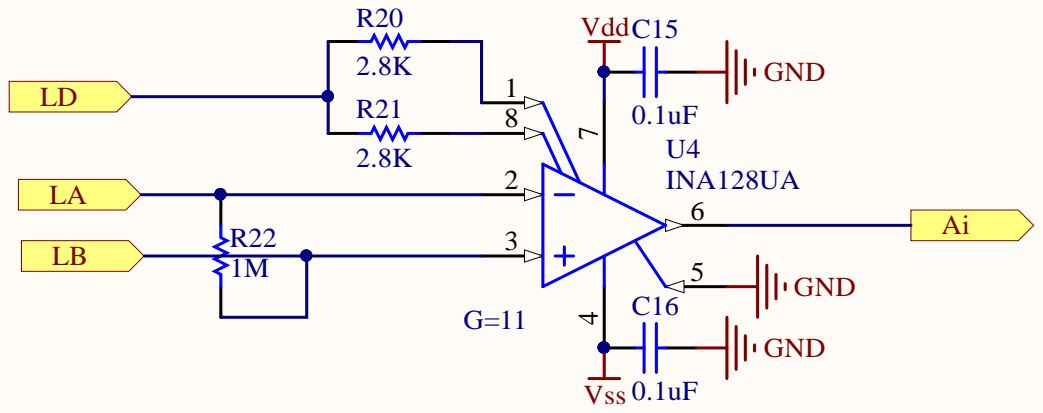
[picture p89: page 4]

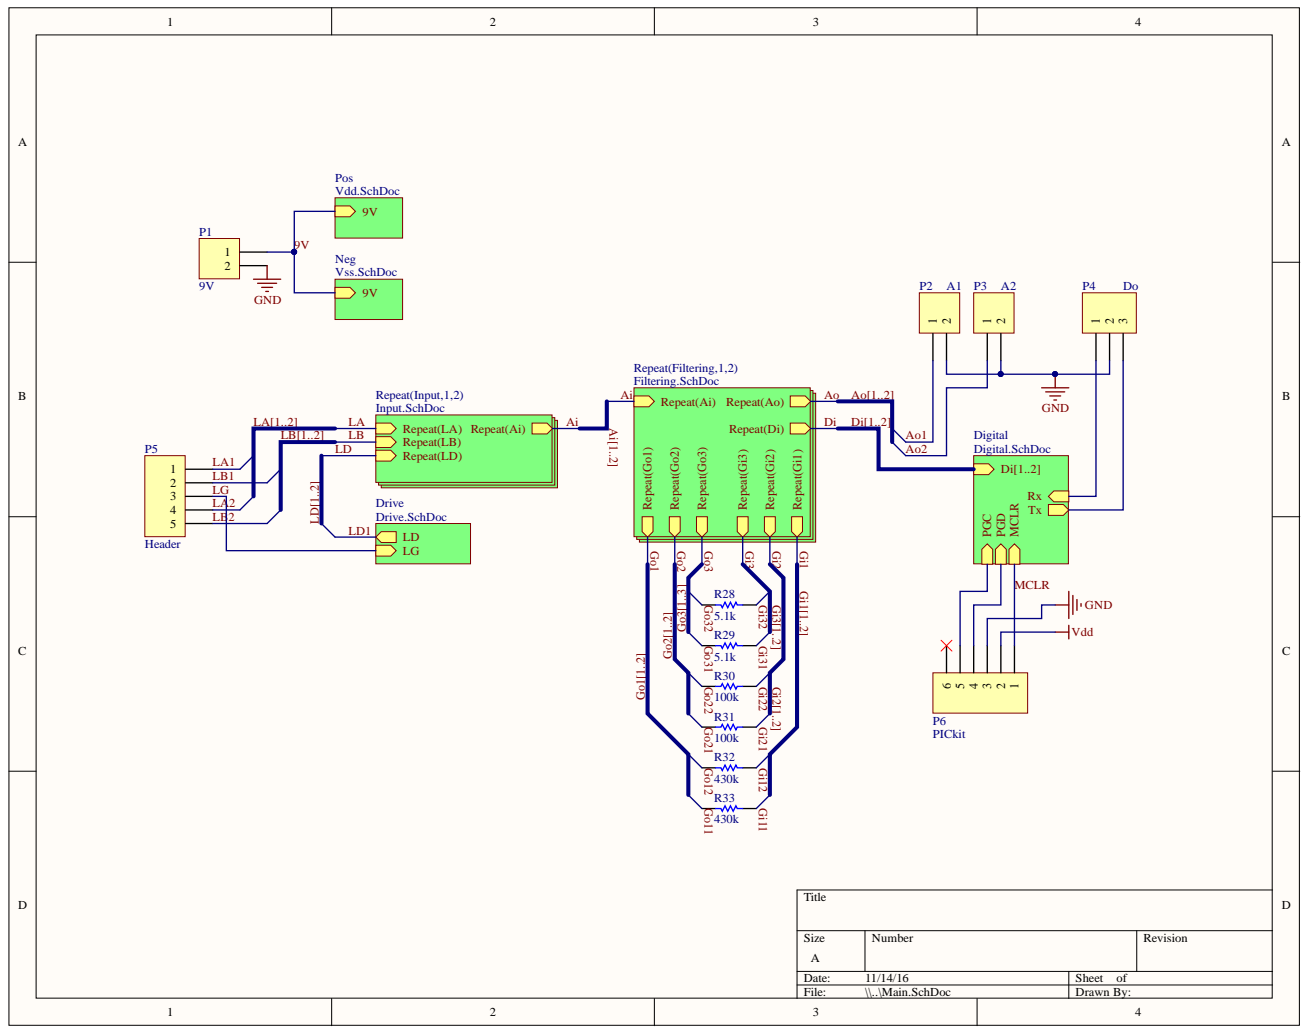
[picture p90: page 5]

Repe
Input
i Repeat(LA) Repeat(Ai)

G N D t a l t a l . S chDoc

.2] | L B
L D

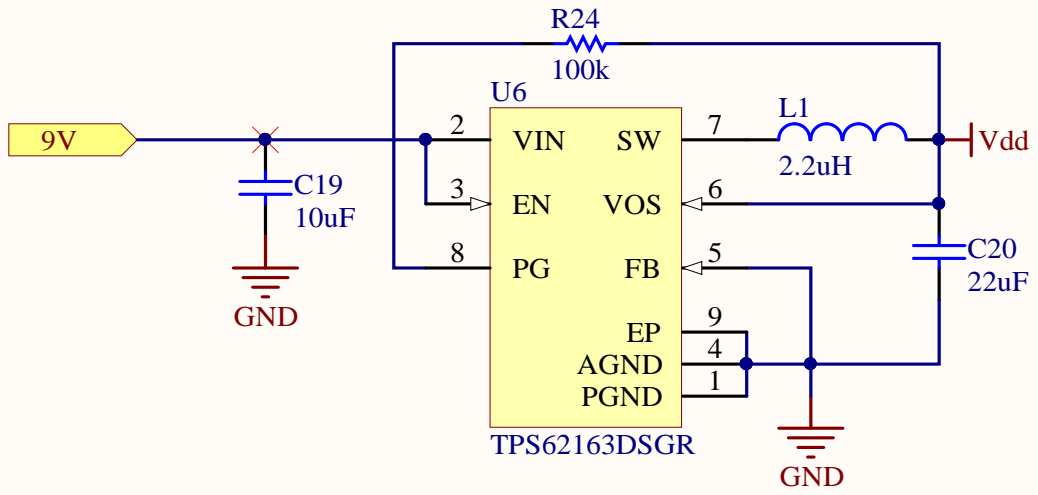
[picture p91: page 6]

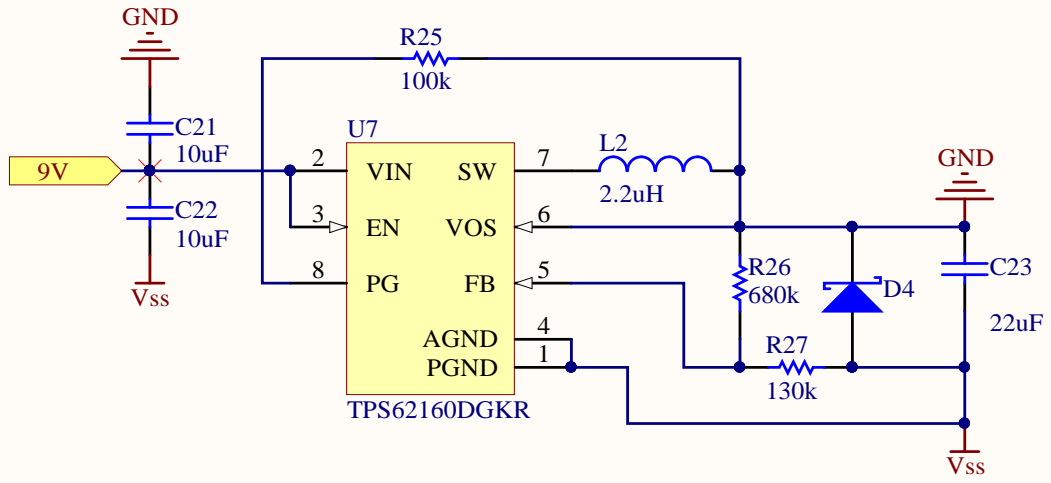
[picture p92: page 7]

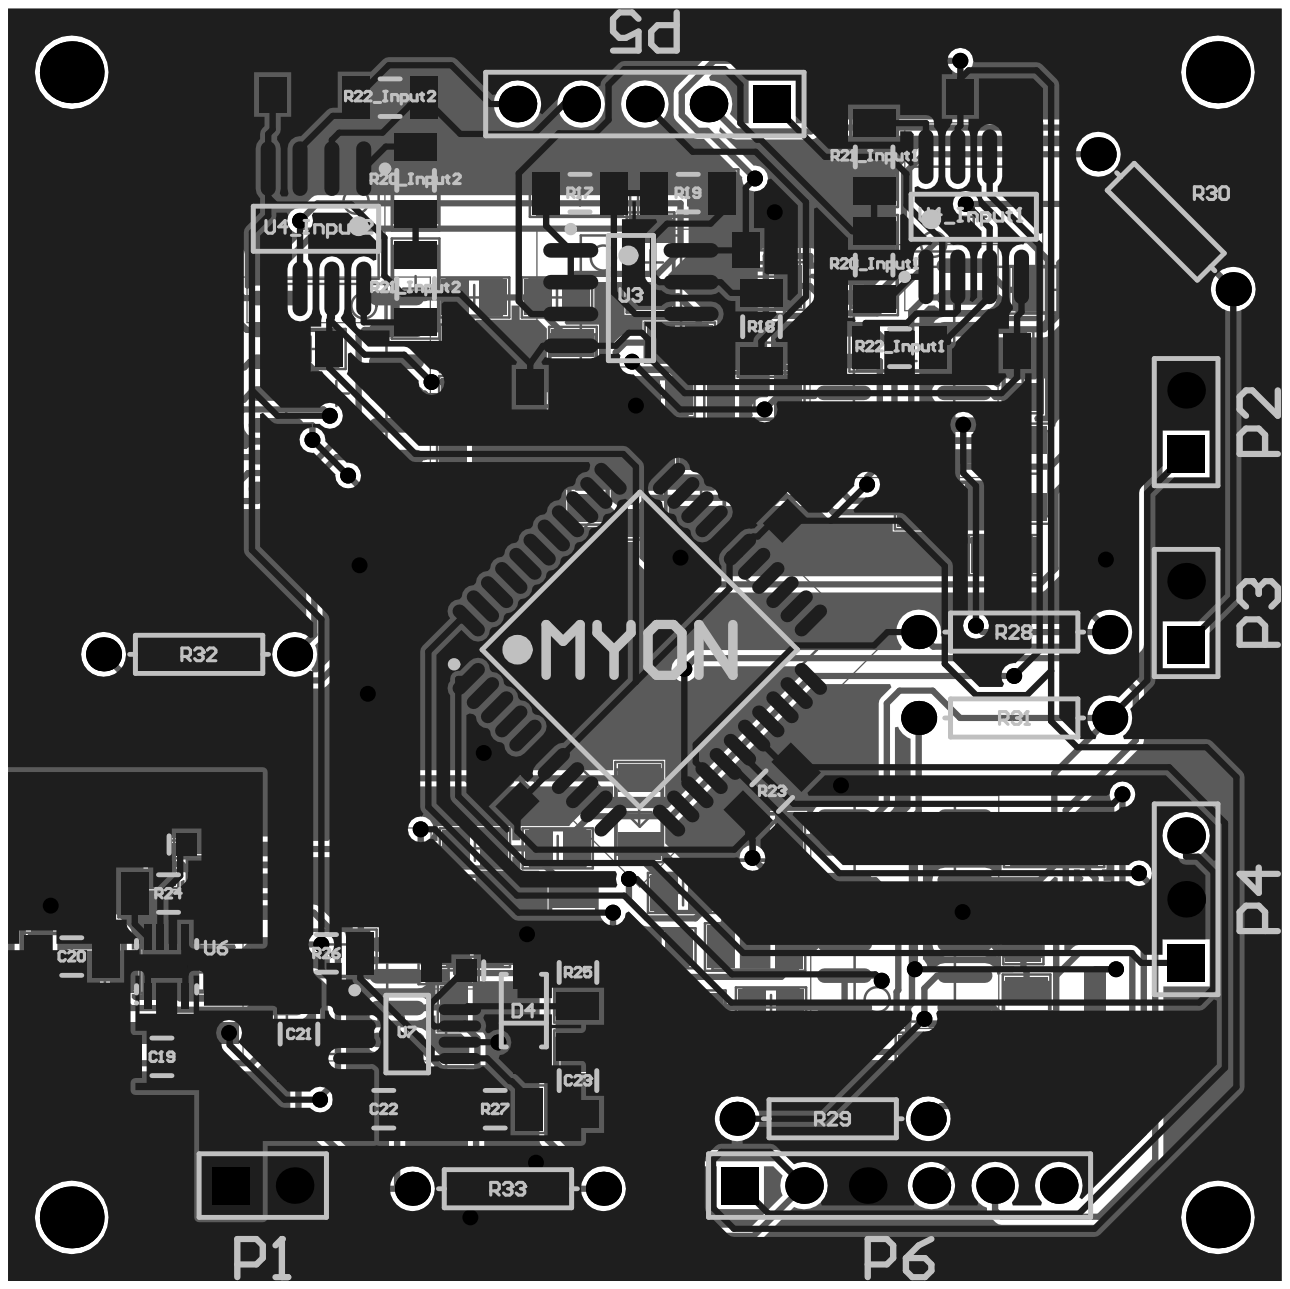
[picture p93: page 8]

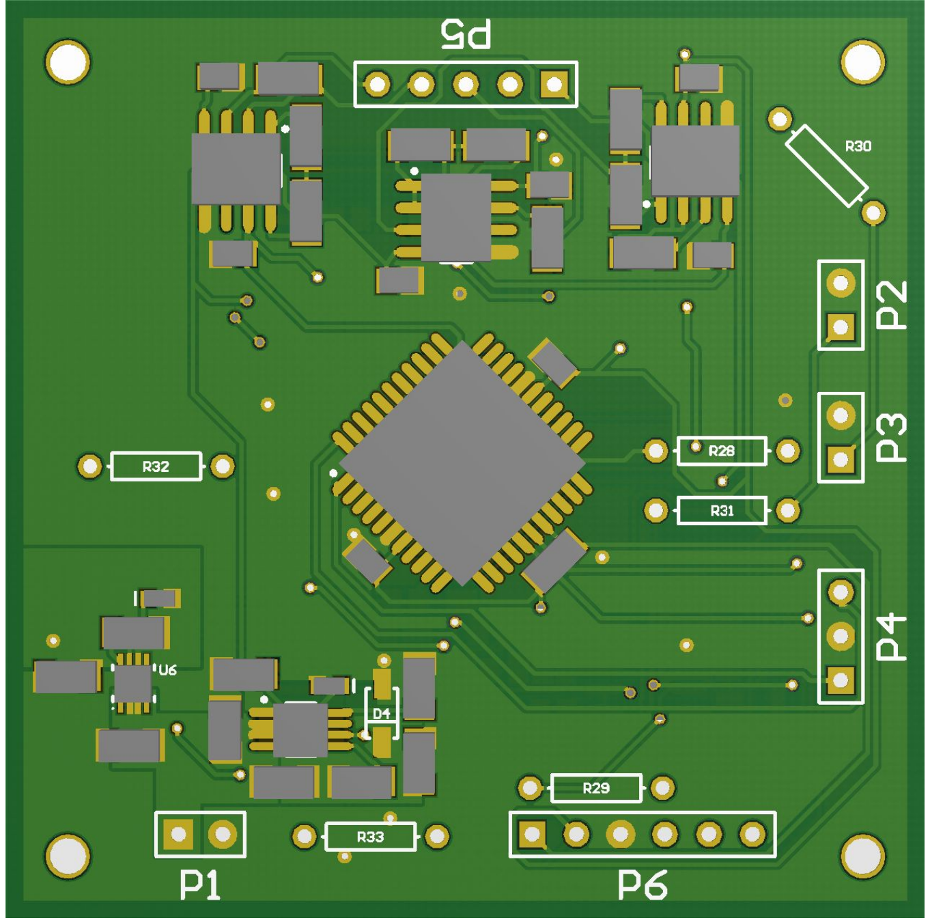
[picture p94: page 9]

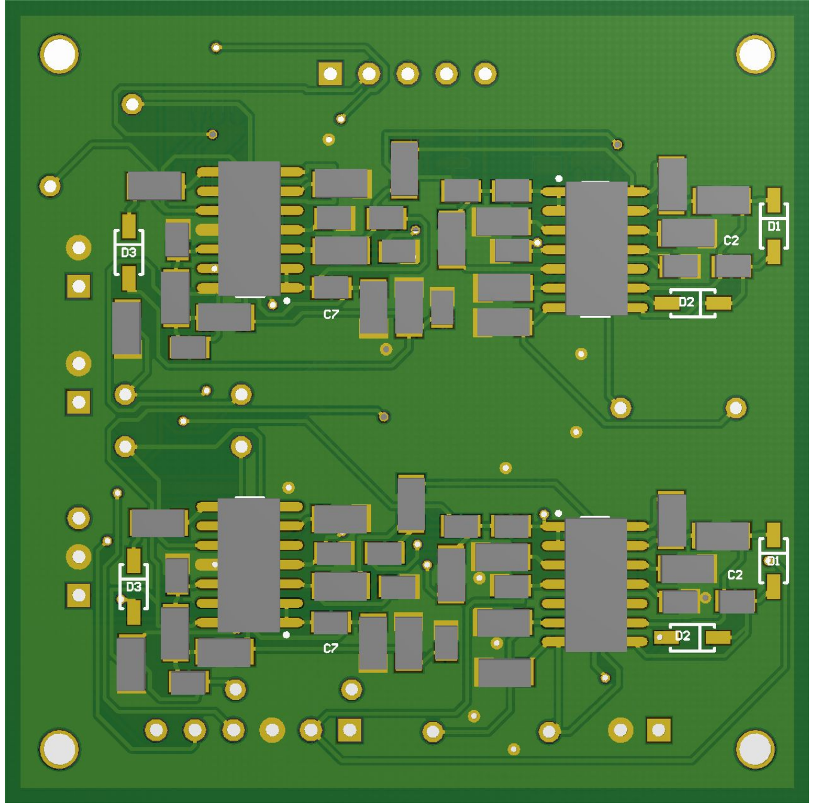
[picture p95: page 10]

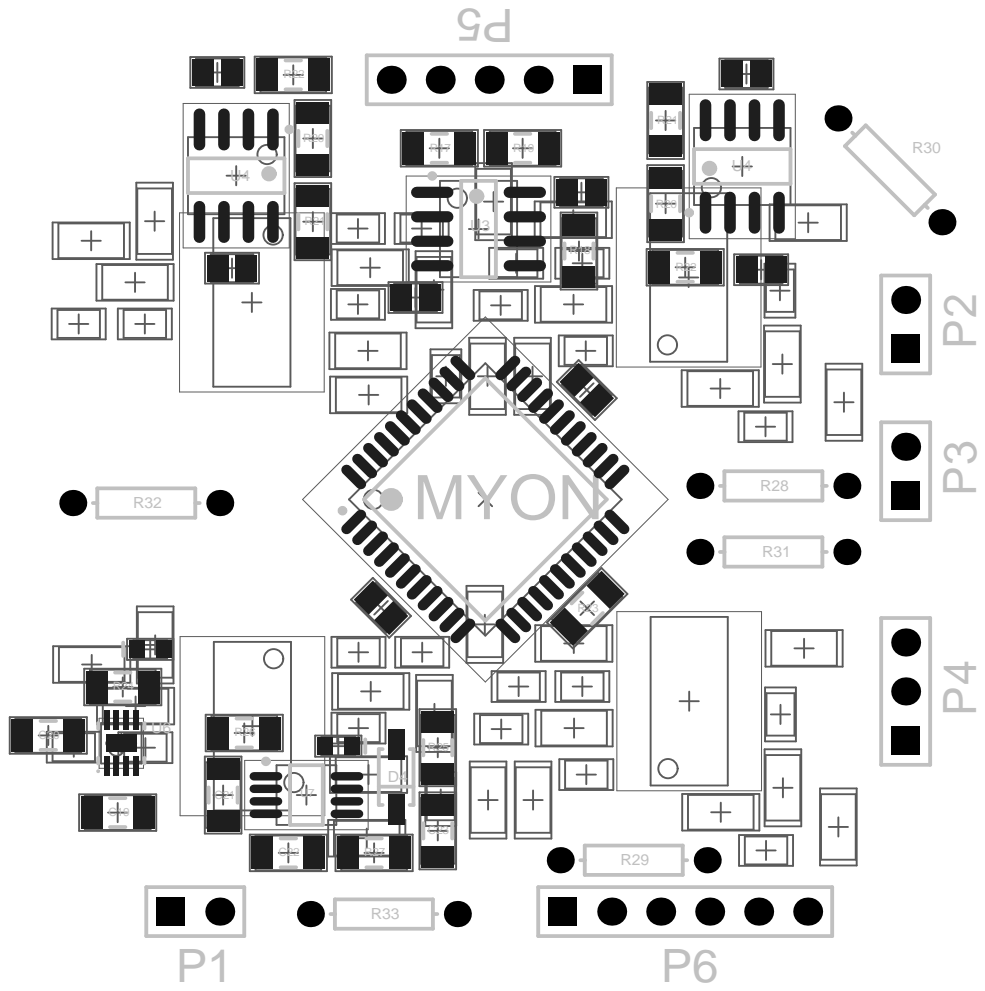
[picture p96: page 11]

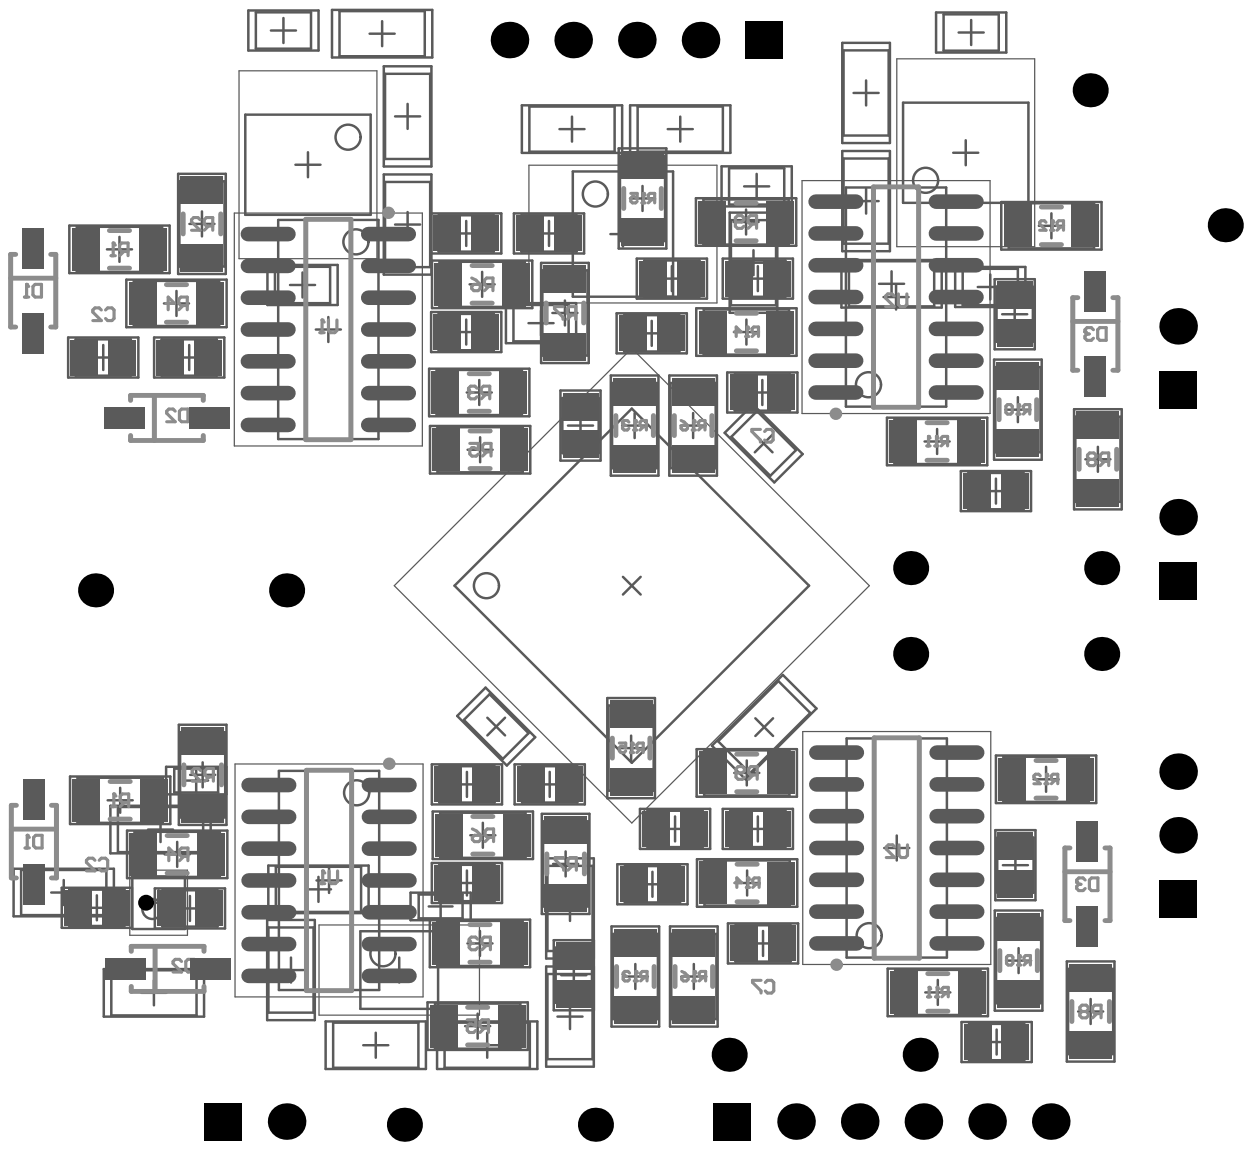
[picture p97: page 12]

## Electrical Rules Check Repor

Class | Document | Message Successful Compile for Electronics.PrjPcb
Monday 14 Nov 2016 2:24:36 PM | Page 1 of 1

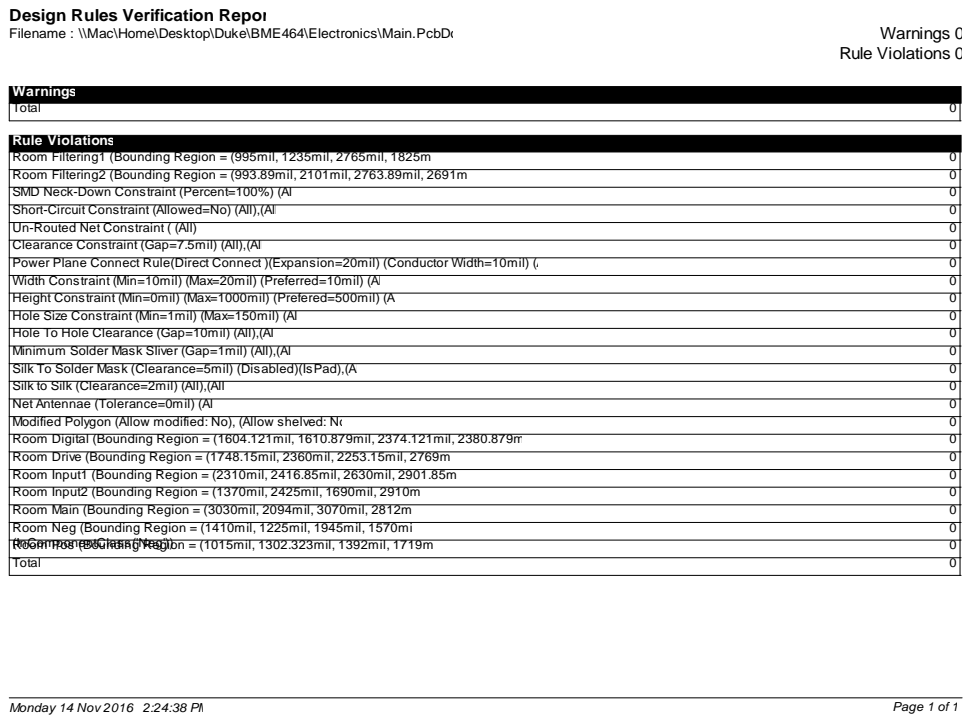
[picture p98: page 14]

Design Rules Verification Repor

Rule Violations
Room Neg (Bounding Region = (1410mil, 1225mil, 1945mil, 1570mi
(InComponentClass('Neg'))
