imatlopez/EMG-Decoder/(list of files, drawings)

Other design files:
Electronics/Digital.SchDoc
Electronics/Drive.SchDoc
Electronics/Electronics.PrjPcb
Electronics/Filtering.SchDoc
Electronics/Input.SchDoc
Electronics/Main.PcbDoc
Electronics/Main.SchDoc
Electronics/PowerTest/Digital.SchDoc
Electronics/PowerTest/PCB.PcbDoc
Electronics/PowerTest/Power.SchDoc
Electronics/PowerTest/PowerTest.PrjPcb
Electronics/PowerTest/Vdd.SchDoc
Electronics/PowerTest/Vss.SchDoc
Electronics/Vdd.SchDoc
Electronics/Vss.SchDoc
