imatlopez/EMG-Decoder/Software/Final Codes/main4_no_LCD.c

/*
 * BME 464 - EMG Decoder
 *
 * Decodes signals from two EMG leads and sends result to an external interface
 * 
 */

#include "Lcd.h"
#include <delays.h> //delay header
#include <p18f46k22.h> //chip header
#include <stdio.h> //enable 

#pragma config FOSC = INTIO67   // Internal OSC block, Port Function on RA6/7
// #pragma config WDTEN = SWON     // Watch Dog Timer controlled by SWDTEN bit
#pragma config WDTEN = OFF      // Watch Dog Timer disabled. SWDTEN no effect
// #pragma config WDTPS = 512      // WDT Postscale of 1:512, equivalent to 2 secs
#pragma config XINST = OFF      // Instruction set Extension and indexed Addressing mode disabled

//Define statements
// #define Running 0
// #define Sleeping 1 

//Variable definitions
int oldRawV1; // old raw signal from lead 1
int oldRawV2; // old raw signal from lead 2
int oldV1; // old processed signal from lead 1
int oldV2; // old processed signal from lead 2
int V1;
int V2;
int thres1; // magnitude threshold
int thres2; // magnitude threshold
int rslope1; // rising slope threshold
int dslope1; // descending slope threshold
int rslope2; // rising slope threshold
int dslope2; // descending slope threshold
int hyst; // hysteresis range
int state;
int t; // sampling period (x10^-2 seconds)
int EMG;

//Function definitions
void SysInit(void);
void Calibrate(void);
int GetData(int channel);
int Debounce(int raw, int oldraw, int olddeb, int channel);
void GetDataAndDebounce(void);
int Decode(void);
void Transmit(int info);

void main(void)
{

    //Initialize
    SysInit();
	Calibrate();

    // EMG Decoder Loop
    while(1) {
    	//If the output was 0 before
    	if(EMG==3){
            GetDataAndDebounce();
			EMG=(2*V1)+V2; //will keep looping and do nothing as long as EMG~=0
			if(EMG==0){
				Transmit(EMG);
			}
            else{
                EMG=3;
            }
        }
    	//If the output was something else, need to go back to 0 first
		else{
		GetDataAndDebounce();
		EMG=Decode(); // Decode
        Transmit(EMG); // Print value to screen or communication
		}
		Delay10KTCYx(t);  // Delay t/100 seconds
	};
}

//Initialize necessary systems
void SysInit(void)
{
    OSCCON=0b01010110; //4 MHz internal oscillator

    //Set up ADC channel on RA1
    ANSELAbits.ANSA1 = 1;
    TRISAbits.RA1 = 1; //Analog in

    //Set up ADC channel on RA2 
    ANSELAbits.ANSA2 = 1;
    TRISAbits.RA2 = 1; //Analog in

    //Set up ADC parameters
    ADCON2bits.ACQT=001; //2 TAD
    ADCON2bits.ADCS=010; //FOSC/32
    ADCON2bits.ADFM=1; //Right justified***
    ADCON0bits.ADON=1; //Turn on A/D

	//Set up sleep mode
	// OSCCONbits.IDLEN = 0;

	//Set up Watchdog Timer
	// WDTCONbits.SWDTEN = 1; // Turn on WDT

    //Set up LCD
    ANSELD = 0x00;
    TRISD = 0x00; //Digital out
    LCDInit(); //Start LCD
    LCDWriteStr("Starting device...");

	//Set up async EUSART    
	TRISCbits.RC6 = 1; //Initialize TX pin (transmission) 
	TRISCbits.RC7 = 1; //Initialize RX pin (reception)
	TXSTA1bits.BRGH=0; //Use low     
	BAUDCON1bits.BRG16=0; //Use 8-bit transmission 
	SPBRG1=5;   //Set baud rate to 10417    
	TXSTA1bits.SYNC=0; //Specify async mode    
	RCSTA1bits.SPEN=1; //Enable EUSART    
	TXSTA1bits.TXEN=1; //Enable transmission
    ANSELC=0x00;           
	RCSTA1bits.CREN=1; //Enable receiver
	
	//Reset variables
	oldRawV1=0;
	oldRawV2=0;
	oldV1=0;
	oldV2=0;
	state=0;

	//Configure variables (adjustable)
    //thres=300; //Initial threshold
    //hyst=100; //Hysteresis width
	t=5; //200 ms (1 corresponds to 10 ms)
    
    	//For testing
	    //Set up digital on RA3
    ANSELAbits.ANSA3 = 0; //Set to digital
    TRISAbits.RA3 = 0; //Set to output
PORTAbits.RA3=0;
}

//Calibration period to adjust for user/muscle activity
void Calibrate(void){
	int i;
	int old1;
	int old2;
	int raw1;
	int raw2;
	int max1;
	int min1;
	int max2;
	int min2;
	int slope;
	int rising1;
	int descend1;
	int rising2;
	int descend2;
    char str[4];
    // Initialize calibration
	LCDClear();
    LCDGoto(5,0);
	LCDPutByte(0);
    Delay10KTCYx(200); //Wait 2 seconds for system to settle
	old1=0;
	old2=0;
    max1=0;
    min1=1023;
    max2=0;
    min2=1023;
	rising1=0;
	descend1=0;
	rising2=0;
	descend2=0;
    // Calibrate mag and slope thresholds
	LCDGoto(5,0);
	LCDPutByte(8);
    for(i=0;i<100;i++){ //10 seconds of calibration data
    	//Channel 1 magnitude calibration
    	raw1=GetData(1); // Acquire voltage from channel 1
    	if(raw1>max1){
    		max1=raw1;
    	}
    	if(raw1<min1){
    		min1=raw1;
    	}
		// slope calibration
		slope = raw1-old1;
		if(slope>rising1)
			rising1 = slope;
		if(slope<descend1)
			descend1 = slope;
		old1 = raw1;
    	//Channel 2 magnitude calibration
		raw2=GetData(2); // Acquire voltage from channel 2
    	if(raw2>max2){
    		max2=raw2;
    	}
    	if(raw2<min2){
    		min2=raw2;
		}
		// slope calibration
		slope = raw2-old2;
		if(slope>rising2)
			rising2 = slope;
		if(slope<descend2)
			descend2 = slope;
		old2 = raw2;
		//Display raw value for Ch1
        LCDGoto(8,0);
		sprintf(str,"%04u",raw1);
        LCDPutChar(str[0]);
        LCDPutChar(str[1]);
        LCDPutChar(str[2]);
        LCDPutChar(str[3]);
        //Display raw value for Ch2
        LCDGoto(8,1);
        sprintf(str,"%04u",raw2); 
        LCDPutChar(str[0]);
        LCDPutChar(str[1]);
        LCDPutChar(str[2]);
        LCDPutChar(str[3]);
		Delay10KTCYx(t);
    }
    LCDGoto(5,0);
	LCDPutByte(1);
    //Need to figure this out
    thres1=min1+(max1-min1)*3/10;
    thres2=min2+(max2-min2)*3/10;
	rslope1 = rising1*0.6;
	dslope1 = descend1*0.7;
	rslope2 = rising2*0.6;
	dslope2 = descend2*0.7;
    //Ch1 mag thres
    LCDGoto(0,0);
	sprintf(str,"%04u",thres1);
    LCDPutChar(str[0]);
    LCDPutChar(str[1]);
    LCDPutChar(str[2]);
    LCDPutChar(str[3]);
    //Ch2 mag thres
	LCDGoto(0,1);
    sprintf(str,"%04u",thres2); 
    LCDPutChar(str[0]);
    LCDPutChar(str[1]);
    LCDPutChar(str[2]);
    LCDPutChar(str[3]);
}

// ADC sampling of EMG leads
int GetData(int channel) {
	int volt;
	if(channel==1){
		//Channel 1
		ADCON0bits.CHS=1; //Select RA1
		ADCON0bits.GO=1; //Start conversion
		while(ADCON0bits.GO==1){}; //Wait for finish
		volt=ADRESH;
		volt=(volt<<8) | ADRESL; //Make 10-bit
	}
	if(channel==2){
		//Channel2
		ADCON0bits.CHS=2; //Select RA2
		ADCON0bits.GO=1; //Start conversion
		while(ADCON0bits.GO==1){}; //Wait for finish
		volt=ADRESH;
		volt=(volt<<8) | ADRESL; //Make 10-bit
	}
	return volt;
}

// Process signal from each channel into either high or low
int Debounce(int raw, int oldraw, int olddeb, int channel){
    int thres;
	int slope;
	int risThres;
	int desThres;
	//Set threshold
	if(channel==1){
		thres=thres1;
		risThres=rslope1;
		desThres=dslope1;
	}
	if(channel==2){
		thres=thres2;
	    risThres=rslope2;
		desThres=dslope2;
	}
	// Find instantaneous slope
	slope = raw-oldraw; // unit: voltage units
	// Threshold is 15 V/s * 1023 units/5V = 3069 units/sec = 3.069 units/ms
	// slopeThres = 3.069;
	// If the signal was low before:
	if (olddeb==0){
		if ((slope>risThres) || (raw>thres && slope>0)){
			return 1;
		}
		else{
			return 0;
		}
	}
	// If the level was high before:
    if (olddeb==1){
		if((slope<0 && raw<thres) || (slope<desThres)){ //(slope<desThres) || (slope<0 && raw<Thresh)
            return 0;
        }
        else{
            return 1;
        }
    }
}

void GetDataAndDebounce(void){
	int rawV1; // raw signal from lead 1
	int rawV2; // raw signal from lead 2
	
	rawV1 = GetData(1); // Acquire voltage from channel 1
	rawV2 = GetData(2); // Acquire voltage from channel 2
	V1=Debounce(rawV1, oldRawV1,oldV1,1); //Process voltage from channel 1
	V2=Debounce(rawV2,oldRawV2,oldV2,2); //Process voltage from channel 2
	//Update values
	oldRawV1=rawV1;
	oldV1=V1;
	oldRawV2=rawV2;
	oldV2=V2;

}


// Decode the two digital signals
int Decode(void){
	int outNum1;
	int outNum2;
	outNum1 = (2*V1)+V2;
	//Coming from all channels low
	//Keep going if nothing is high
	if (outNum1==0){
		return 0;
	}
	// if both are high => change command
	if (outNum1==3){
		return 3;
	}
	// if only one of them are high =>wait and check
	else{
		Delay10KTCYx(t); // wait extra cycle
		GetDataAndDebounce();
		outNum2 = (2*V1)+V2;
		if(outNum2==outNum1){
			return outNum2; //Return 1 or 2
		}
		if(outNum2==3){
		return 3;
		}
		else{
		return 0;
		}
	}
}



// Transmit the result to external interface
void Transmit(int info){
    // Display EMG
	LCDGoto(13,1);
	LCDPutByte(info);
	// Transmit EMG
	TXREG1 = info; // Set info to be transmitted
    if(info==1){
        PORTAbits.RA3=1;
    }
    else{
        PORTAbits.RA3=0;
    }
}
