imatlopez/EMG-Decoder/(commit log)

2016-09-15 Added first files
    [Cap18.ipt, DIP8.ipt]
2016-09-19 Order Form
    [PartsOrderForm_BME464L.xlsx]
2016-09-20 Revert "Add files via upload"
    [Myon Deco.SLDPRT]
2016-09-20 Casing Mock-Up
    [Myon Deco.SLDPRT]
2016-09-20 Vector-Graphics Logo
    Logo used for extruded logo in SolidWorks
    [logo.dwg]
2016-09-22 Order Form Typo
    [Build_Order.xlsx]
2016-09-22 Added Altium Project
    [Electronics.PrjPcb, Sheet1.SchDoc]
2016-09-23 Updated Schematics
    [Build_Order.xlsx, Electronics.PrjPcb, Filtering.SchDoc, Input.SchDoc, LPF.SchDoc, Main.SchDoc, Power.SchDoc, Rectifier.SchDoc]
2016-09-25 Shem Update
    [Digital.SchDoc, Electronics.PrjPcb, Filtering.SchDoc, Input.SchDoc, Main.SchDoc, Power.SchDoc, Rectifier.SchDoc]
2016-09-26 Altium revision
    [Build_Order.xlsx, Digital.SchDoc, Electronics.PrjPcb, Filtering.SchDoc, Input.SchDoc, Main.SchDoc]
2016-09-26 More Altium updates
    [Filtering.SchDoc, Input.SchDoc]
2016-09-27 Buck Converter
    [Build_Order.xlsx, Digital.SchDoc, Electronics.PrjPcb, Filtering.SchDoc, Input.SchDoc, Main.SchDoc, Power.SchDoc]
2016-09-28 Error Check Altium
    [Digital.SchDoc, Electronics.PrjPcb, Filtering.SchDoc, Input.SchDoc, Main.SchDoc]
2016-09-29 Fixed Filt out problem
    [Digital.SchDoc, Electronics.PrjPcb, Filtering.SchDoc, Input.SchDoc, Main.SchDoc, Power.SchDoc]
2016-09-30 Updated rectifier
    [Digital.SchDoc, Electronics.PrjPcb, Filtering.SchDoc, Input.SchDoc, Main.SchDoc, Power.SchDoc]
2016-09-30 Updated rectifier 2
    [Digital.SchDoc]
2016-09-30 Updated BOM
    [Build_Order.xlsx, Digital.SchDoc, Electronics.PrjPcb, Filtering.SchDoc, Input.SchDoc, Main.SchDoc, Power.SchDoc]
2016-09-30 Fixed Filter Frequencies
    [Build_Order.xlsx, Filtering.SchDoc]
2016-10-03 Added envelope detecter
    [Build_Order.xlsx, Digital.SchDoc, Filtering.SchDoc]
2016-10-05 Replaced OPA221 w/ OPA188
    [Build_Order.xlsx, Digital.SchDoc, Electronics.PrjPcb, Filtering.SchDoc, Input.SchDoc, Power.SchDoc]
2016-10-05 Finalized Footprints
    [Build_Order.xlsx, Digital.SchDoc, Electronics.PrjPcb, Filtering.SchDoc, Input.SchDoc, Main.PcbDoc, Main.SchDoc, Power.SchDoc]
2016-10-06 Updated small components
    [Build_Order.xlsx, Digital.SchDoc, Electronics.PrjPcb, Filtering.SchDoc, Input.SchDoc, Main.PcbDoc]
2016-10-07 Reduced OpAmps
    [Build_Order.xlsx, Digital.SchDoc, Electronics.PrjPcb, Filtering.SchDoc, Input.SchDoc, Main.PcbDoc, Main.SchDoc, Power.SchDoc]
2016-10-15 Envelope design update
    [Build_Order.xlsx, Electronics.PrjPcb, Filtering.SchDoc, Input.SchDoc, Main.PcbDoc, Power.SchDoc]
2016-10-16 PCB Layout
    [Filtering.SchDoc, Input.SchDoc, Main.PcbDoc, Power.SchDoc]
2016-10-17 PCB Placements
    [Filtering.SchDoc, Main.PcbDoc]
2016-10-19 Updated PCB
    [Main.PcbDoc]
2016-10-19 PCB w/o Dout
    [Main.PcbDoc]
2016-10-20 Expanded outputs
    [Main.PcbDoc]
2016-10-20 More outputs!
    [Assembly Testpoint Report for Main.csv, Electronics.PrjPcb, Main.DWG, Main.PcbDoc, Main.step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]
2016-10-20 Electronics cleanup
    [Assembly Testpoint Report for Main.csv, Electronics.PrjPcb, Main.DWG, Main.step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]
2016-10-22 PCB Draft
    [Build_Order.xlsx, Digital.SchDoc, Drive.SchDoc, Electronics.PrjPcb, Filtering.SchDoc, Input.SchDoc, Main.DWG, Main.PcbDoc]
2016-10-24 Added Power Testing Files
    [Digital.SchDoc, LPF.SchDoc, PCB.PcbDoc, Power-Test_Order.xlsx, Power.SchDoc, PowerTest.PrjPcb, Rectifier.SchDoc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]
2016-10-24 Track Clean-Up
    [Main.DWG, Main.PcbDoc, Main.step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]
2016-10-25 Added Caps
    [Digital.SchDoc, Electronics.PrjPcb, Main.DWG, Main.PcbDoc, Main.step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]
2016-10-31 Update STEP
    [Electronics.PrjPcb, Main.DWG, Main.step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]
2016-11-01 Updated Holes
    [Main.DWG, Main.PcbDoc, Main.step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]
2016-11-04 Added 2nd Drive
    [Main.DWG, Main.PcbDoc, Main.SchDoc, Main.step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]
2016-11-05 MultiLayered Board
    [Build_Order.xlsx, Digital.SchDoc, Drive.SchDoc, Filtering.SchDoc, Input.SchDoc, Main.DWG, Main.PcbDoc, Main.SchDoc]
2016-11-07 Mech update
    [1608_0603__10.sldprt, 1608_0603__11.sldprt, 1608_0603__12.sldprt, 1608_0603__13.sldprt, 1608_0603__7.sldprt, 1608_0603__8.sldprt, 1608_0603__9.sldprt, AXIAL_0_3_1.sldprt]
2016-11-07 Update to Bottomplate
    [Draft4bottomplate.STL, Draft5Cover.SLDPRT, Draft5Cover.STL]
2016-11-07 Updated Build Order
    [Build_Order.xlsx]
2016-11-07 Dropped 2nd LD
    [Main.DWG, Main.PcbDoc, Main.SchDoc, Main.step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]
2016-11-09 Updates to case
    [Draft5BottomPlate.SLDPRT, Draft5BottomPlate.STL, Draft5Cover.SLDPRT, Draft5Cover.STL, Main.step, NOV7ASSEMB.SLDASM, PCB.SLDPRT, PCB.STL]
2016-11-10 Code changes
    Add calibration for main1.c
    Add debounce for main3.c
2016-11-11 Vdd update
    [Last_Order.xlsx, Main.PcbDoc, Mech_Order.xlsx, Vdd.SchDoc]
2016-11-11 Updated Gerbers
    [Electronics.PrjPcb, Main.DWG, Main.step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]
2016-11-11 Oops Update
    [Last_Order.xlsx, Main.DWG, Main.PcbDoc, Main.step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]
2016-11-11 Layer Reduction $$$
    [Main.DWG, Main.PcbDoc, Main.step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]
2016-11-14 Clearance Expansion to 7
    [Main.DWG, Main.PcbDoc, Main.step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]
2016-11-14 Second Fix
    [Digital.SchDoc, Main.DWG, Main.PcbDoc, Main.step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]
2016-11-14 Another Fix :(
    [Main.DWG, Main.PcbDoc, Main.step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]
2016-11-28 Added Testing Sheet
    [Build_Order.xlsx, Main.PcbDoc, Testing.xlsx]
2016-12-06 Testing Data/Code
    [Testing.xlsx]
2016-12-06 Circuit Spec Analysis
2016-12-09 Final Mechanical Drawings and Photos
    [Draft5BottomPlate.SLDDRW, Draft5BottomPlate.SLDPRT, Draft5BottomPlate.STL, Draft5Cover.SLDDRW, Draft5Cover.SLDPRT, Draft5Cover.STL, Draft6BottomPlate.SLDPRT, Draft6BottomPlate.STL]
2016-12-09 Final Parts List
    [Final_List.xlsx]
2016-12-09 Fixed list
    [Final_List.xlsx]
2016-12-11 Font size
    [Electronics.PrjPcb]
